mekatronik-achmadi/spion_selector/docs/docs.tex

\documentclass[11pt,fleqn]{book} % Default font size and left-justified equations

\usepackage[top=3cm,bottom=3cm,left=3.2cm,right=3.2cm,headsep=10pt,a4paper]{geometry} % Page margins

\usepackage{xcolor} % Required for specifying colors by name
\definecolor{ocre}{RGB}{243,102,25} % Define the orange color used for highlighting throughout the book

% Font Settings
\usepackage{avant} % Use the Avantgarde font for headings
%\usepackage{times} % Use the Times font for headings
\usepackage{mathptmx} % Use the Adobe Times Roman as the default text font together with math symbols from the Sym­bol, Chancery and Com­puter Modern fonts

\usepackage{microtype} % Slightly tweak font spacing for aesthetics
\usepackage[utf8]{inputenc} % Required for including letters with accents
\usepackage[T1]{fontenc} % Use 8-bit encoding that has 256 glyphs

% Bibliography
% \usepackage[style=alphabetic,sorting=nyt,sortcites=true,autopunct=true,babel=hyphen,hyperref=true,abbreviate=false,backref=true,backend=biber]{biblatex}
% \addbibresource{bibliography.bib} % BibTeX bibliography file
% \defbibheading{bibempty}{}

% Index
\usepackage{calc} % For simpler calculation - used for spacing the index letter headings correctly
% \usepackage{makeidx} % Required to make an index
% \makeindex % Tells LaTeX to create the files required for indexing

%----------------------------------------------------------------------------------------

\input{structure} % Insert the commands.tex file which contains the majority of the structure behind the template

\newcommand{\itab}[1]{\hspace{0em}\rlap{#1}}
\newcommand{\tab}[1]{\hspace{.2\textwidth}\rlap{#1}}

\begin{document}

\begingroup
\thispagestyle{empty}
  \AddToShipoutPicture*{\put(6,5){}} % Image background
  \centering
  \vspace*{9cm}
  \par\normalfont\fontsize{35}{35}\sffamily\selectfont
  Bad Rear View Mirror Rejection System\par % Book title
  \vspace*{1cm}
  {\Huge Rancangan Teknis}\par % Author name
  \vspace*{1cm}
  {\large Laboratorium Rekayasa Fotonika}\par
  {\large Teknik Fisika}\par
  {\large Institut Teknologi Sepuluh November}\par
  {\large 2014}\par
\endgroup

\newpage
~\vfill
\thispagestyle{empty}
% \noindent Copyright \copyright\ 2013 John Smith\\ % Copyright notice
% \noindent \textsc{Published by Publisher}\\ % Publisher
% \noindent \textsc{book-website.com}\\ % URL
\noindent Written by Achmadi @2014 \\
\noindent Licensed under the Creative Commons Attribution-NonCommercial 3.0 Unported License (the ``License''). You may not use this file except in compliance with the License. You may obtain a copy of the License at \url{http://creativecommons.org/licenses/by-nc/3.0}. Unless required by applicable law or agreed to in writing, software distributed under the License is distributed on an \textsc{``as is'' basis, without warranties or conditions of any kind}, either express or implied. See the License for the specific language governing permissions and limitations under the License.\\ % License information
% \noindent \textit{First printing, March 2013} % Printing/edition date

\newpage
\chapterimage{chapter_head_1.pdf} % Table of contents heading image
\pagestyle{empty} % No headers
\tableofcontents % Print the table of contents itself
\cleardoublepage % Forces the first chapter to start on an odd page so it's on the right
\pagestyle{fancy} % Print headers again

\newpage
\chapterimage{chapter_head_2.pdf} % Chapter heading image
\chapter{Development}
\section{Platform}
\begin{flushleft}
\hspace{10pt} Dalam proyek ini menggunakan platform yang bersifat opensources, kecuali dalam mendesain bagian mekanis.
Keuntungan dalam menggunakan platform yang bersifat opensources antara lain:

\itab{-Gratis dan Legal.}\\
\itab{-Dukungan penuh komunitas.}\\
\itab{-Kemudahan modifikasi software.}\\
\itab{-Kemampuan software opensources untuk development.}\\

\hspace{10pt} Untuk pihak pengembang lain yang berencana ikut mengembangkan dapat mengambil seluruh proyek di repository proyek berbasis Git di alamat:\\
\vspace{5pt}
\url{https://github.com/mekatronik-achmadi/spion\_selector}\\
\vspace{5pt}
\end{flushleft}

\section{Software}
\begin{flushleft}
 \hspace{10pt} Berikut adalah daftar aplikasi yang digunakan dalam proyek ini:\\
 \vspace{5pt}
 \textbf{LinuxMint}\\
 \hspace{10pt} LinuxMint adalah operating system yang berbasis kernel Linux dan paket manajemen Debian/Ubuntu.
 Disarankan untuk menggunakan sistem Graphical User Interface (GUI) jenis KDE, Cinnamon, maupun MATE.\\
 LinuxMint dapat di download di alamat:\\
 \vspace{5pt}
 \url{http://www.linuxmint.com/download.php}\\
 \vspace{5pt}
 Selain menggunakan LinuxMint, alternatif operating system lain yang disarankan adalah:\\
 \itab{-Ubuntu dengan GUI berjenis Unity. Dapat didownload di \url{http://www.ubuntu.com/download/desktop}}\\
 \itab{-Kubuntu dengan GUI berjenis KDE. Dapat didownload di \url{http://www.kubuntu.org/getkubuntu}}\\
 \itab{-Raspbian yang dijalankan di board RaspberryPi.}\\
 Dapat di didownload di \url{http://www.raspberrypi.org/downloads/}\\
 \vspace{5pt}
 \hspace{10pt} Operating system Raspbian dikhususkan untuk dijalankan di sistem tertanam (Embedded System) berbasis RaspberryPi, bukan untuk komputer/laptop umum.
 Raspbian merupakan operating system berbasis Debian sehingga secara teknis instalasinya akan sama dengan operating system lainnya.
 Namun tidak disarankan menggunakan Debian maupun turunan langsungnya (kecuali Raspbian) mengingat versi software yang tersedia kurang update.
 Untuk mengupdate daftar paket dari repository yang telah diatur, hubungkan LinuxMint ke internet dan gunakan perintah berikut di terminal:\\
 \vspace{5pt}
 \framebox[100pt]{sudo apt-get update}
 
 \vspace{5pt}
 \textbf{Octave}\\
 \hspace{10pt} GNU Octave adalah bahasa interpretasi (kebalikan dari kompilasi) level tinggi,utamanya digunakan untuk komputasi numerik. 
 GNU Octave menyediakan kemampuan untuk menemukan solusi numerik baik untuk masalah linear maupun non-linier, termasuk juga untuk experimen numerik. 
 Selain itu juga menyediakan kemampuan grafis yang memadai untuk visualisasi dan manipulasi data. 
 Octave secara umum digunakan melalui interface terminal yang interaktif, tapi dapat pula digunakan untuk program non-interaktif. 
 Bahasa interpretasi Octave sangat mirip dengan Matlab sehingga skrip dari kedua software tersebut dapat saling bertukar.
 Octave memiliki kemampuan setara dengan Matlab,sekalipun belum memiliki fitur seperti Simulink dan GUI.
 
 \hspace{10pt} Octave pertama kali ditulis oleh John W. Eaton ditahun 1988 dalam bahasa C++. 
 Octave dirilis oleh GNU Project, sebuah proyek international pengembangan software gratis dan opensource yang dipimpin oleh R. Stallman. 
 Kini Octave telah menjadi software yang dapat dijalankan di Linux, Windows, Mac,maupun Android. 
 Octave tersedia dalam 19 bahasa berbeda dengan English US sebagai bahasa default. 
 Octave dirilis sebagai software OpenSource dengan lisensi GNU GPL sehingga bersifat legal dan gratis.
 Penjelasan lebih lanjut akan dilanjutkan di bab Octave tersendiri.\\
 
 \hspace{10pt} Lebih lanjut tentang octave dapat dikunjungi di situs wiki: \url{http://wiki.octave.org/Main_Page}.
 
 \vspace{5pt}
 \textbf{OpenCV}\\
 \hspace{10pt} Pustaka OpenCV (Open Computer Vision) merupakan pustaka pemrograman berbasis C/C++/Python yang berisi fungsi-fungsi untuk akuisisi dan pengolahan citra.
  Pustaka OpenCV juga merupakan proyek opensource yang bersifat gratis.
  Saat ini pustaka OpenCV telah diterapkan di banyak website dan aplikasi mobile untuk deteksi wajah dan penjejak warna.
  Dalam proyek ini, OpenCV tidak digunakan untuk mengolah gambar namun sebatas untuk mengambil gambar.
  Bersama dengan Qt (C++), OpenCV ini dibentuk menjadi satu aplikasi untuk berkomunikasi dengan kamera melalui jalur USB dan mengambil gambar.
  Penjelasan lebih lanjut akan dilanjutkan di bersama dalam bab Octave tersendiri.\\
  
  \hspace{10pt} Lebih lanjut tentang opencv dapat dikunjungi di situs resmi: \url{http://opencv.org/}.
  
 \vspace{5pt}
 \textbf{GCC}\\
 \hspace{10pt} GCC (GNU Compiler Collection) merupakan koleksi kompiler yang di rilis oleh proyek GNU.
 Kompiler merupakan program yang mengkonversi kode sumber menjadi program siap jalan.
 Saat ini GCC mendukung bahasa C, C++, Java, dan banyak bahasa lain.
 Selain itu GCC juga mendukung banyak arsitektur seperti i386, amd64, armhf, arm-eabi, dan banyak arsitektur lain.
 Dalam proyek ini digunakan dua jenis varian GCC, yaitu g++ dan arm-gcc-none-eabi.
 Varian g++ digunakan untuk mengkompilasi program berbasis OpenCV untuk pengambilan gambar.
 Sedangkan varian arm-gcc-none-eabi digunakan untuk mengkompilasi program yang akan ditanamkan di sirkuit pengendali tangan robot.
 Penjelasan lebih lanjut tentang arm-gcc-none-eabi akan dilanjutkan di bersama dalam bab RTOS tersendiri.\\
 
 \hspace{10pt} Lebih lanjut tentang GCC dapat dikunjungi di situs resmi: \url{https://gcc.gnu.org/}.
 
 \vspace{5pt}
 \textbf{Qt Creator}\\
 \hspace{10pt} Qt Creator merupakan salah satu IDE (Integrated Development Environment) yang digunakan secara luas terutama untuk pengembangan software berbasis Qt.
 Qt sendiri adalah kerangka kerja (framework) pengembangan software berbasis opensource yang memiliki fitur terlengkap dibandingkan framework lain sperti GTK,FLTK,dst.
 Qt Creator merupakan IDE untuk proses penulisan dan pengecekan program, namun membutuhkan kompiler seperti GCC, g++, maupun arm-gcc untuk dapat mengkompilasi.
 Dalam proyek ini Qt Creator digunakan dalam penulisan program untuk pengambilan gambar dan program yang ditanamkan di dalam chip.
 
 \hspace{10pt} Lebih lanjut tentang Qt Creator dapat dikunjungi di situs resmi: \url{https://qtcreator/}.
 \vspace{5pt}
 \textbf{EAGLE}\\
 \hspace{10pt} EAGLE (Easy Applicable Graphical Layout Editor) adalah software untuk mendesain papan circuit.
 Desain yang dibuat di EAGLE berupa skema dan layout.
 Versi yang dapat di instal secara gratis adalah versi Light dengan batasan:\\
 \vspace{5pt}
 \itab{-Luas maximal papan adalah 100mmx80mm.}\\
 \itab{-Hanya dapat menggunakan 2 Lapisan, yaitu Top dan Bottom.}\\
 \itab{-Fitur AutoRoute tidak tersedia.}\\
 \vspace{5pt}
 Namun diluar batasan tadi, fitur EAGLE dapat digunakan secara penuh, terutama ketersedian pustaka komponen yang sangat lengkap.
 Penjelasan lebih lanjut akan dilanjutkan di bab Elektronik tersendiri.\\
 
 \hspace{10pt} Lebih lanjut tentang EAGLE dapat dikunjungi di situs resmi: \url{http://www.cadsoftusa.com/}.
 
 \vspace{5pt}
 \textbf{SolidWork}\\
 \hspace{10pt} SolidWork merupakan salah satu software CAD (Computer Aided Design) yang telah populer di perusahan-perusahan besar.
 Software ini digunakan untuk mendesain sistem fisik dan mekanis dengan dukungan pustaka yang sangat lengkap.
 Dalam proyek ini, software ini digunakan untuk mendesain sistem mekanis tangan robot.
 Versi yang digunakan adalah 2013 dan SolidWork tergolong software yang tidak \textit{Backward Compatible}.
 Software ini merupakan satu-satunya software berbayar yang digunakan dalam proyek ini.
 Pembahasan lebih lanjut hanya akan difokuskan pada desain mekanisnya. 
 Namun tentang software tidak dibahas lebih jauh mengingat sifatnya yang tidak gratis dan dijalankan di platform Windows 7.\\
 
 \hspace{10pt} Lebih lanjut tentang octave dapat dikunjungi di situs resmi: \url{http://www.solidworks.com/}.

\end{flushleft}

\section{License}
\hspace{10pt} Proyek ini memiliki lisensi bervariasi mengingat seluruh resources yang digunakan merupakan turunan dari banyak proyek opensource lain.
Namun mengingat kemiripan dan kompatibilitas antar jenis lisensi (terutama jenis MIT, Apache, GPL dan LPGL) maka pengembang menentukan lisensi dari seluruh proyek ini adalah GPL v2.
Lebih lanjut tentang lisensi dapat dilihat di alamat: \url{http://opensource.org/licenses/}

\newpage
\chapterimage{chapter_head_2.pdf} % Chapter heading image
\chapter{Mekanik}
\section{Gripper}
\begin{center}
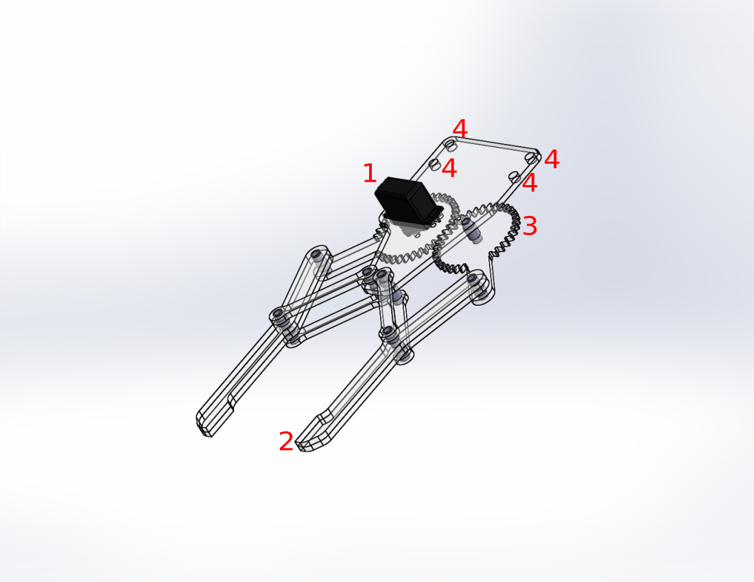
[picture p2: docs/screenshot/arm/GA.png]
 \\
\end{center}
\begin{center}
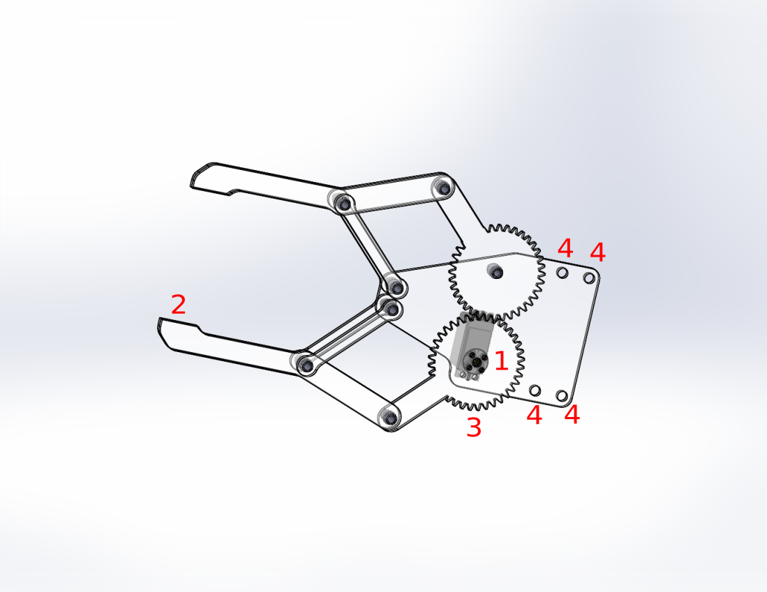
[picture p3: docs/screenshot/arm/GA1.png]
 \\
\end{center}
\section{Arm}
\begin{center}
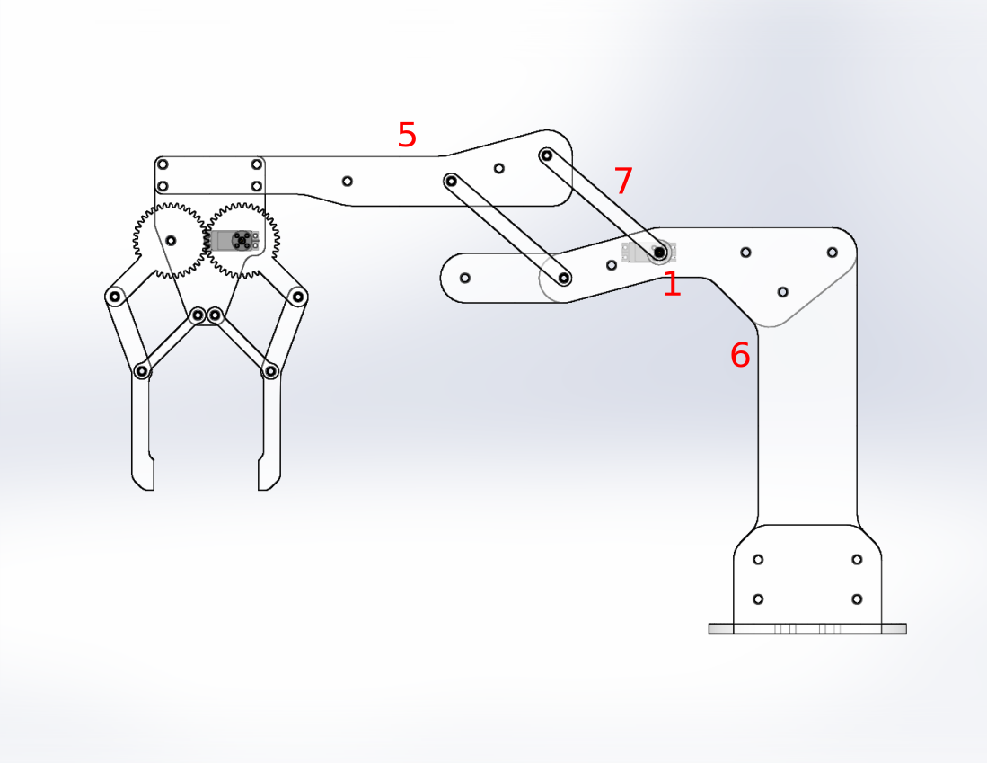
[picture p4: docs/screenshot/arm/GAF.png]
 \\
\end{center}
\begin{center}
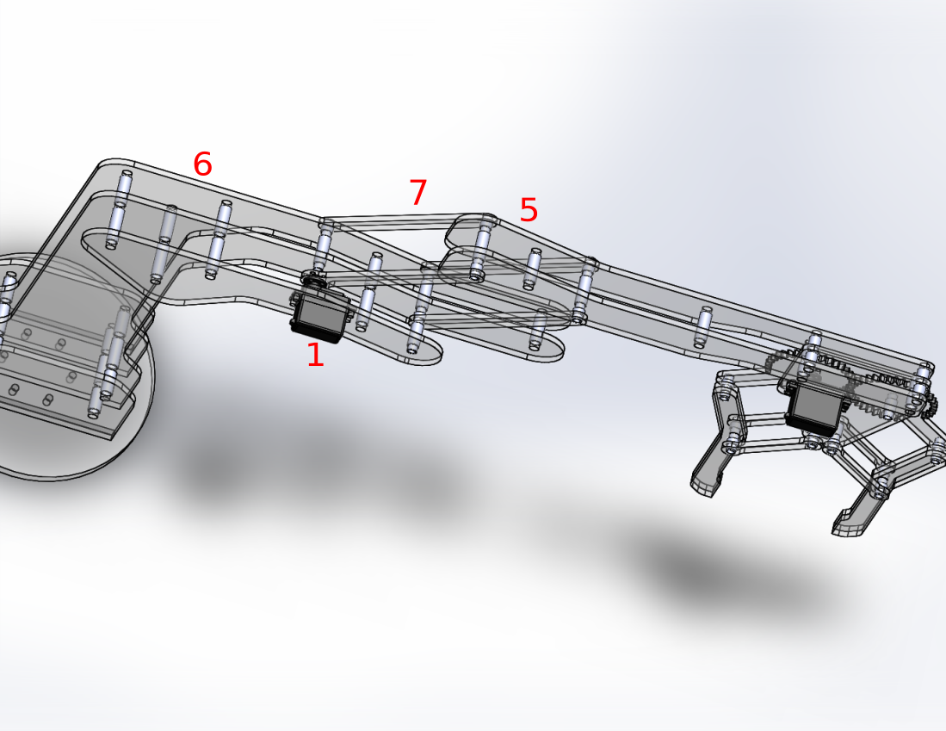
[picture p5: docs/screenshot/arm/GAF1.png]
 \\
\end{center}
\section{Meja}

\newpage
\chapterimage{chapter_head_2.pdf} % Chapter heading image
\chapter{Elektronik}
\section{Servo}
\begin{center}
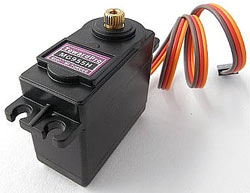
[picture p6: docs/screenshot/komponen/servo.jpg]
 \\
\end{center}
\section{SPS}
\begin{center}
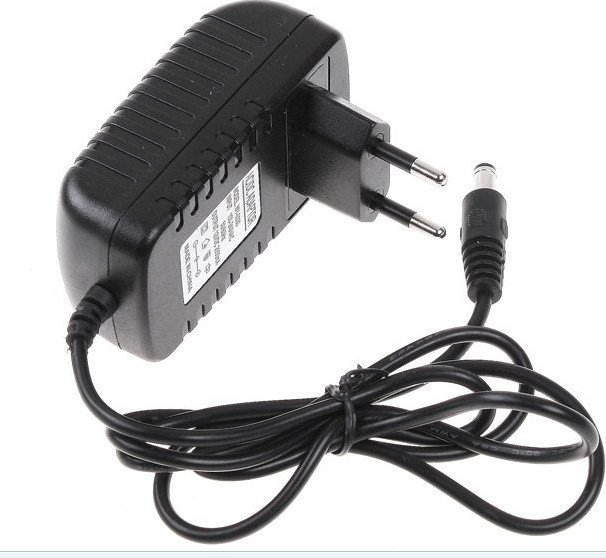
[picture p7: docs/screenshot/komponen/sps.jpg]
 \\
\end{center}
\section{Wiring}
\begin{flushleft}
\hspace{10pt} Secara global, sistem tangan robot yang digunakan memiliki bagian utama yaitu:\\
\itab{-Servo sebanyak 2 unit.}\\
\itab{-Controller sebanyak 1 unit.}\\
\itab{-SPS sebanyak 1 unit.}\\
\itab{-Komputer sebanyak 1 unit.}\\
\hspace{10pt} Untuk koneksi antara Controller dengan bagian-bagian lainnya dijelaskan seperti berikut:\\
\itab{-Wiring antara Controller dan masing-masing servo memiliki 3 jalur yaitu jalur positif 6 volt, ground, dan sinyal.}\\
\itab{-Wiring antara Controller dan SPS memiliki 2 jalur yaitu jalur positif 6 volt dan ground.}\\
\itab{-Wiring antara Controller dan Komputer memiliki 4 jalur yaitu jalur positif 5 volt, ground, USB data postif, dan USB data negatif.}\\
\hspace{10pt} Perlu diketahui bahwa ground SPS dan Servo terhubung, sedangkan dengan Komputer terpisah. 
Perlu diketahui pula bahwa arus di jalur Komputer hanya 500mA, sedangkan di jalur SPS dan servo mencapai 2 Ampere.
Untuk memudahkan maka berikut skema dari penjelasan diatas:\\
\begin{center}
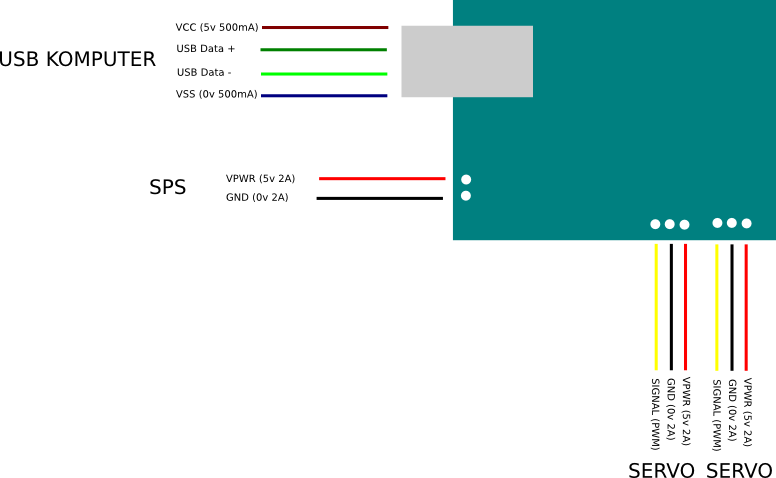
[picture p8: docs/screenshot/wiring/wiring.png]
 
\end{center}
\hspace{10pt} Sedangkan untuk Kamera dan Komputer terhubung secara langsung melalui jalur USB.
\end{flushleft}

\section{PCB}
\begin{flushleft}
 \hspace{10pt} PCB atau printed circuit board adalah papan yang telah dicetak jalur tembaga sebagai tempat komponen elektronik disolder dan jalur elektrisnya.
Untuk dapat membuat PCB Controller yang digunakan dalam proyek ini maka diperlukan berikut ini:\\
\itab{-Software CAD (Computer Aided Design).}\\
\itab{-PCB Manufaktur.}\\
\vspace{5pt}
\hspace{10pt} Untuk PCB Manufaktur disini dipercayakan kepada CV. Maxtron Persada Indonesia.
Perusahan ini merupakan perusahaan nasional yang bergerak di bidang manufaktur PCB kualitas tinggi dan penyedia mesin CNC untuk produksi PCB.
Alasan mengapa dipilih perusahaan ini selain karena hasil manufakturnya yang berkualitas juga letaknya yang masih area Surabaya-Sidoarjo.
Untuk informasi lebih lanjut dapat kunjungi situs resmi:\url{http://www.maxtronpersada.com/}\\
\vspace{5pt}
\hspace{10pt} Selanjutnya adalah Software Computer Aided Design. 
Software CAD digunakan untuk mendesain baik skematik maupun layout sebelum di kirim ke perusahaan manufaktur PCB.
Software CAD untuk PCB yang digunakan disini adalah EAGLE.
Untuk menginstal EAGLE di LinuxMint dari internet dengan mengetikkan di terminal:\\
\vspace{5pt}
\framebox[150pt]{sudo apt-get install eagle}\\
\vspace{5pt}
Berikut adalah tampilan software EAGLE:
\begin{center}
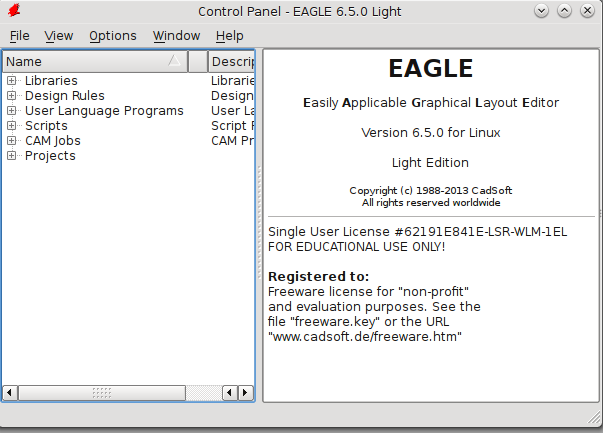
[picture p9: docs/screenshot/pcb/eagle.png]
 \\
\end{center}
\vspace{5pt}
Berikut adalah gambar skema PCB Controller yang dibuka dengan EAGLE schmeatic:
\begin{center}
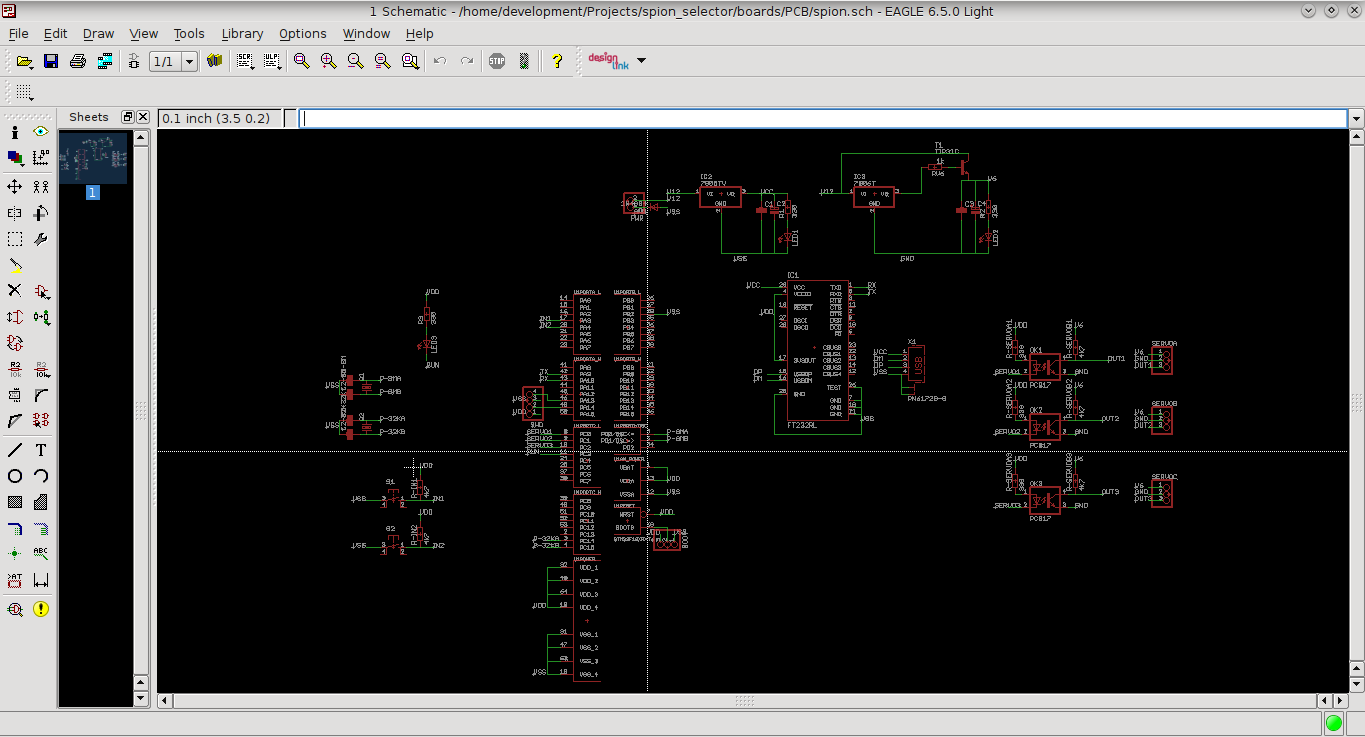
[picture p10: docs/screenshot/pcb/eagle1.png]
 \\
\end{center}
Berikut adalah gambar skema PCB Controller yang dibuka dengan EAGLE boards:
\begin{center}
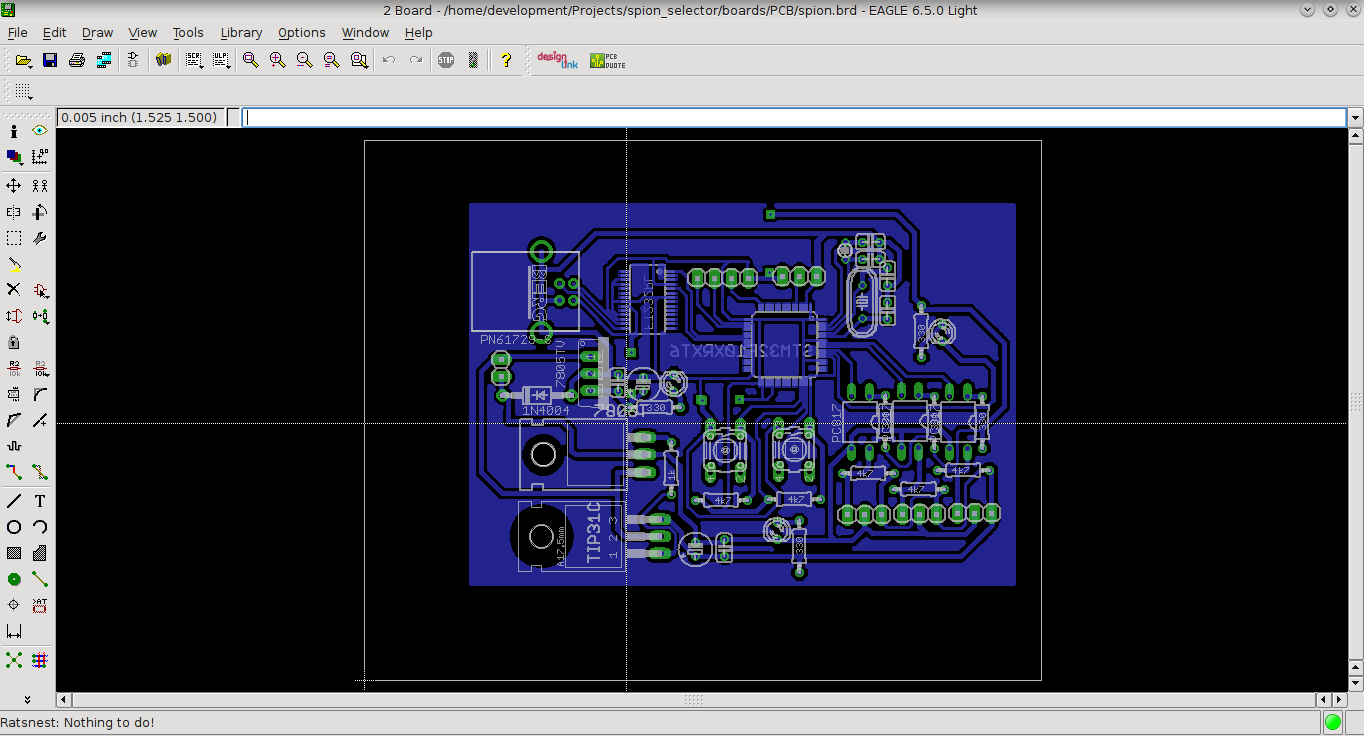
[picture p11: docs/screenshot/pcb/eagle2.png]
 
\end{center}
Berikut ilustrasinya secara 3D di posisi TOP dan BOTTOM:
\begin{center}
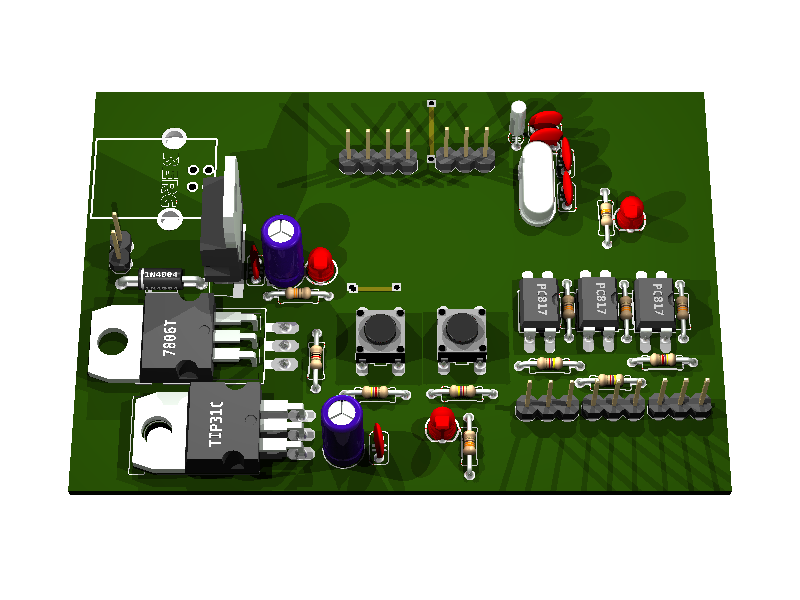
[picture p12: docs/screenshot/pcb/spion_3d_up.png]
 
\end{center}
\begin{center}
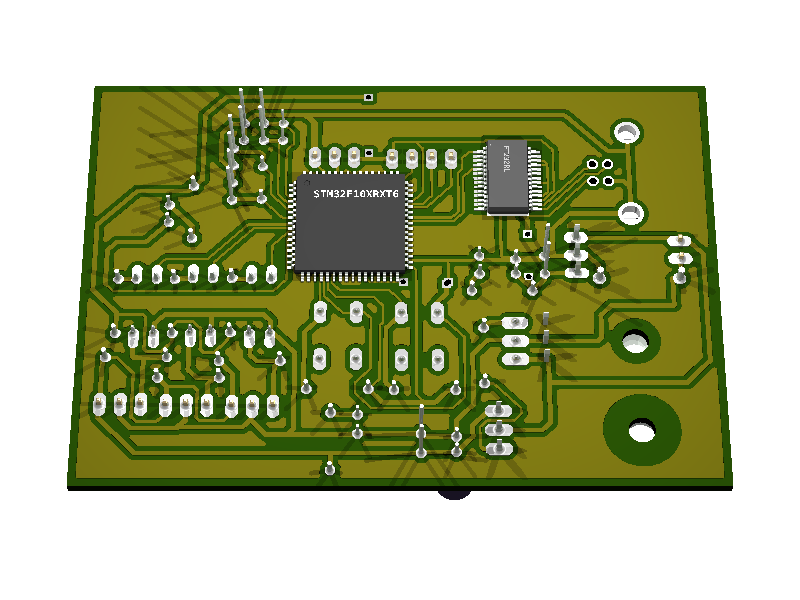
[picture p13: docs/screenshot/pcb/spion_3d_down.png]
 \\
\end{center}
Selanjutnya adalah beberapa bagian penting dari skema PCB Controller:\\
\vspace{5pt}
 \textbf{Pembangkit Clock}\\
 \hspace{10pt} Pembangkit clock ini digunakan untuk membangkitkan pulsa elektrik yang akan digunakan sebagai acuan chip kontroller bekerja:
 Terbagi dalam dua jenis frekuensi:\\
 \itab{-32khz digunakan ketika chip utama di program}\\
 \itab{-8mhz digunakan ketika chip utama berproses}\\
 Berikut adalah potongan gambar skema PCB Controller yang menunjukkan bagian Pembangkit Clock:
\begin{center}
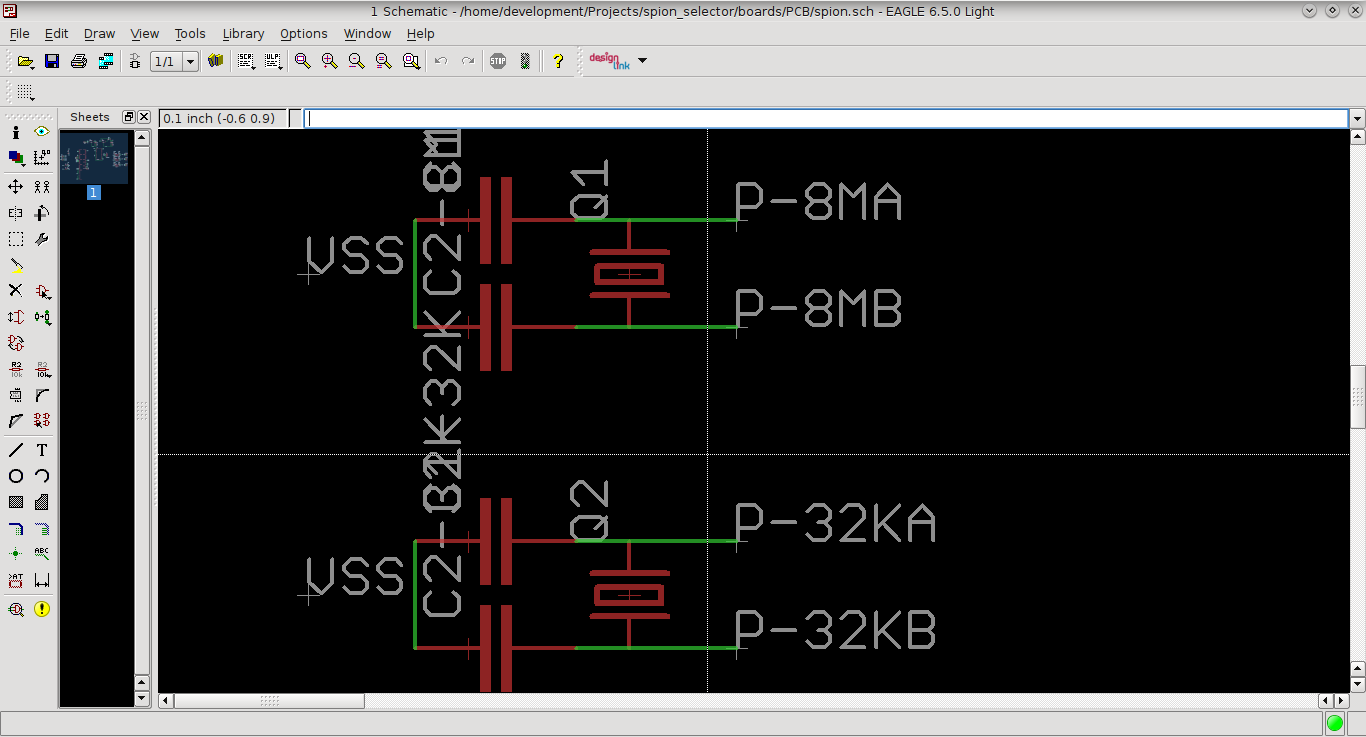
[picture p14: docs/screenshot/pcb/eagle3.png]
 \\
\end{center}
Berikut adalah potongan bagian tersebut dalam ilustrasi PCB 3D bagian TOP:
\begin{center}
 \\
\end{center}
\vspace{5pt}
 \textbf{Servo Signal Brigde}\\
 \hspace{10pt} Dalam mengoperasikan aktuator servo, diperlukan komponen sebagai jembatan sinyal antara chip utama dan servo.
 Beberapa alasan dibutuhkan jembatan sinyal adalah:\\
 \itab{-Level tegangan chip utama adalah 3,3v sedangkan servo adalah 6 volt.}\\
 \itab{-Chip utama bekerja pada arus dibawah 500mA sedangkan servo diatas 1A.}\\
 \itab{-Servo menghasilkan induksi balik sehingga chip utama dan servo perlu memiliki acuan tegangan 0 terpisah.}\\
 \hspace{10pt} Untuk memenuhi kebutuhan inilah digunakan IC PC817 sebagai jembatan antara chip utama dan servo.
 Komponen PC817 terdiri dari LED (untuk sisi chip) dan PhotoTransistor (untuk sisi servo).
 Mekanisme kerja PC817 adalah switch PhotoTransistor di kendalikan oleh sinyal cahaya dari LED.
 Oleh karena sinyal antara sisi LED dan PhotoTransistor bukan sinyal elektris (melainkan cahaya), 
 maka LED dan PhotoTransistor dapat bekerja di level tegangan, arus dan acuan tegangan yang terpisah.
  Berikut adalah potongan gambar skema PCB Controller yang menunjukkan bagian Servo Signal Brigde:
\begin{center}
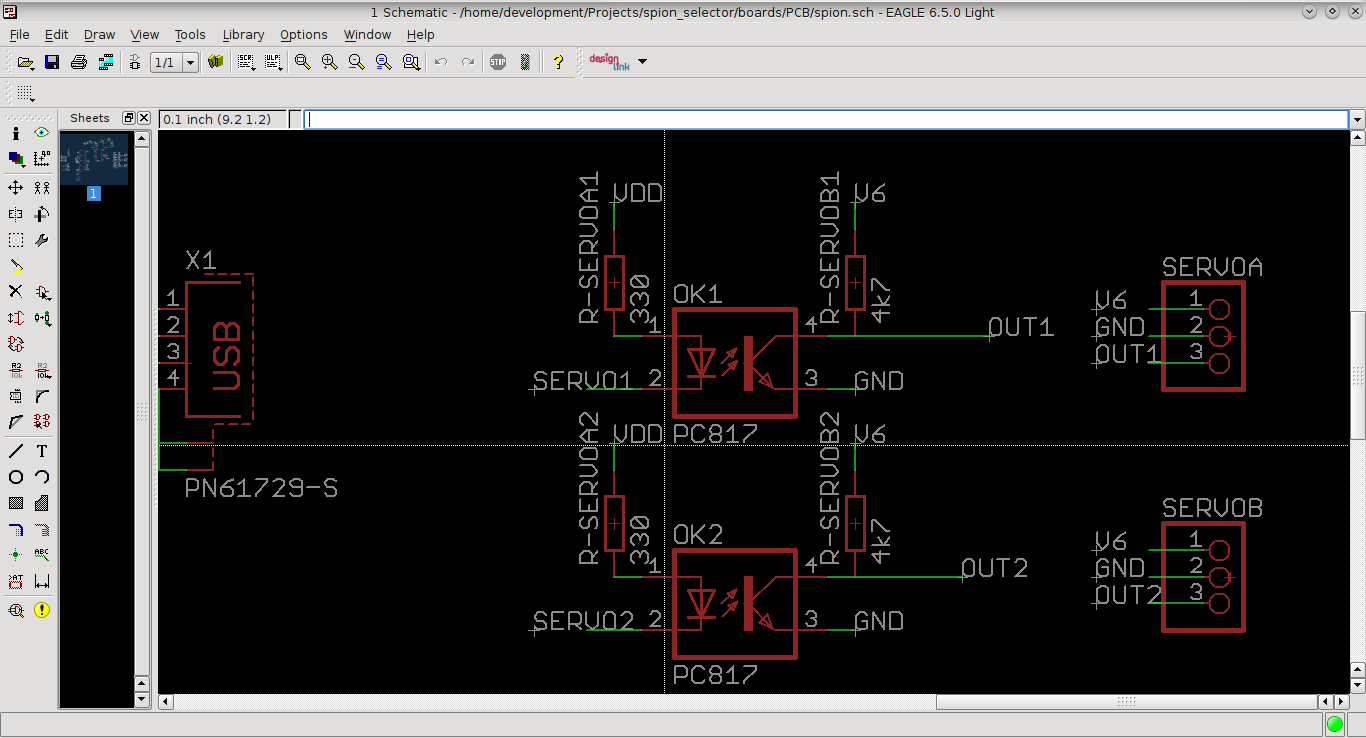
[picture p15: docs/screenshot/pcb/eagle5.png]
 \\
\end{center}
Berikut adalah potongan bagian tersebut dalam ilustrasi PCB 3D bagian TOP:
\begin{center}
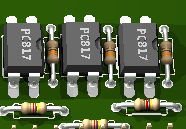
[picture p16: docs/screenshot/pcb/eagle6.png]
 \\
\end{center}
\vspace{5pt}
 \textbf{Power Regulator}\\
 \hspace{10pt}Power Regulator merupakan bagian opsional yang berfungsi untuk mengatur tegangan tenaga yang masuk ke circuit agar sesuai dengan kebutuhan.
 Disini digunakan dua jenis IC regulator:\\
 \itab{-7806 untuk tenaga ke servo sebesar 6 volt.}\\
 \itab{-7805 untuk rangkaian ke chip sebesar 5 volt.}\\
 \hspace{10pt}Pada setiap segmen telah ditambahkan LED untuk indikator dan Electrolite Capacitor untuk menstabilkan tegangan.
 Arus yang dikeluar di setiap IC adalah 1A.
 Khusus untuk servo, digunakan pula Transistor TIP 31C untuk menambahkan arus ke servo dengan sumber arus asli.
 Namun dalam proyek ini, segmen ini tidak digunakan karena digantikan oleh:\\
 \itab{-Untuk servo tenaga diperoleh dari SPS sebesar 5 volt 2 Ampere.}\\
 \itab{-Untuk chip tenaga diperoleh dari USB Komputer sebesar 5 volt 500mA.}\\
   Berikut adalah potongan gambar skema PCB Controller yang menunjukkan bagian Power Regulator:
\begin{center}
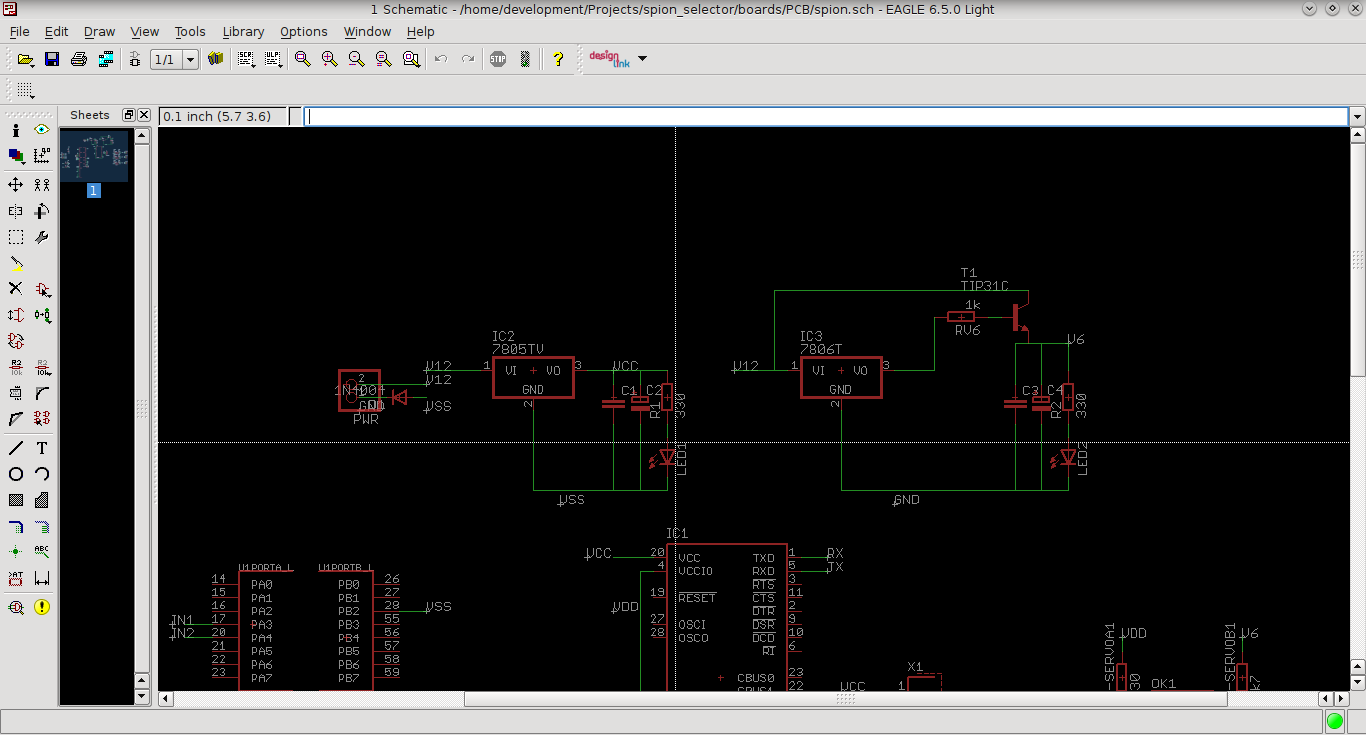
[picture p17: docs/screenshot/pcb/eagle7.png]
 \\
\end{center}
Berikut adalah potongan bagian tersebut dalam ilustrasi PCB 3D bagian TOP:
\begin{center}
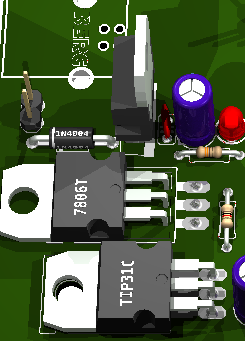
[picture p18: docs/screenshot/pcb/eagle8.png]
 \\
\end{center}
\vspace{5pt}
\hspace{10pt} Untuk komponen chip digital (STM32 dan FTDI akan dijelaskan pada bab selanjutnya.)
\end{flushleft}

\section{Kamera}
\begin{flushleft}
 \hspace{10pt} Kamera yang digunakan adalah Logitech C190.
\end{flushleft}

\newpage
\chapterimage{chapter_head_2.pdf} % Chapter heading image
\chapter{Controller}
\section{STM32}
\begin{flushleft}
 \hspace{10pt} STM32 adalah microcontroller 32bit yang kini telah digunakan di hampir semua instrumen.
 STM32 adalah salah satu produk dari ST Microelectronic Inc, sebuah perusahaan semikonduktor asal Italia.
 STM32 memiliki fitur lengkap dengan CPU 32bit plus FPU dan register-register baik 32bit, 16bit, 12bit, maupun 8bit.
 Berikut beberapa data STM32 secara umum:\\
 
 \hspace{10pt} Untuk jenis STM32 yang digunakan dalam proyek ini adalah STM32F103RBT6.
 Berikut adalah gambar mapping pin yang digunakan:
 \begin{center}
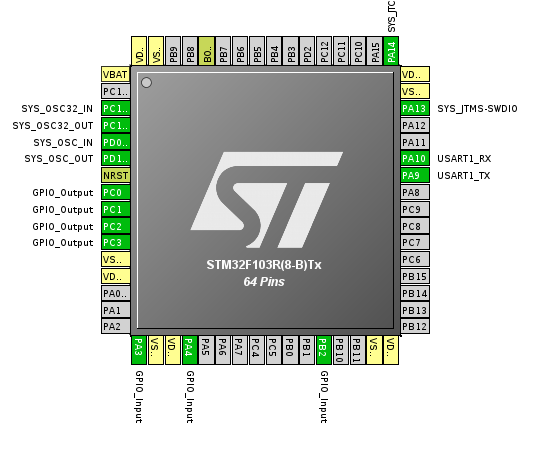
[picture p19: docs/screenshot/stm32/stm32_pin.png]
 \\
\end{center}
Berikut adalah gambar skematik STM32 di circuit Controller:
 \begin{center}
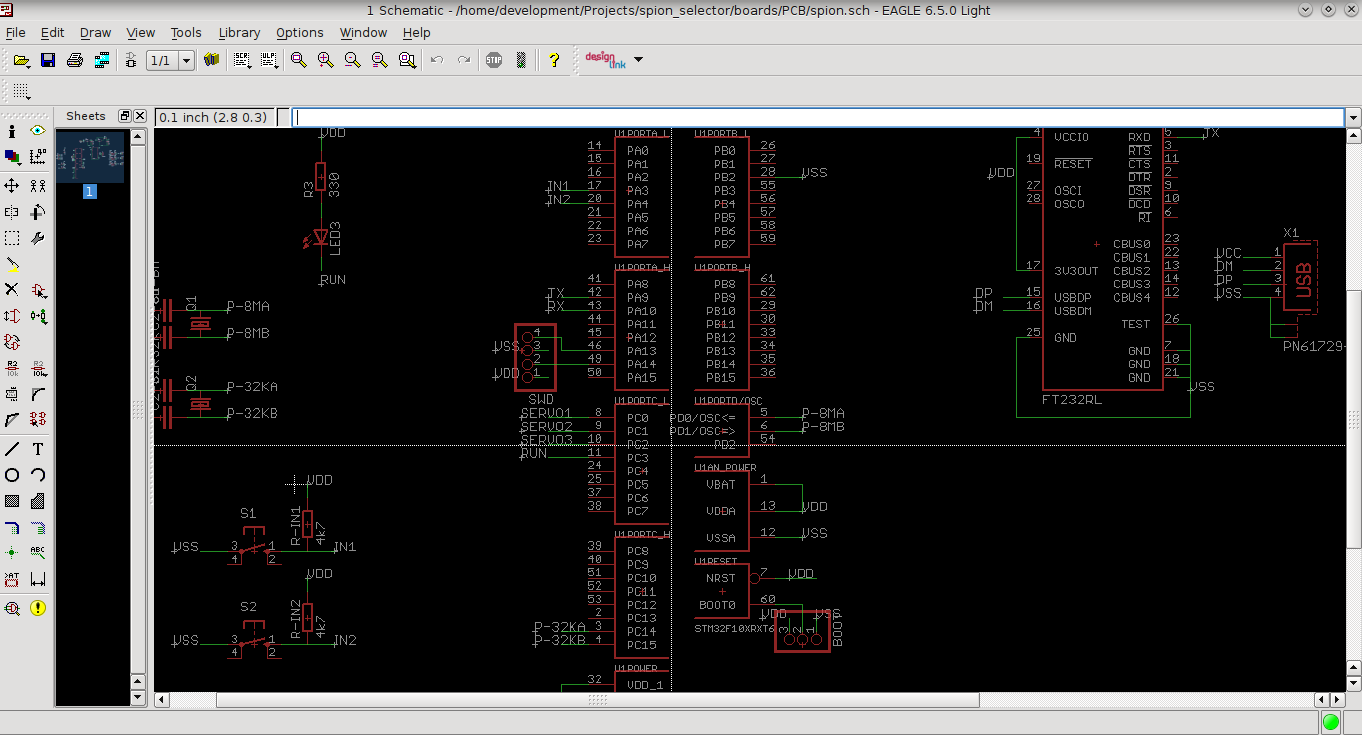
[picture p20: docs/screenshot/stm32/stm321.png]
 \\
\end{center}
Berikut adalah potongan bagian tersebut dalam ilustrasi PCB 3D bagian BOTTOM:
 \begin{center}
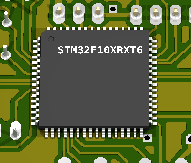
[picture p21: docs/screenshot/stm32/stm322.png]
 \\
\end{center}
\end{flushleft}

\section{FTDI}

\newpage
\chapterimage{chapter_head_2.pdf} % Chapter heading image
\chapter{RTOS}
\section{HAL}
\begin{flushleft}
 \hspace{10pt} Pada bagian ini akan dijelaskan tentang HAL (Hardware Abstraction Layer) yang digunakan dalam proyek ini.
 Karena penjelasan ini adalah bagian dari RTOS (Real Time Operating System) yang akan ditanamkan di chip controller, 
 maka diperlukan software Qt Creator untuk membuka file-file kode sumber yang ada di folder project.
 Untuk menginstal Qt Creator di LinuxMint dari internet dengan mengetikkan di terminal:\\
\vspace{5pt}
\framebox[300pt]{sudo apt-get install qtcreator qtdeclarative5-qtquick2-plugin}\\
\vspace{5pt}
\hspace{10pt} RTOS adalah kependekan dari Real Tipe Operating System.
RTOS disini yang digunakan ChibiOS yang merupakan sekumpulan template kode sumber dalam bahasa C dan Makefile untuk membuat firmware multitask pada sistem ARM.
Lebih lanjut tentang ChibiOS dapat dilihat di alamat: \url{http://chibios}
\hspace{10pt} Sementara HAL itu sendiri adalah kependekan dari Hardware Abstraction Layer.
HAL merupakan fitur pada RTOS yang memungkinkan pengembang tidak harus menggunakan register-register low level dalam membuat firmwarenya.
Register low level sifatnya sangat bergantung kepada tipe dan merek chip sekalipun sama-sama memiliki arsitektur ARM.
Untuk itulah dibuat fitur HAL sehingga pada level tertinggi dari hirarki fungsi, pengembang dapat menggunakan fungsi-fungsi yang sama untuk beragam tipe dan mereka chip selama telah RTOS memiliki HAL-nya.

\hspace{10pt} Selanjutnya adalah membuka file bertipe *.creator.
Maka akan muncul tampilan seperti berikut:
\newpage
 \begin{center}
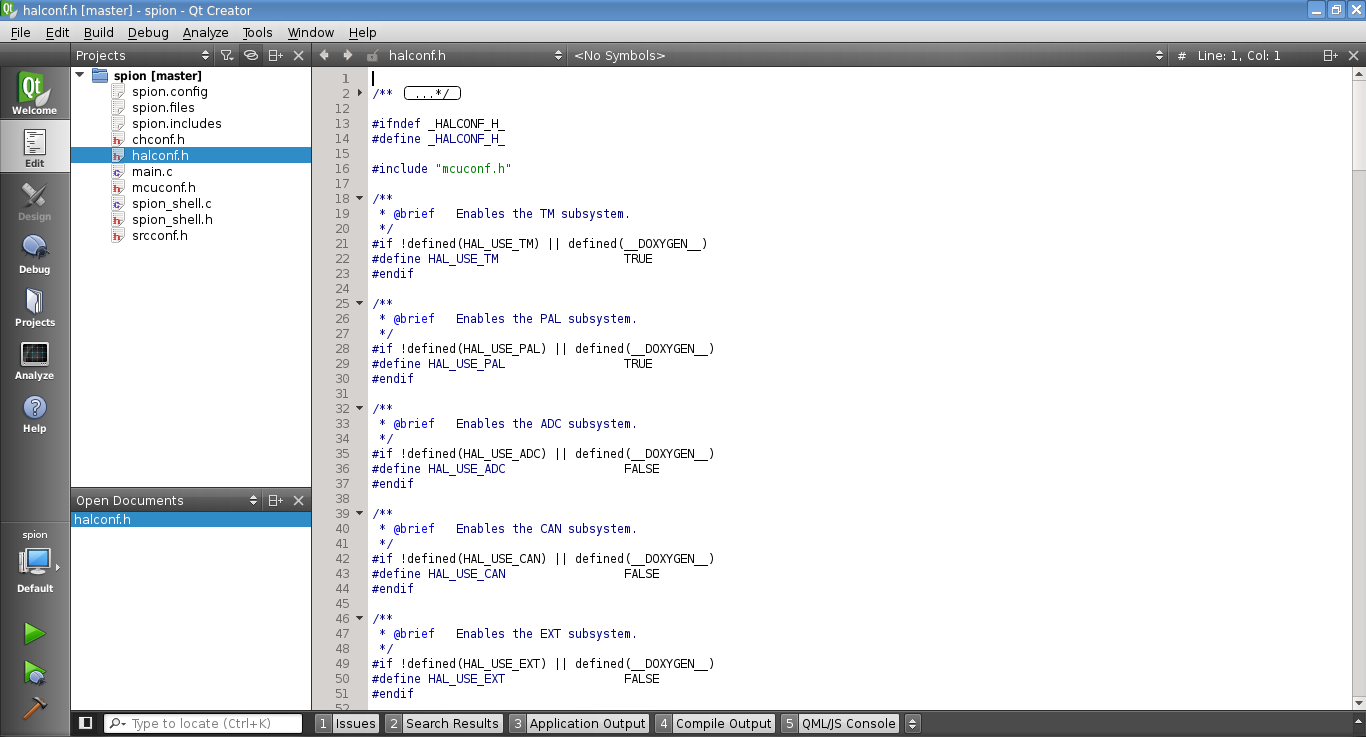
[picture p22: docs/screenshot/rtos/hal1.png]
 \\
\end{center}
\hspace{10pt} Pembahasan hanya difokuskan pada kode dasar (codebase) yang ditulis oleh pengembang.
Sedangkan untuk kode sisanya dapat menggunakan template untuk seri STM32F103 yang telah disiap oleh pengembang ChibiOS/RT.
Sebelum mengatur HAL pengembang menyarankan agar membuka dulu file chconf.c yang berisi pengaturan terhadap kernel ChibiOS/RT.
Disarankan untuk mematikan seluruh opsi Debugging untuk mengurangi konsumsi memory flash dan SRAM kecuali jika memang dibutuhkan.
 \begin{center}
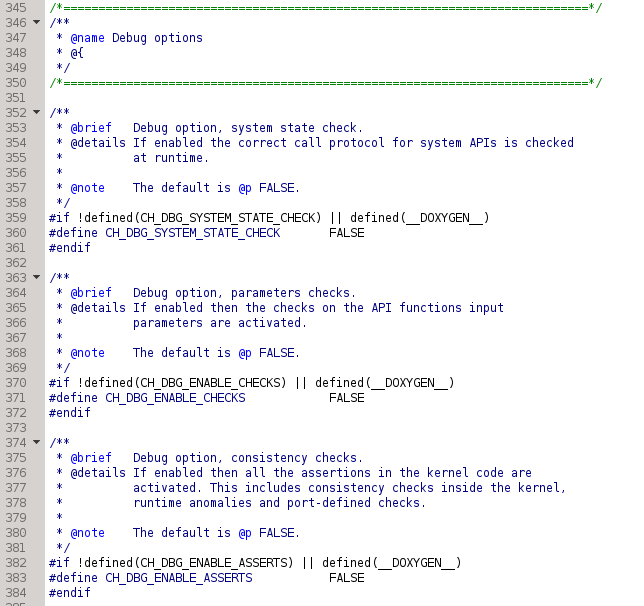
[picture p23: docs/screenshot/rtos/hal2.png]
 \\
\end{center}
\end{flushleft}

\section{Threads}

\section{Commands}

\newpage
\chapterimage{chapter_head_2.pdf} % Chapter heading image
\chapter{Octave}
\section{Instalasi}
\section{Image Processing}
\section{Mekanisme}

\end{document}
