mekatronik-achmadi/spion_selector/docs/docs.pdf

# Bad Rear View Mirror Rejection System

# Rancangan Teknis

Laboratorium Rekayasa Fotonika

| Teknik Fisika

Institut Teknologi Sepuluh November

| 2014

Written by Achmadi @2014
Licensed under the Creative Commons Attribution-NonCommercial 3.0 Unported License (the “License”). You may not use this file except in compliance with the License. You may ob-tain a copy of the License at http://creativecommons.org/licenses/by-nc/3.0. Unless required by applicable law or agreed to in writing, software distributed under the License is
distributed on an “AS IS” BASIS, WITHOUT WARRANTIES OR CONDITIONS OF ANY KIND,
either express or implied. See the License for the specific language governing permissions and limitations under the License.

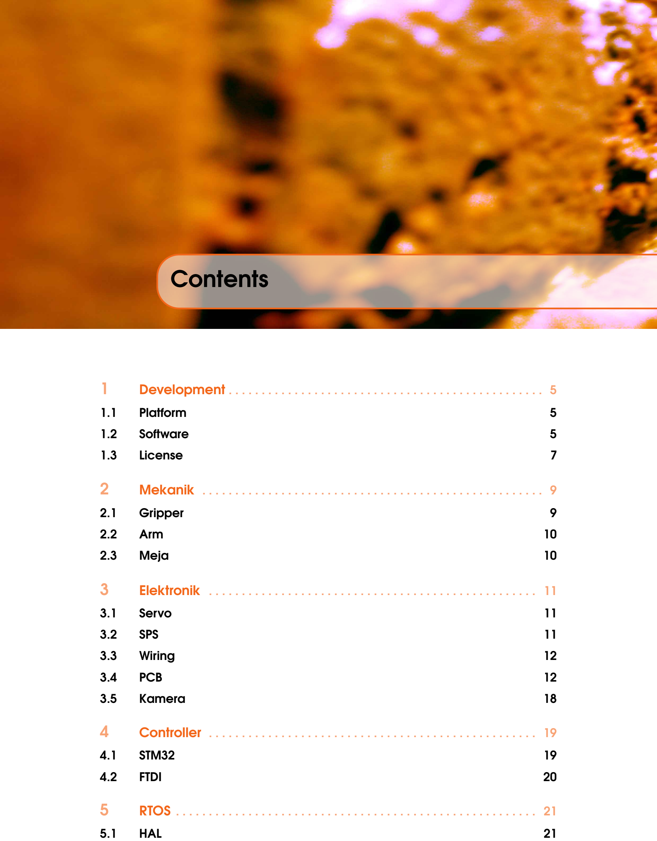
[picture p40: page 3]

# Contents

1.1 | Platform | 5
1.2 | Software | 5
1.3 | License | 7
2.1 | Gripper | 9
2.2 | Arm | 10
2.3 | Meja | 10
3.1 | Servo | 11
3.2 | SPS | 11
3.3 | Wiring | 12
3.4 | PCB | 12
3.5 | Kamera | 18
4.1 | STM32 | 19
4.2 | FTDI | 20
5.1 | HAL | 21

5.2 | Threads | 22
5.3 | Commands | 22 6 | Octave | 23
6.1 | Instalasi | 23
6.2 | Image Processing | 23
6.3 | Mekanisme | 23

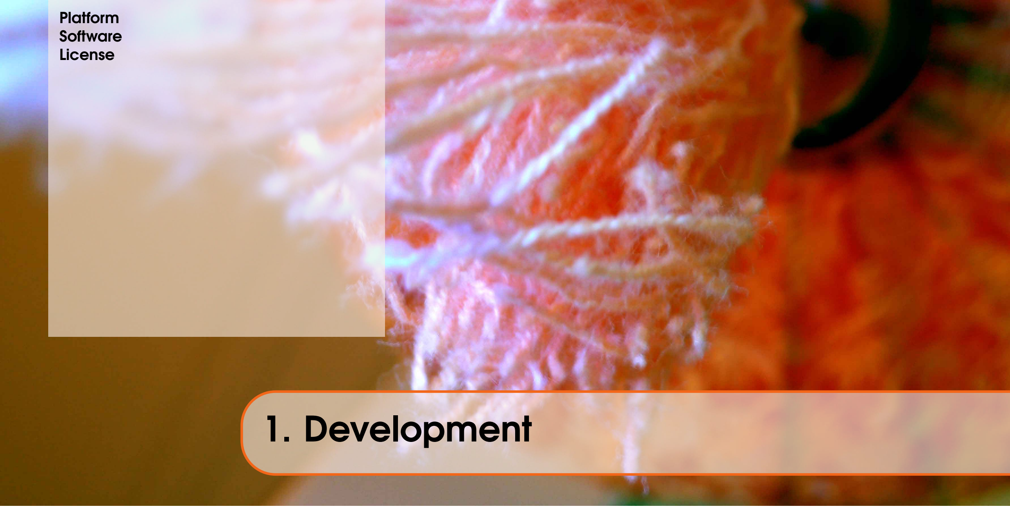
[picture p41: figure]
Platform Software License; 1. Development

### 1.1 Platform

Dalam proyek ini menggunakan platform yang bersifat opensources, kecuali dalam mendesain bagian mekanis. Keuntungan dalam menggunakan platform yang bersifat opensources antara lain:
-Gratis dan Legal.
-Dukungan penuh komunitas.
-Kemudahan modifikasi software.
-Kemampuan software opensources untuk development.
Untuk pihak pengembang lain yang berencana ikut mengembangkan dapat mengambil seluruh proyek di repository proyek berbasis Git di alamat:

https://github.com/mekatronik-achmadi/spion_selector

### 1.2 Software

Berikut adalah daftar aplikasi yang digunakan dalam proyek ini:

LinuxMint
LinuxMint adalah operating system yang berbasis kernel Linux dan paket manajemen Debian/Ubuntu. Disarankan untuk menggunakan sistem Graphical User Interface (GUI) jenis KDE, Cinnamon, maupun MATE.
LinuxMint dapat di download di alamat:

http://www.linuxmint.com/download.php

Selain menggunakan LinuxMint, alternatif operating system lain yang disarankan adalah:
-Ubuntu dengan GUI berjenis Unity. Dapat didownload di http://www.ubuntu.com/download/desktop -Kubuntu dengan GUI berjenis KDE. Dapat didownload di http://www.kubuntu.org/getkubuntu -Raspbian yang dijalankan di board RaspberryPi.
Dapat di didownload di http://www.raspberrypi.org/downloads/

Operating system Raspbian dikhususkan untuk dijalankan di sistem tertanam (Embedded
System) berbasis RaspberryPi, bukan untuk komputer/laptop umum. Raspbian merupakan operating system berbasis Debian sehingga secara teknis instalasinya akan sama dengan

6 | Chapter 1. Development

operating system lainnya. Namun tidak disarankan menggunakan Debian maupun turunan langsungnya (kecuali Raspbian) mengingat versi software yang tersedia kurang update. Untuk mengupdate daftar paket dari repository yang telah diatur, hubungkan LinuxMint ke internet dan gunakan perintah berikut di terminal:

sudo apt-get update

Octave
| GNU Octave adalah bahasa interpretasi (kebalikan dari kompilasi) level tinggi,utamanya
digunakan untuk komputasi numerik. GNU Octave menyediakan kemampuan untuk menemukan solusi numerik baik untuk masalah linear maupun non-linier, termasuk juga untuk experimen numerik. Selain itu juga menyediakan kemampuan grafis yang memadai untuk visualisasi dan manipulasi data. Octave secara umum digunakan melalui interface terminal yang interaktif, tapi dapat pula digunakan untuk program non-interaktif. Bahasa interpretasi Octave sangat mirip dengan Matlab sehingga skrip dari kedua software tersebut dapat saling bertukar. Octave memiliki kemampuan setara dengan Matlab,sekalipun belum memiliki fitur seperti Simulink dan GUI.
| Octave pertama kali ditulis oleh John W. Eaton ditahun 1988 dalam bahasa C++. Octave
dirilis oleh GNU Project, sebuah proyek international pengembangan software gratis dan opensource yang dipimpin oleh R. Stallman. Kini Octave telah menjadi software yang dapat dijalankan di Linux, Windows, Mac,maupun Android. Octave tersedia dalam 19 bahasa berbeda dengan English US sebagai bahasa default. Octave dirilis sebagai software OpenSource dengan lisensi GNU GPL sehingga bersifat legal dan gratis. Penjelasan lebih lanjut akan dilanjutkan di bab Octave tersendiri.
Lebih lanjut tentang octave dapat dikunjungi di situs wiki: http://wiki.octave.org/Main_Page.

OpenCV
| Pustaka OpenCV (Open Computer Vision) merupakan pustaka pemrograman berbasis
C/C++/Python yang berisi fungsi-fungsi untuk akuisisi dan pengolahan citra. Pustaka OpenCV juga merupakan proyek opensource yang bersifat gratis. Saat ini pustaka OpenCV telah diterapkan di banyak website dan aplikasi mobile untuk deteksi wajah dan penjejak warna. Dalam proyek ini, OpenCV tidak digunakan untuk mengolah gambar namun sebatas untuk mengambil gambar. Bersama dengan Qt (C++), OpenCV ini dibentuk menjadi satu aplikasi untuk berkomunikasi dengan kamera melalui jalur USB dan mengambil gambar. Penjelasan lebih lanjut akan dilanjutkan di bersama dalam bab Octave tersendiri.
| Lebih lanjut tentang opencv dapat dikunjungi di situs resmi: http://opencv.org/.

GCC
| GCC (GNU Compiler Collection) merupakan koleksi kompiler yang di rilis oleh proyek
GNU. Kompiler merupakan program yang mengkonversi kode sumber menjadi program siap jalan. Saat ini GCC mendukung bahasa C, C++, Java, dan banyak bahasa lain. Selain itu GCC juga mendukung banyak arsitektur seperti i386, amd64, armhf, arm-eabi, dan banyak arsitektur lain. Dalam proyek ini digunakan dua jenis varian GCC, yaitu g++ dan arm-gcc-none-eabi. Varian g++ digunakan untuk mengkompilasi program berbasis OpenCV untuk pengambilan gambar. Sedangkan varian arm-gcc-none-eabi digunakan untuk mengkompilasi program yang akan ditanamkan di sirkuit pengendali tangan robot. Penjelasan lebih lanjut tentang arm-gcc-none-eabi akan dilanjutkan di bersama dalam bab RTOS tersendiri.
| Lebih lanjut tentang GCC dapat dikunjungi di situs resmi: https://gcc.gnu.org/.

Qt Creator
| Qt Creator merupakan salah satu IDE (Integrated Development Environment) yang digunakan

1.3 License | 7

secara luas terutama untuk pengembangan software berbasis Qt. Qt sendiri adalah kerangka kerja (framework) pengembangan software berbasis opensource yang memiliki fitur terlengkap dibandingkan framework lain sperti GTK,FLTK,dst. Qt Creator merupakan IDE untuk proses penulisan dan pengecekan program, namun membutuhkan kompiler seperti GCC, g++, maupun arm-gcc untuk dapat mengkompilasi. Dalam proyek ini Qt Creator digunakan dalam penulisan program untuk pengambilan gambar dan program yang ditanamkan di dalam chip.
Lebih lanjut tentang Qt Creator dapat dikunjungi di situs resmi: https://qtcreator/. EAGLE

EAGLE (Easy Applicable Graphical Layout Editor) adalah software untuk mendesain papan circuit. Desain yang dibuat di EAGLE berupa skema dan layout. Versi yang dapat di instal secara gratis adalah versi Light dengan batasan:

-Luas maximal papan adalah 100mmx80mm.
-Hanya dapat menggunakan 2 Lapisan, yaitu Top dan Bottom.
-Fitur AutoRoute tidak tersedia.

Namun diluar batasan tadi, fitur EAGLE dapat digunakan secara penuh, terutama ketersedian pustaka komponen yang sangat lengkap. Penjelasan lebih lanjut akan dilanjutkan di bab Elektronik tersendiri.
Lebih lanjut tentang EAGLE dapat dikunjungi di situs resmi:
http://www.cadsoftusa.com/.

SolidWork
SolidWork merupakan salah satu software CAD (Computer Aided Design) yang telah populer di perusahan-perusahan besar. Software ini digunakan untuk mendesain sistem fisik dan mekanis dengan dukungan pustaka yang sangat lengkap. Dalam proyek ini, software ini digunakan untuk mendesain sistem mekanis tangan robot. Versi yang digunakan adalah 2013 dan SolidWork tergolong software yang tidak Backward Compatible. Software ini merupakan satu-satunya software berbayar yang digunakan dalam proyek ini. Pembahasan lebih lanjut hanya akan difokuskan pada desain mekanisnya. Namun tentang software tidak dibahas lebih jauh mengingat sifatnya yang tidak gratis dan dijalankan di platform Windows 7.
Lebih lanjut tentang octave dapat dikunjungi di situs resmi:
http://www.solidworks.com/.

### 1.3 License

Proyek ini memiliki lisensi bervariasi mengingat seluruh resources yang digunakan merupakan turunan dari banyak proyek opensource lain. Namun mengingat kemiripan dan kompatibilitas antar jenis lisensi (terutama jenis MIT, Apache, GPL dan LPGL) maka pengembang menentukan lisensi dari seluruh proyek ini adalah GPL v2. Lebih lanjut tentang lisensi dapat dilihat di alamat: http://opensource.org/licenses/

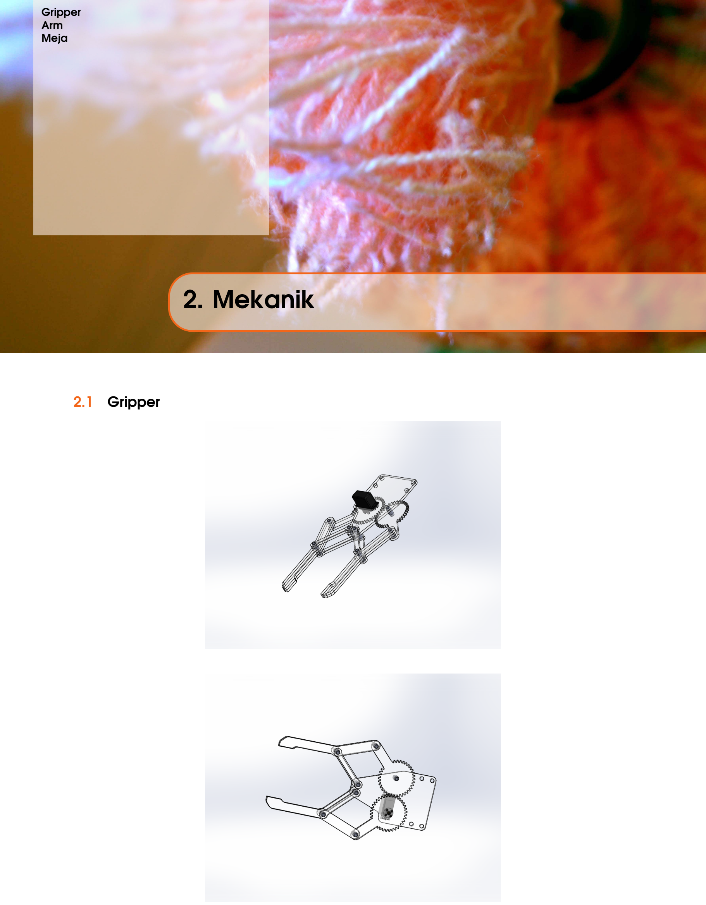
[picture p42: page 9]

Gripper
Arm
Meja

# 2. Mekanik

### 2.1 Gripper

10 | Chapter 2. Mekanik

### 2.2 Arm

### 2.3 Meja

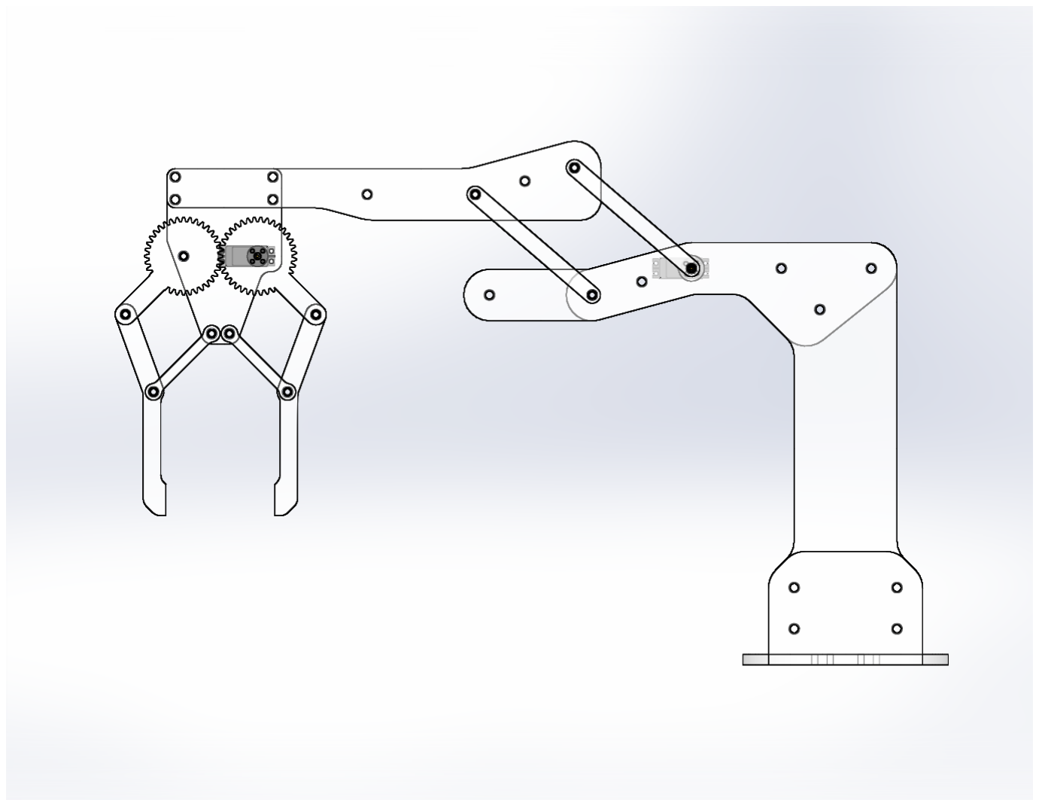
[picture p43: figure]
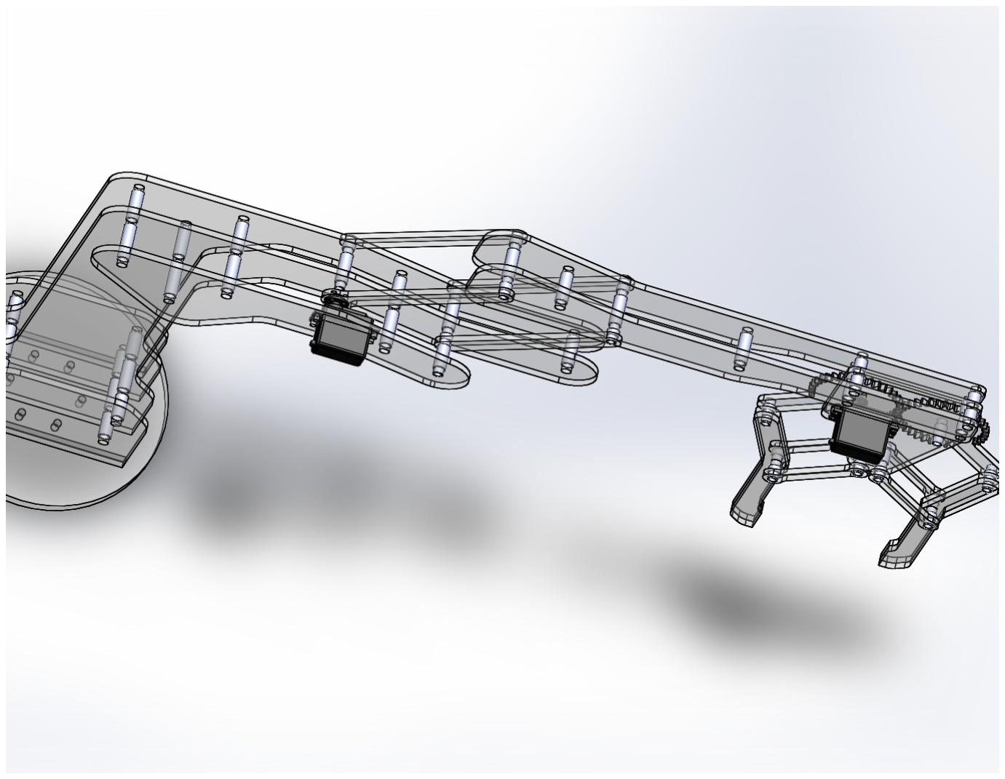
[picture p44: figure]
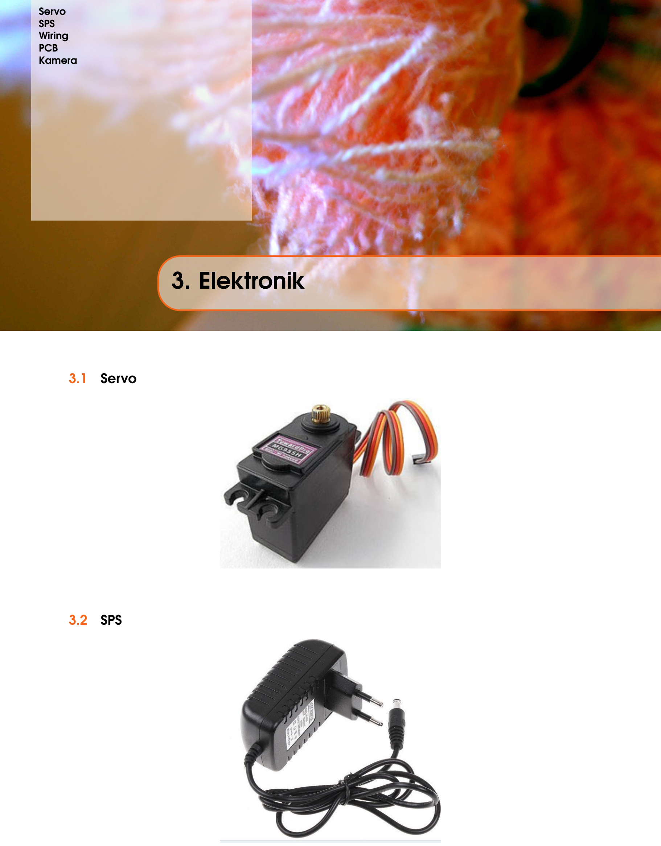
[picture p45: page 11]

Servo
SPS
Wiring
PCB
Kamera

# 3. Elektronik

### 3.1 Servo

### 3.2 SPS

12 | Chapter 3. Elektronik

### 3.3 Wiring

| Secara global, sistem tangan robot yang digunakan memiliki bagian utama yaitu:
-Servo sebanyak 2 unit.
-Controller sebanyak 1 unit.
-SPS sebanyak 1 unit.
-Komputer sebanyak 1 unit.
| Untuk koneksi antara Controller dengan bagian-bagian lainnya dijelaskan seperti berikut:
-Wiring antara Controller dan masing-masing servo memiliki 3 jalur yaitu jalur positif 6 volt, ground, dan sinyal.
-Wiring antara Controller dan SPS memiliki 2 jalur yaitu jalur positif 6 volt dan ground.
-Wiring antara Controller dan Komputer memiliki 4 jalur yaitu jalur positif 5 volt, ground, USB data postif, dan USB data negatif.
| Perlu diketahui bahwa ground SPS dan Servo terhubung, sedangkan dengan Komputer
terpisah. Perlu diketahui pula bahwa arus di jalur Komputer hanya 500mA, sedangkan di jalur
SPS dan servo mencapai 2 Ampere. Untuk memudahkan maka berikut skema dari penjelasan
diatas:

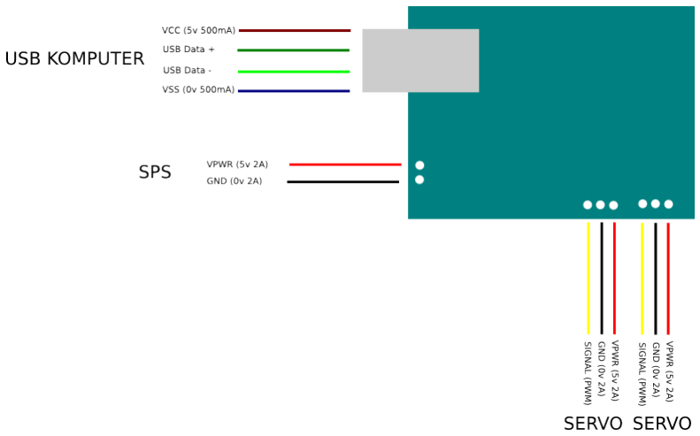
[picture p46: figure]

Sedangkan untuk Kamera dan Komputer terhubung secara langsung melalui jalur USB.

### 3.4 PCB

PCB atau printed circuit board adalah papan yang telah dicetak jalur tembaga sebagai tempat komponen elektronik disolder dan jalur elektrisnya. Untuk dapat membuat PCB Controller yang digunakan dalam proyek ini maka diperlukan berikut ini:
-Software CAD (Computer Aided Design).
-PCB Manufaktur.

Untuk PCB Manufaktur disini dipercayakan kepada CV. Maxtron Persada Indonesia. Perusahan ini merupakan perusahaan nasional yang bergerak di bidang manufaktur PCB kualitas tinggi dan penyedia mesin CNC untuk produksi PCB. Alasan mengapa dipilih perusahaan ini selain karena hasil manufakturnya yang berkualitas juga letaknya yang masih area Surabaya-Sidoarjo. Untuk informasi lebih lanjut dapat kunjungi situs resmi:http://www.maxtronpersada.com/

Selanjutnya adalah Software Computer Aided Design. Software CAD digunakan untuk mendesain baik skematik maupun layout sebelum di kirim ke perusahaan manufaktur PCB. Software CAD untuk PCB yang digunakan disini adalah EAGLE. Untuk menginstal EAGLE di LinuxMint dari internet dengan mengetikkan di terminal:

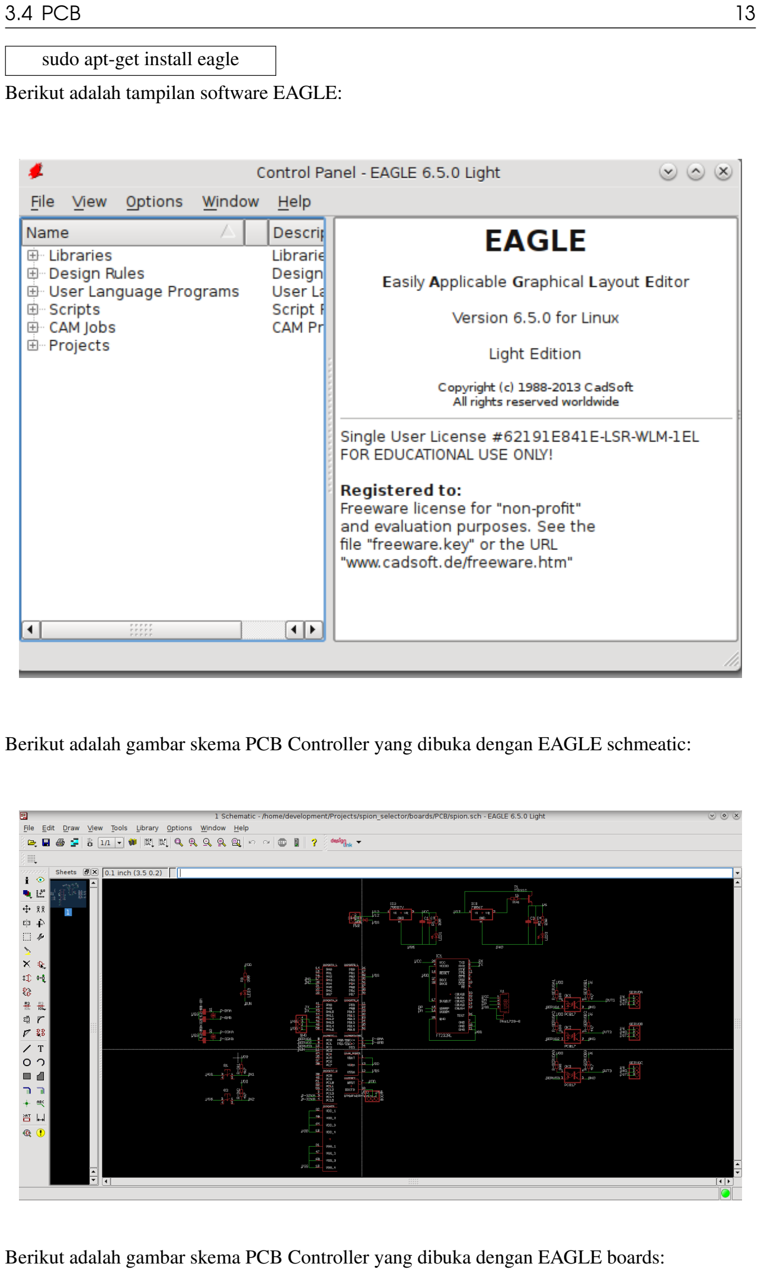
[picture p47: page 13]

3.4 PCB | 13

sudo apt-get install eagle

Berikut adalah tampilan software EAGLE:

Berikut adalah gambar skema PCB Controller yang dibuka dengan EAGLE schmeatic:

Berikut adalah gambar skema PCB Controller yang dibuka dengan EAGLE boards:

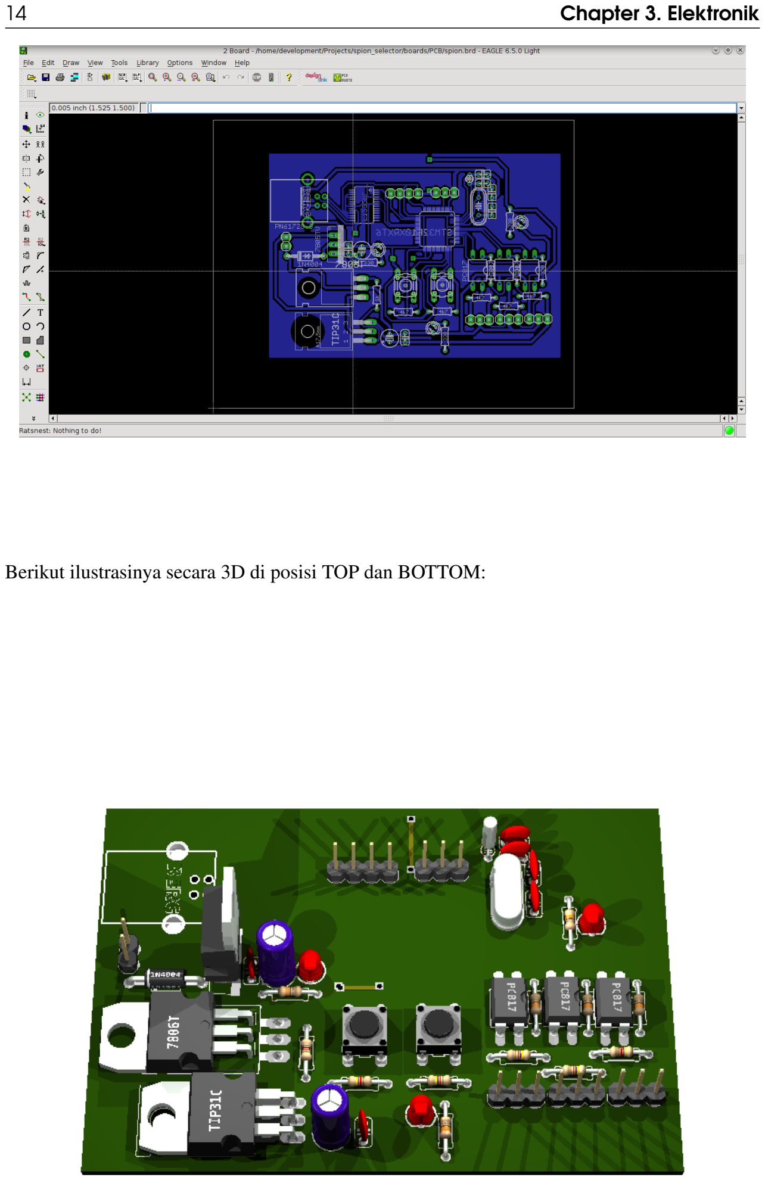
[picture p48: page 14]

14 | Chapter 3. Elektronik

Berikut ilustrasinya secara 3D di posisi TOP dan BOTTOM:

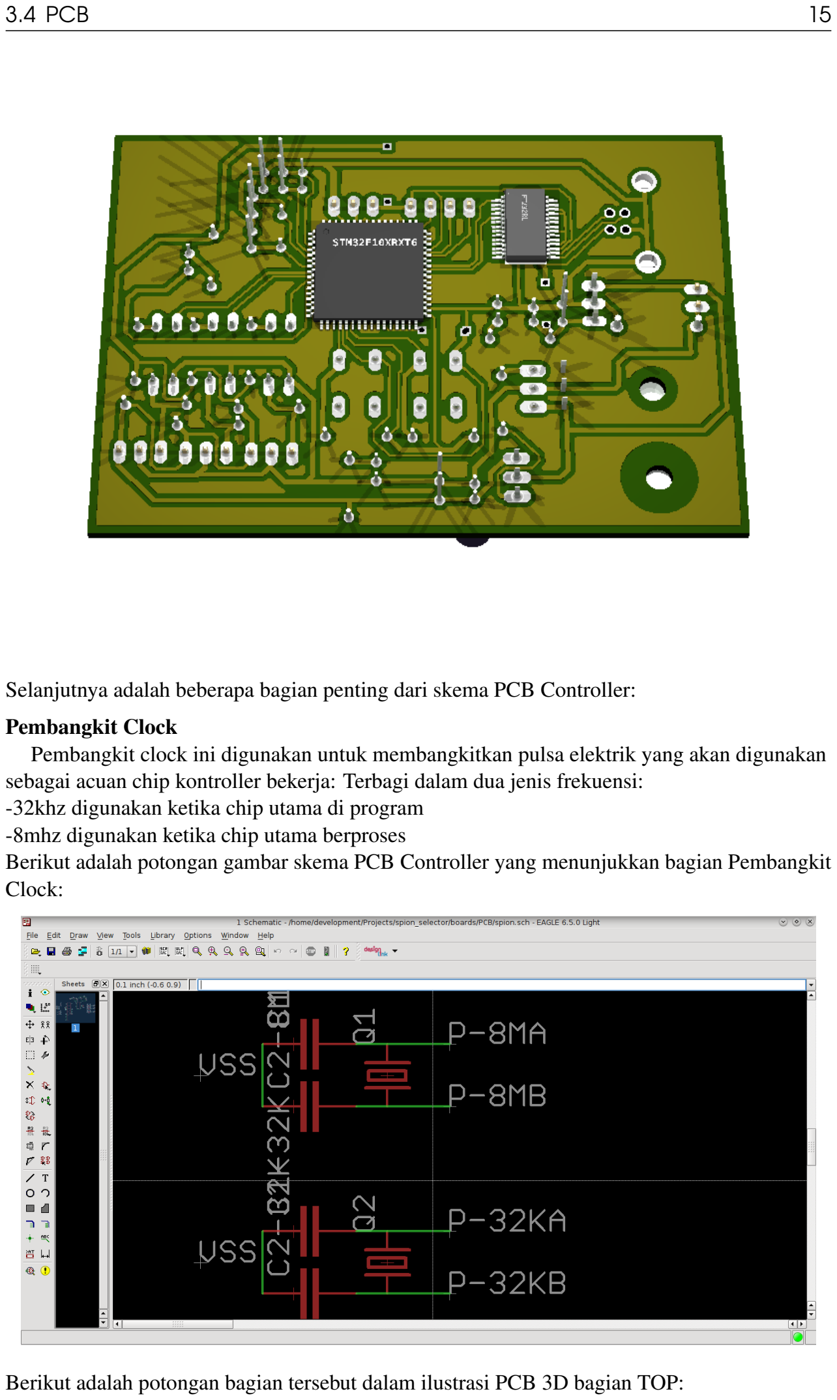
[picture p49: page 15]

3.4 PCB | 15

Selanjutnya adalah beberapa bagian penting dari skema PCB Controller:

Pembangkit Clock
Pembangkit clock ini digunakan untuk membangkitkan pulsa elektrik yang akan digunakan sebagai acuan chip kontroller bekerja: Terbagi dalam dua jenis frekuensi:
-32khz digunakan ketika chip utama di program
-8mhz digunakan ketika chip utama berproses
Berikut adalah potongan gambar skema PCB Controller yang menunjukkan bagian Pembangkit Clock:

Berikut adalah potongan bagian tersebut dalam ilustrasi PCB 3D bagian TOP:

16 | Chapter 3. Elektronik

Servo Signal Brigde

Dalam mengoperasikan aktuator servo, diperlukan komponen sebagai jembatan sinyal antara chip utama dan servo. Beberapa alasan dibutuhkan jembatan sinyal adalah:
-Level tegangan chip utama adalah 3,3v sedangkan servo adalah 6 volt.
-Chip utama bekerja pada arus dibawah 500mA sedangkan servo diatas 1A.
-Servo menghasilkan induksi balik sehingga chip utama dan servo perlu memiliki acuan tegangan 0 terpisah. Untuk memenuhi kebutuhan inilah digunakan IC PC817 sebagai jembatan antara chip utama
dan servo. Komponen PC817 terdiri dari LED (untuk sisi chip) dan PhotoTransistor (untuk sisi
servo). Mekanisme kerja PC817 adalah switch PhotoTransistor di kendalikan oleh sinyal cahaya
dari LED. Oleh karena sinyal antara sisi LED dan PhotoTransistor bukan sinyal elektris (melainkan cahaya), maka LED dan PhotoTransistor dapat bekerja di level tegangan, arus dan acuan tegangan yang terpisah. Berikut adalah potongan gambar skema PCB Controller yang menunjukkan bagian Servo Signal Brigde:

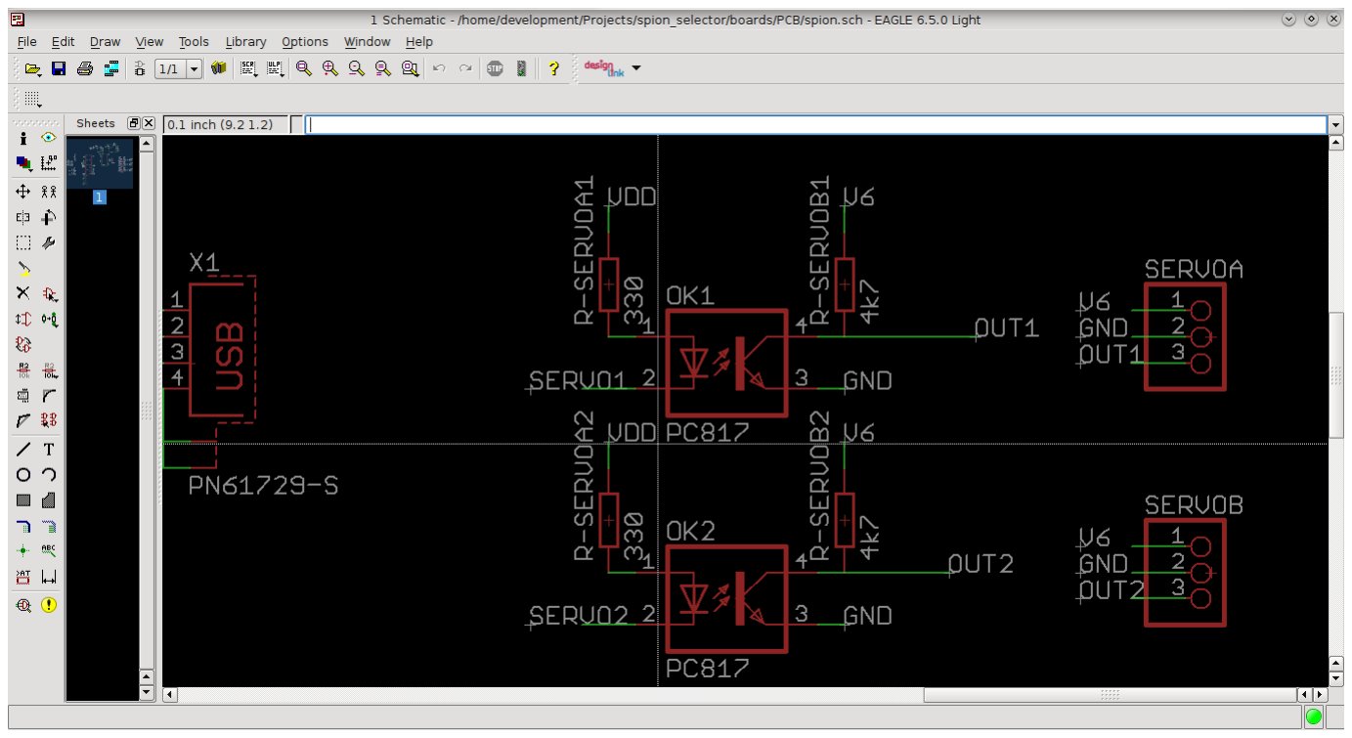
[picture p50: figure]

Berikut adalah potongan bagian tersebut dalam ilustrasi PCB 3D bagian TOP:

3.4 PCB | 17

Power Regulator

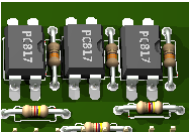
[picture p51: figure]

Power Regulator merupakan bagian opsional yang berfungsi untuk mengatur tegangan tenaga yang masuk ke circuit agar sesuai dengan kebutuhan. Disini digunakan dua jenis IC regulator: -7806 untuk tenaga ke servo sebesar 6 volt.
-7805 untuk rangkaian ke chip sebesar 5 volt.
Pada setiap segmen telah ditambahkan LED untuk indikator dan Electrolite Capacitor untuk menstabilkan tegangan. Arus yang dikeluar di setiap IC adalah 1A. Khusus untuk servo, digunakan pula Transistor TIP 31C untuk menambahkan arus ke servo dengan sumber arus asli. Namun dalam proyek ini, segmen ini tidak digunakan karena digantikan oleh:
-Untuk servo tenaga diperoleh dari SPS sebesar 5 volt 2 Ampere.
-Untuk chip tenaga diperoleh dari USB Komputer sebesar 5 volt 500mA.
Berikut adalah potongan gambar skema PCB Controller yang menunjukkan bagian Power Regulator:

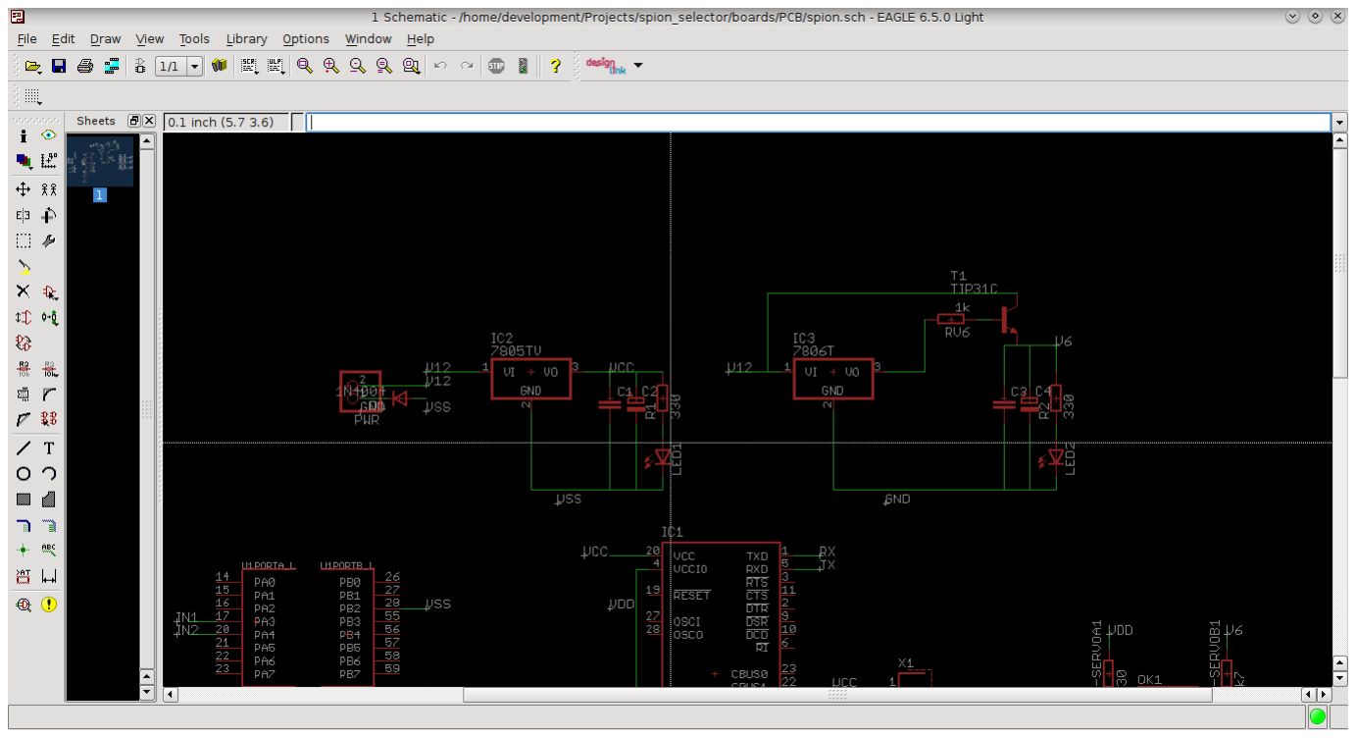
[picture p52: figure]

Berikut adalah potongan bagian tersebut dalam ilustrasi PCB 3D bagian TOP:

18 | Chapter 3. Elektronik

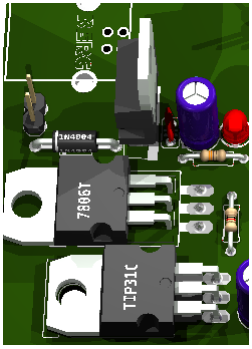
[picture p53: figure]

Untuk komponen chip digital (STM32 dan FTDI akan dijelaskan pada bab selanjutnya.)

### 3.5 Kamera

Kamera yang digunakan adalah Logitech C190.

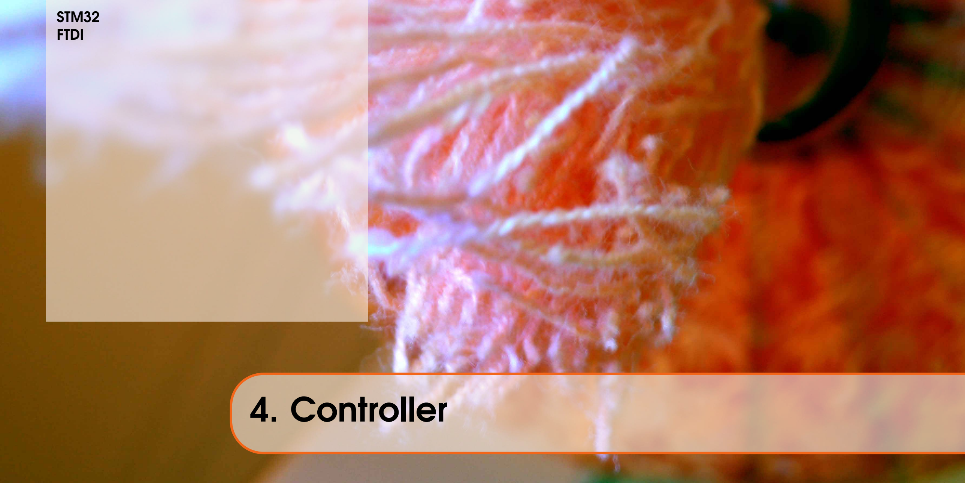
[picture p54: figure]
STM32 FTDI; 4. Controller

### 4.1 STM32

STM32 adalah microcontroller 32bit yang kini telah digunakan di hampir semua instrumen. STM32 adalah salah satu produk dari ST Microelectronic Inc, sebuah perusahaan semikonduktor asal Italia. STM32 memiliki fitur lengkap dengan CPU 32bit plus FPU dan register-register baik 32bit, 16bit, 12bit, maupun 8bit. Berikut beberapa data STM32 secara umum:
Untuk jenis STM32 yang digunakan dalam proyek ini adalah STM32F103RBT6. Berikut adalah gambar mapping pin yang digunakan:

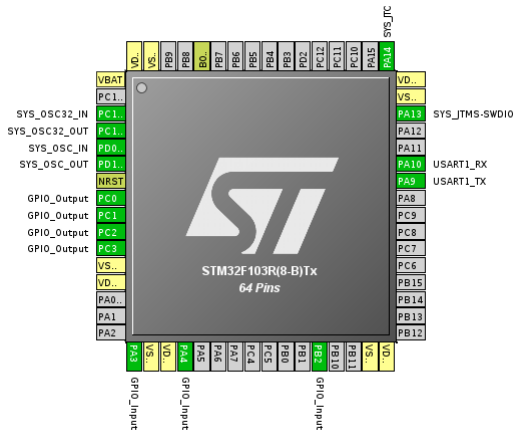
[picture p55: figure]

Berikut adalah gambar skematik STM32 di circuit Controller:

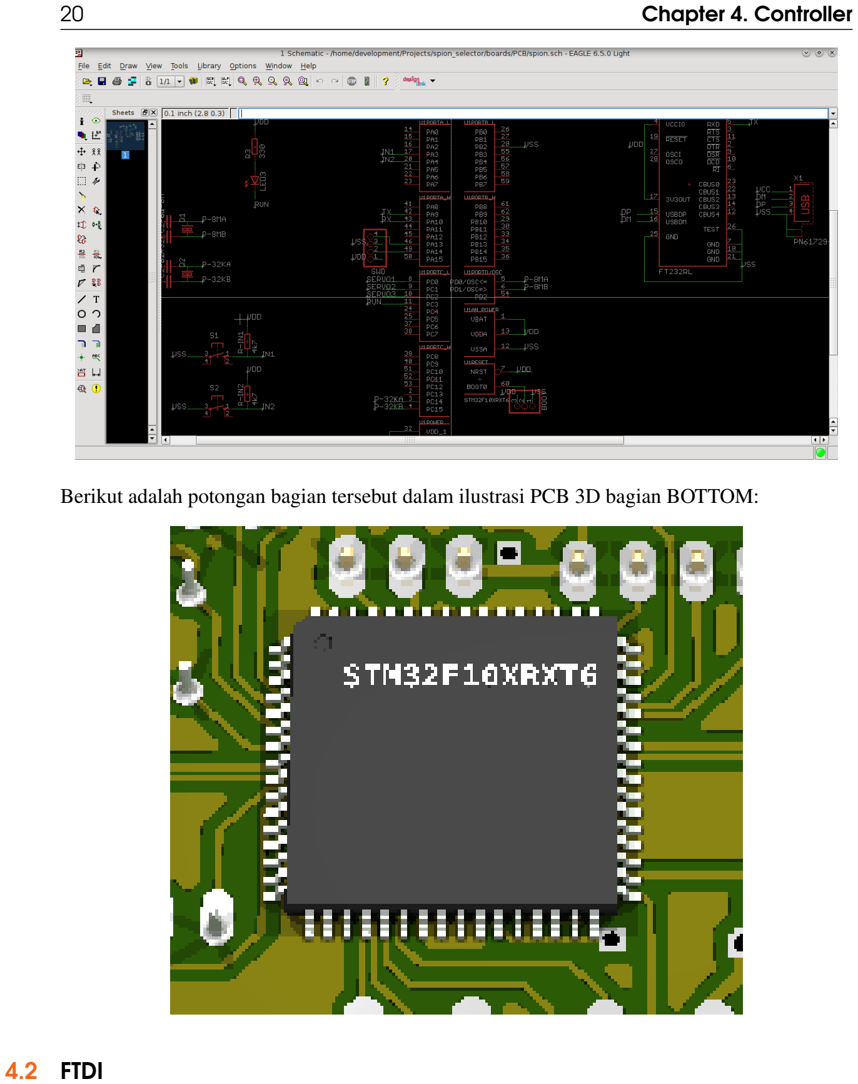
[picture p56: page 20]

20 | Chapter 4. Controller

Berikut adalah potongan bagian tersebut dalam ilustrasi PCB 3D bagian BOTTOM:

### 4.2 FTDI

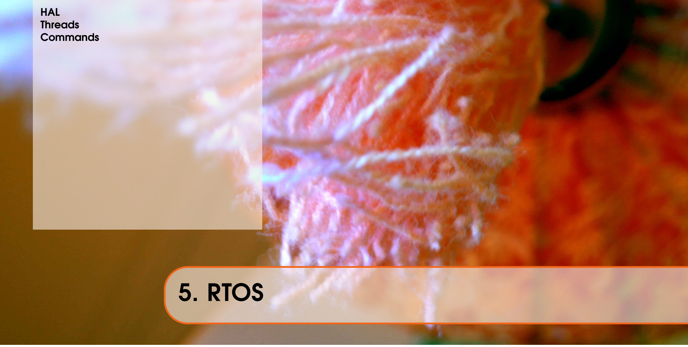
[picture p57: figure]
HAL Threads Commands; 5. RTOS

### 5.1 HAL

Pada bagian ini akan dijelaskan tentang HAL (Hardware Abstraction Layer) yang digunakan dalam proyek ini. Karena penjelasan ini adalah bagian dari RTOS (Real Time Operating System) yang akan ditanamkan di chip controller, maka diperlukan software Qt Creator untuk membuka file-file kode sumber yang ada di folder project. Untuk menginstal Qt Creator di LinuxMint dari internet dengan mengetikkan di terminal:

sudo apt-get install qtcreator qtdeclarative5-qtquick2-plugin

RTOS adalah kependekan dari Real Tipe Operating System. RTOS disini yang digunakan ChibiOS yang merupakan sekumpulan template kode sumber dalam bahasa C dan Makefile untuk membuat firmware multitask pada sistem ARM. Lebih lanjut tentang ChibiOS dapat dilihat di alamat: http://chibios Sementara HAL itu sendiri adalah kependekan dari Hardware Abstraction Layer. HAL merupakan fitur pada RTOS yang memungkinkan pengembang tidak harus menggunakan register-register low level dalam membuat firmwarenya. Register low level sifatnya sangat bergantung kepada tipe dan merek chip sekalipun sama-sama memiliki arsitektur ARM. Untuk itulah dibuat fitur HAL sehingga pada level tertinggi dari hirarki fungsi, pengembang dapat menggunakan fungsi-fungsi yang sama untuk beragam tipe dan mereka chip selama telah RTOS memiliki HAL-nya.
Selanjutnya adalah membuka file bertipe *.creator. Maka akan muncul tampilan seperti berikut:

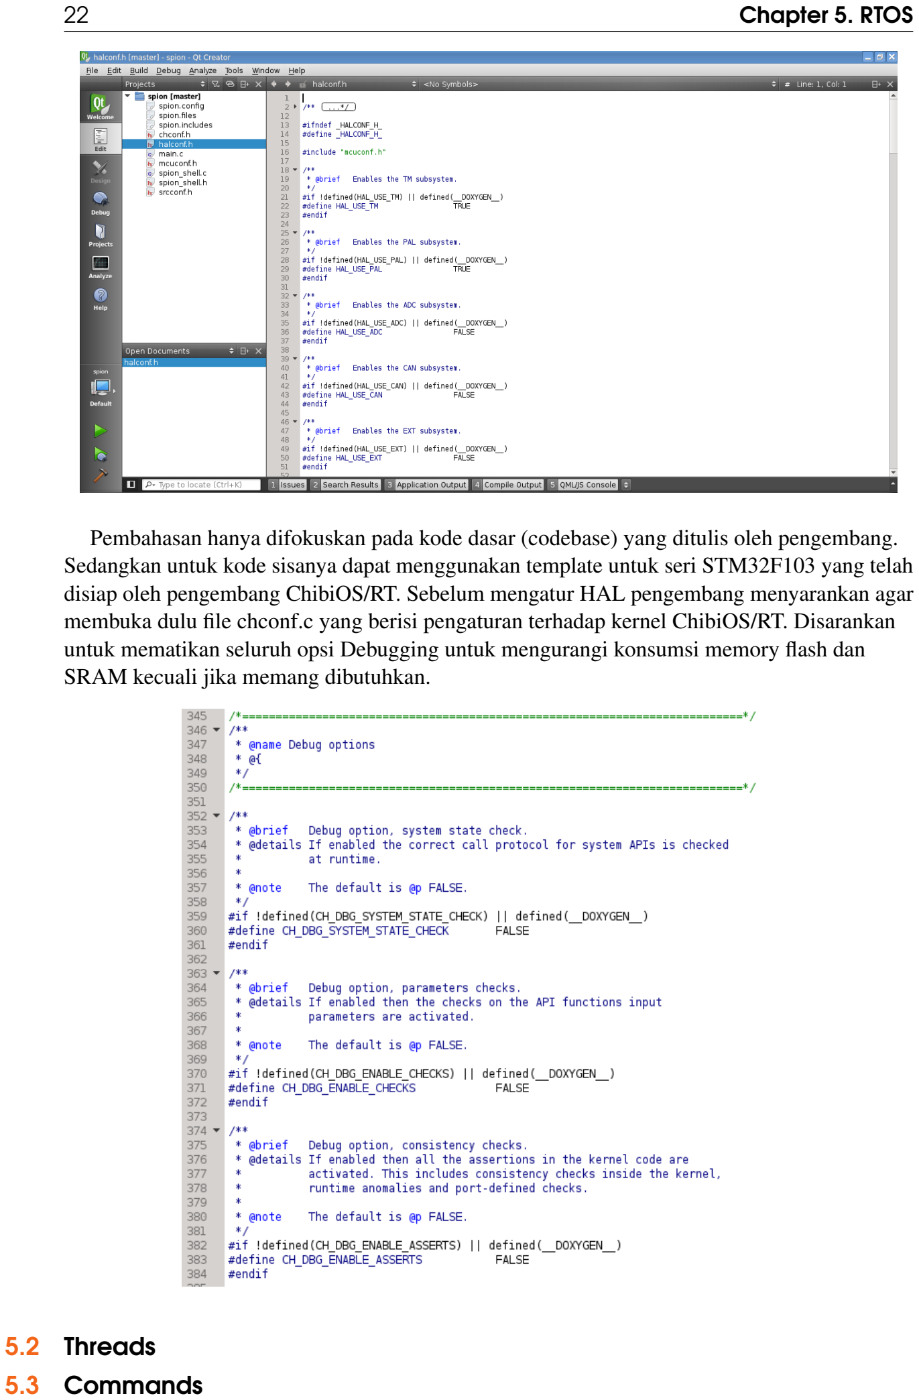
[picture p58: page 22]

22 | Chapter 5. RTOS

Pembahasan hanya difokuskan pada kode dasar (codebase) yang ditulis oleh pengembang. Sedangkan untuk kode sisanya dapat menggunakan template untuk seri STM32F103 yang telah disiap oleh pengembang ChibiOS/RT. Sebelum mengatur HAL pengembang menyarankan agar membuka dulu file chconf.c yang berisi pengaturan terhadap kernel ChibiOS/RT. Disarankan untuk mematikan seluruh opsi Debugging untuk mengurangi konsumsi memory flash dan SRAM kecuali jika memang dibutuhkan.

### 5.2 Threads

### 5.3 Commands

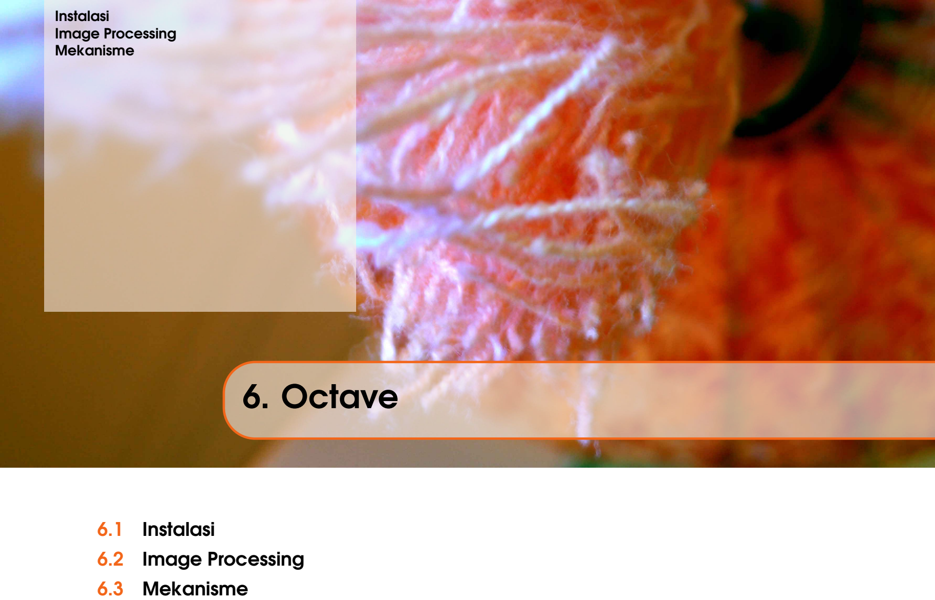
[picture p59: page 23]

Instalasi
Image Processing
Mekanisme

# 6. Octave

### 6.1 Instalasi

### 6.2 Image Processing

### 6.3 Mekanisme
