mekatronik-achmadi/spion_selector/docs/screenshot/ftdi/ft232rl.png

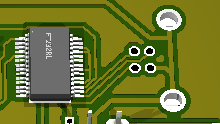
docs/screenshot/ftdi/ft232rl.png
