mekatronik-achmadi/spion_selector/docs/screenshot/ftdi/ft232rl_sch.png

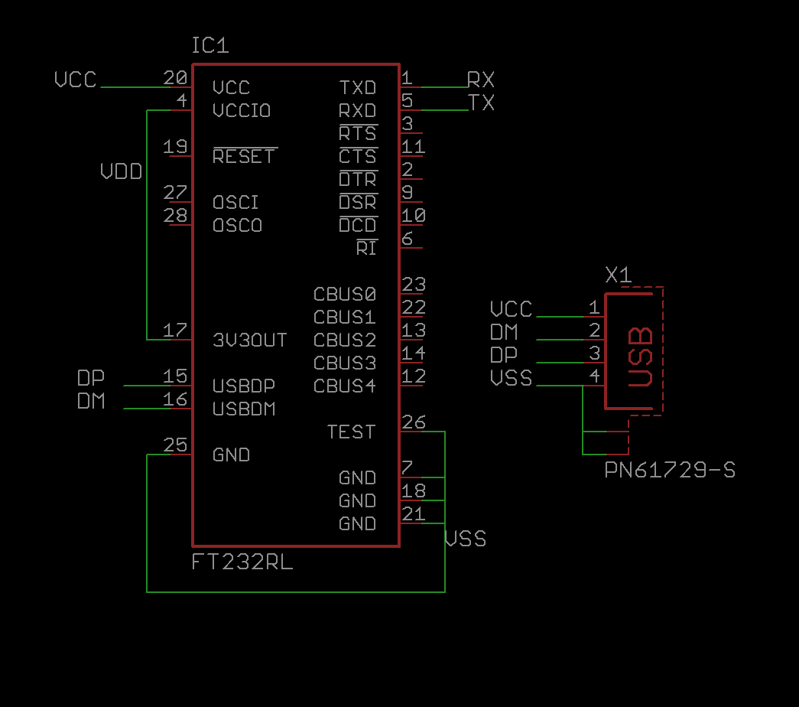
docs/screenshot/ftdi/ft232rl_sch.png
