mekatronik-achmadi/spion_selector/docs/screenshot/komponen/stm32_spec.png

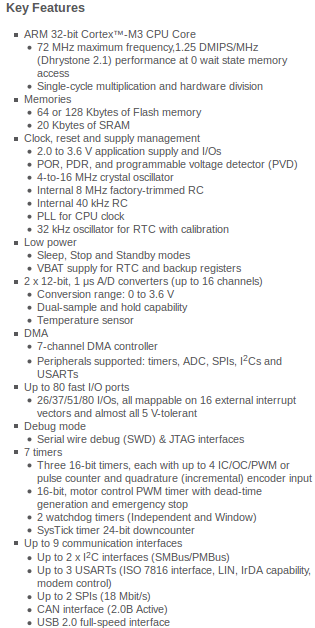
docs/screenshot/komponen/stm32_spec.png
