mekatronik-achmadi/spion_selector/docs/screenshot/set-up/selected_cam.png

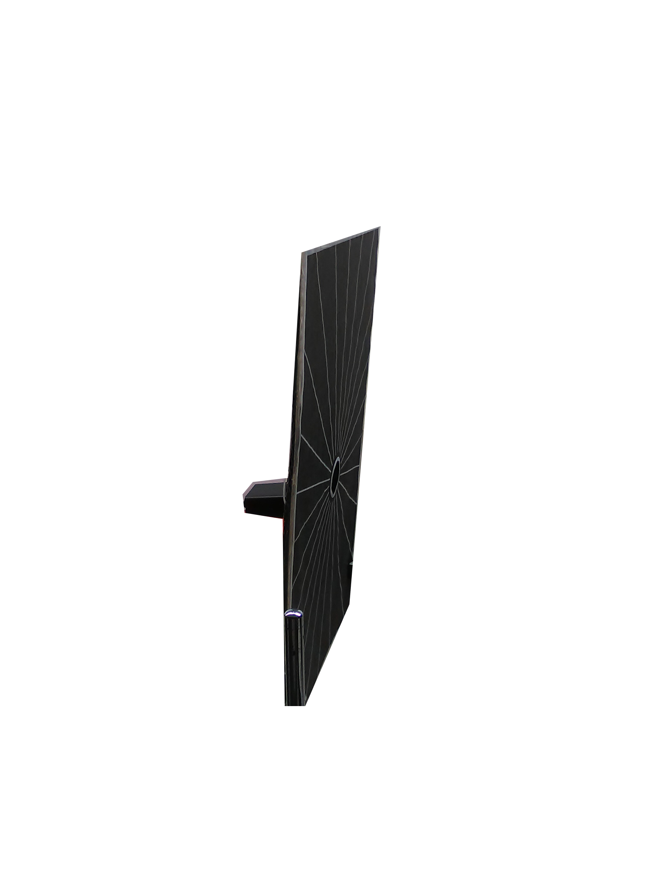
docs/screenshot/set-up/selected_cam.png
