mekatronik-achmadi/spion_selector/docs/screenshot/set-up/set-up2.png

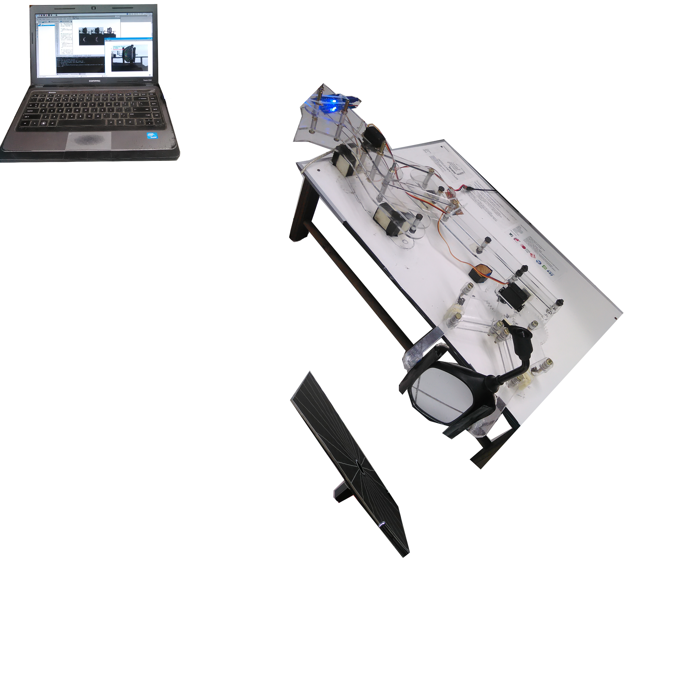
docs/screenshot/set-up/set-up2.png
