mekatronik-achmadi/spion_selector/octave_works/example.jpg

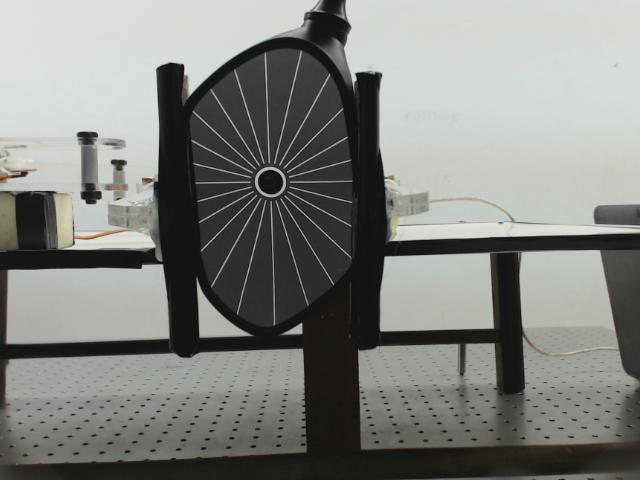
octave_works/example.jpg
