mekatronik-achmadi/spion_selector/octave_works/example.png

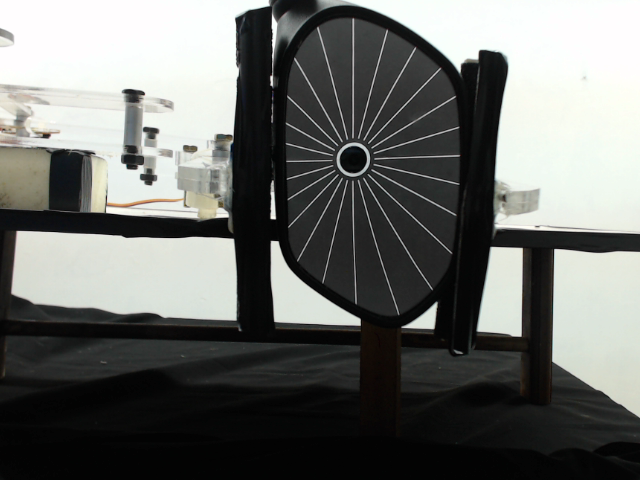
octave_works/example.png
