mekatronik-achmadi/spion_selector/pattern/A3_Red_0_samepaper.png

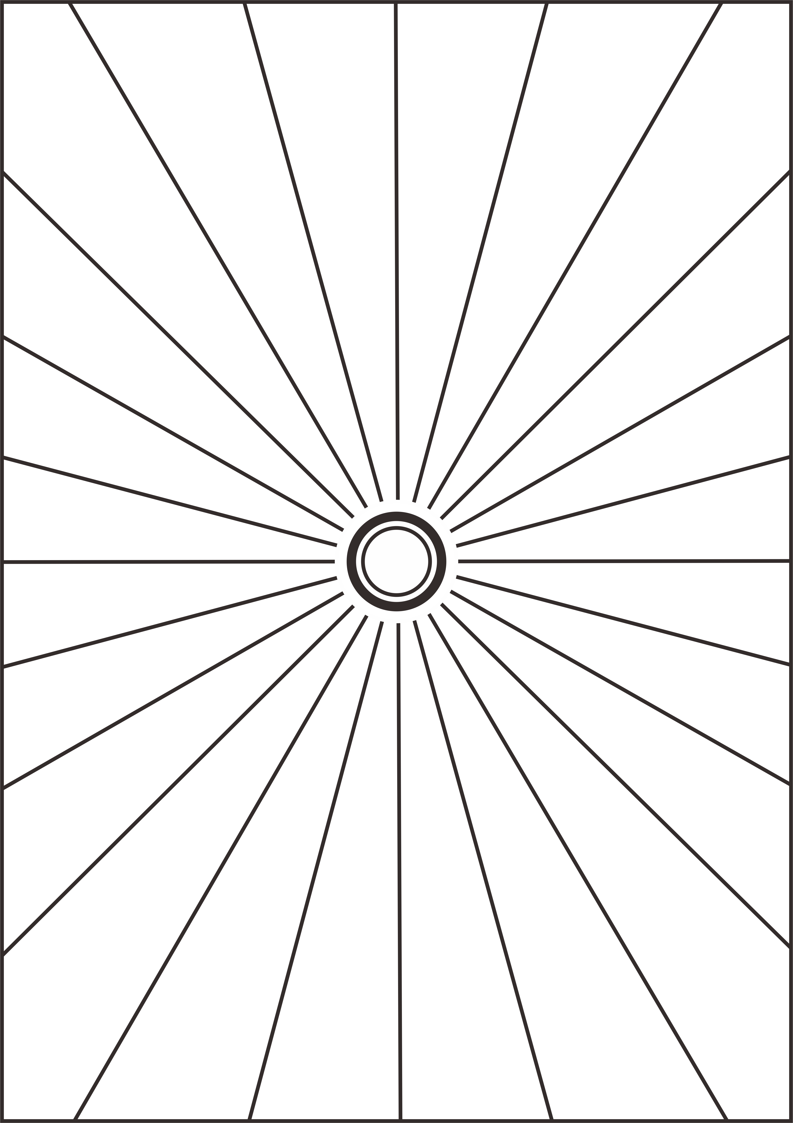
pattern/A3_Red_0_samepaper.png
