mekatronik-achmadi/spion_selector/pattern/pattern_alpha_layer.png

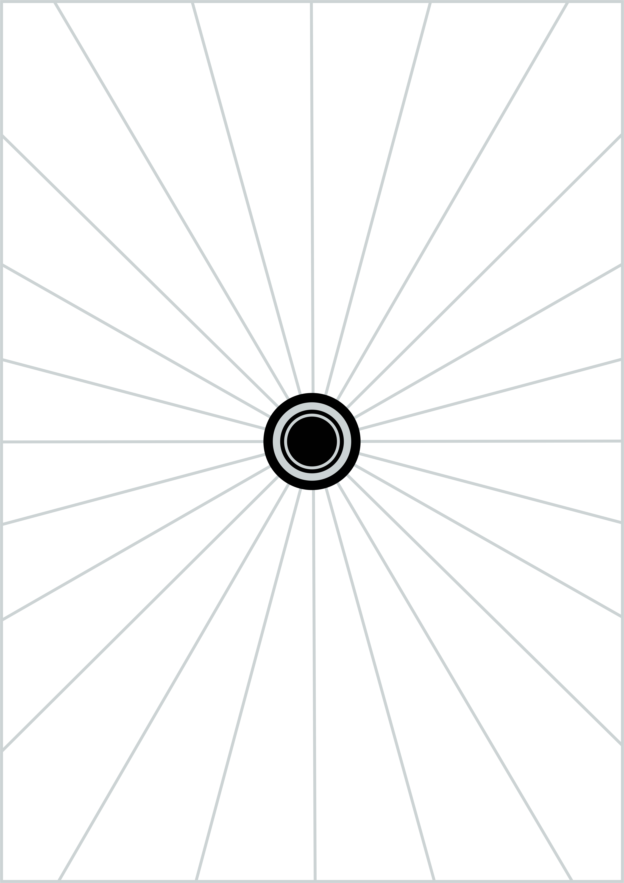
pattern/pattern_alpha_layer.png
