mekatronik-achmadi/spion_selector/pattern/pattern_black.png

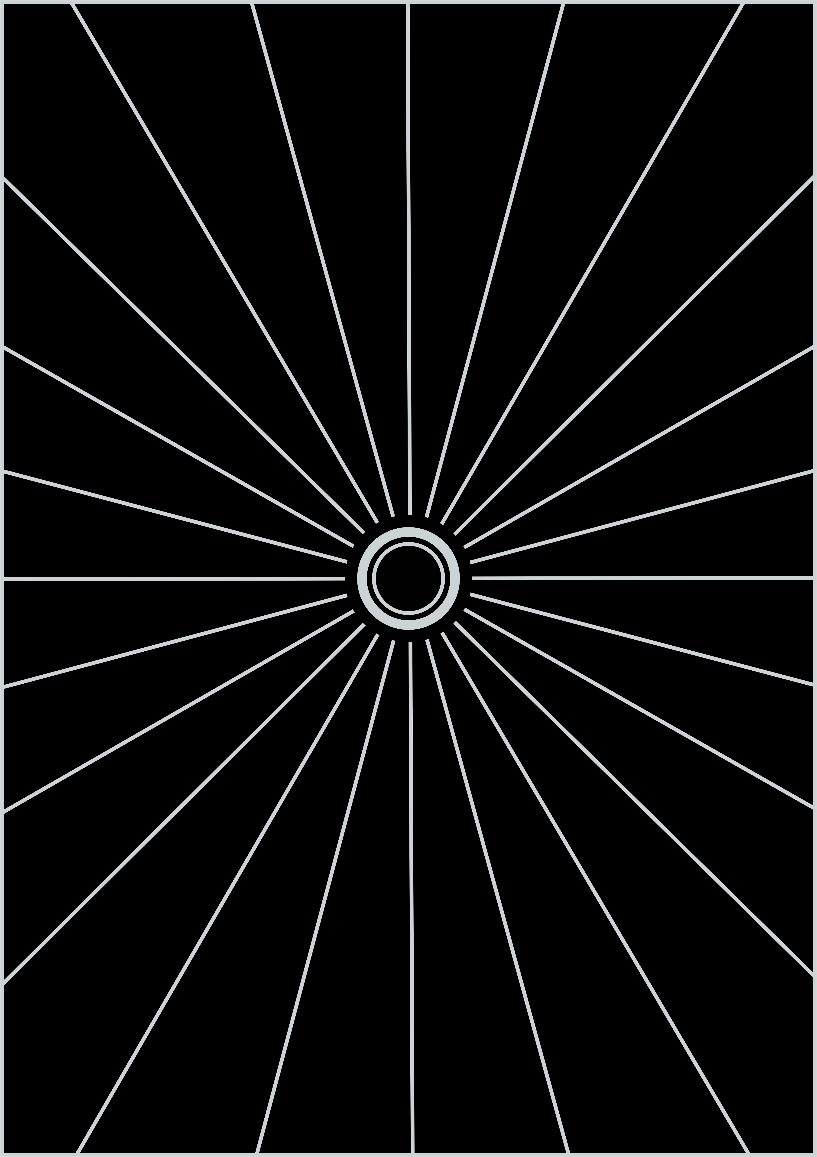
pattern/pattern_black.png
