mekatronik-achmadi/spion_selector/poster/edited/background.png

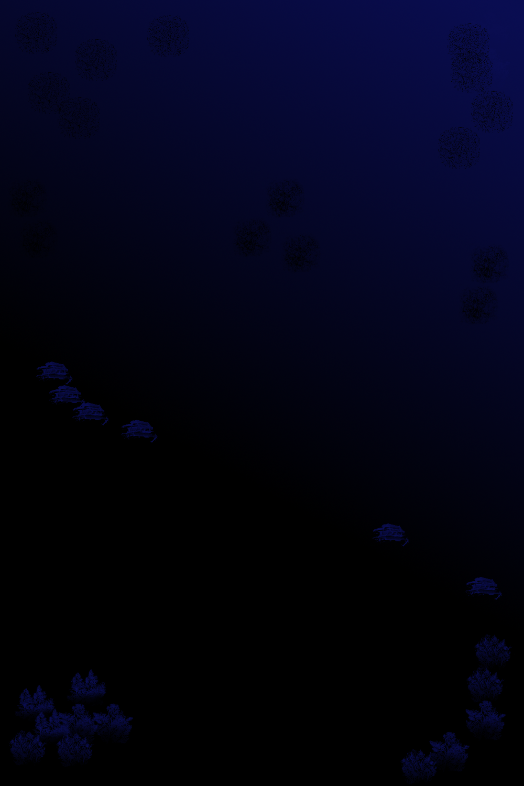
poster/edited/background.png
