mekatronik-achmadi/spion_selector/poster/edited/IMG_20141007_180756.jpg

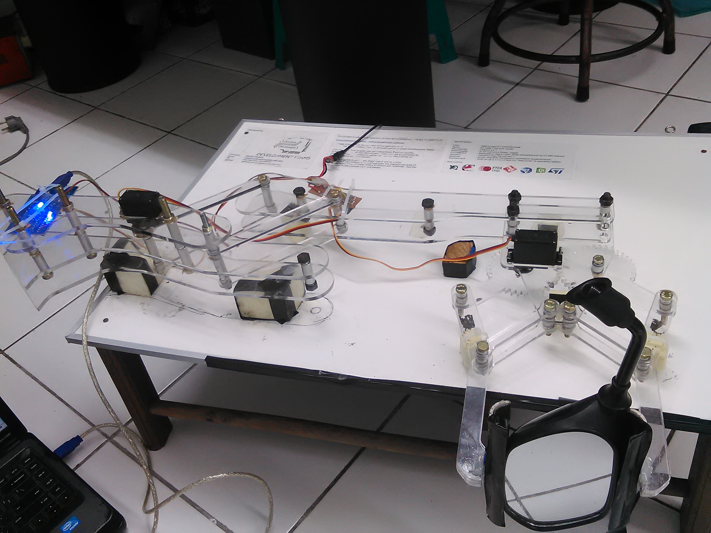
poster/edited/IMG_20141007_180756.jpg
