mekatronik-achmadi/spion_selector/poster/edited/IMG_20141008_075046.jpg

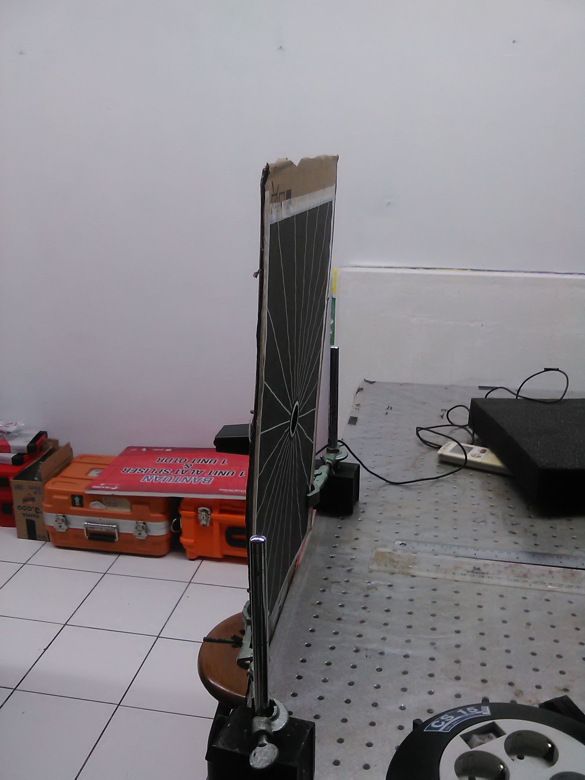
poster/edited/IMG_20141008_075046.jpg
