mekatronik-achmadi/spion_selector/poster/edited/IMG_20141008_075506.jpg

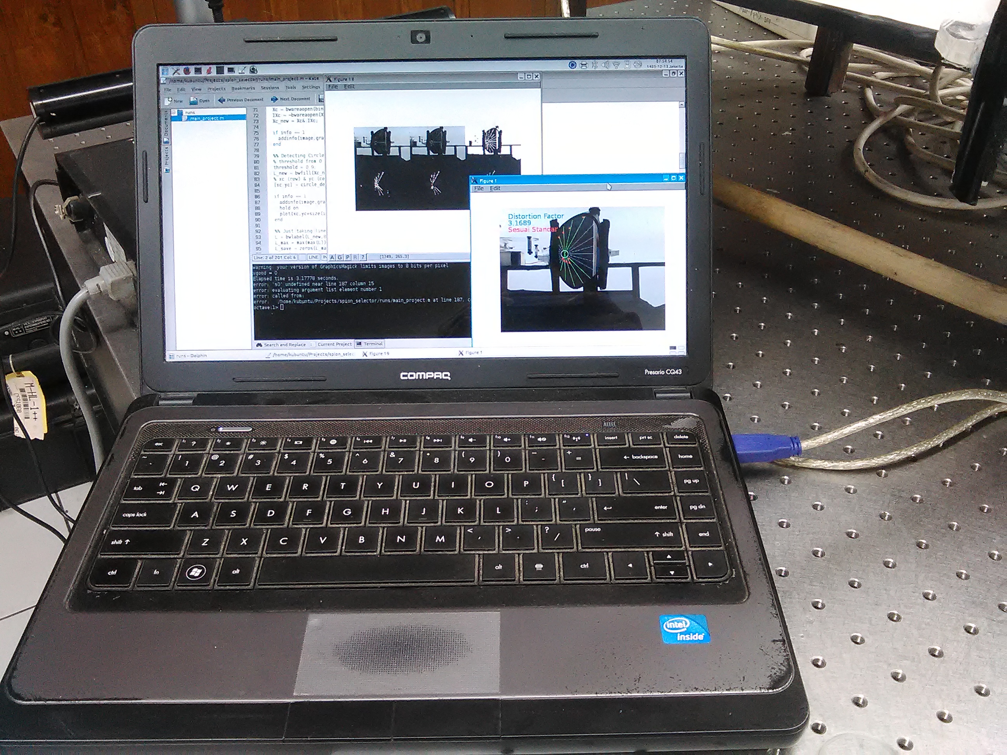
poster/edited/IMG_20141008_075506.jpg
