mekatronik-achmadi/spion_selector/poster/src/poster_gue.png

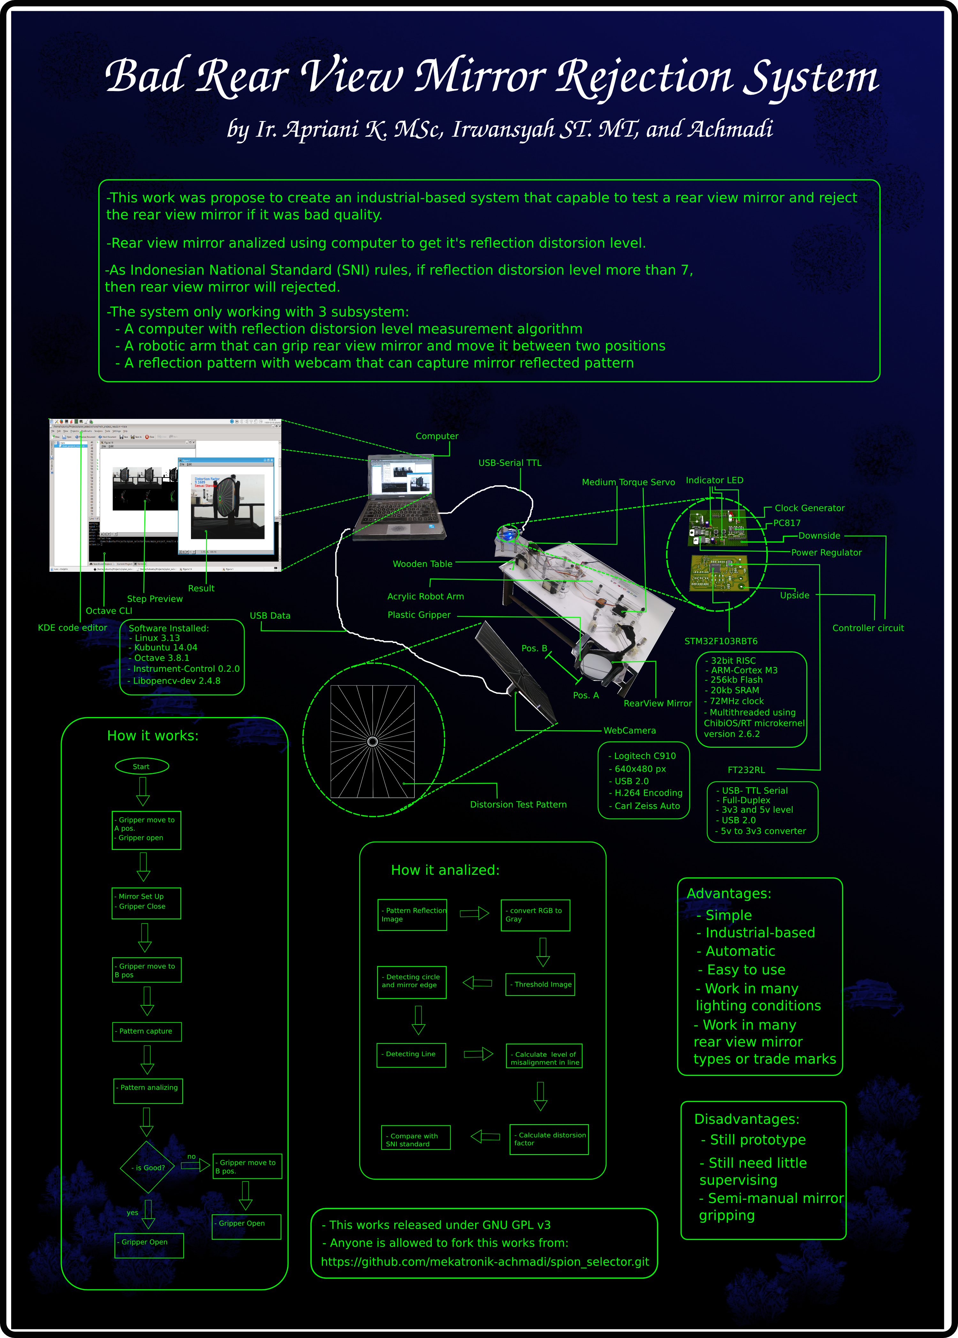
poster/src/poster_gue.png
