mekatronik-achmadi/spion_selector/mechanic/Robot Arm/Gripper Arm 1 - X2.DXF

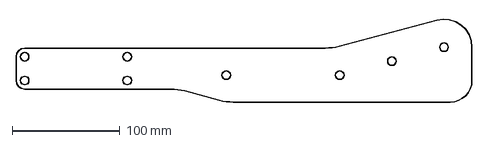
[picture p76: CAD file, 2014-06-24]
mechanic/Robot Arm/Gripper Arm 1 - X2.DXF
422.5 x 78.0 mm
