mekatronik-achmadi/spion_selector/mechanic/Robot Arm/Gripper Arm Linkage 2 - X1.DXF

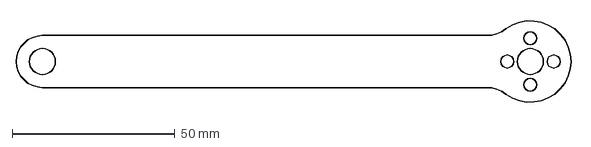
[picture p77: CAD file, 2014-06-24]
mechanic/Robot Arm/Gripper Arm Linkage 2 - X1.DXF
171.6 x 27.7 mm
