mekatronik-achmadi/spion_selector/mechanic/Robot Arm/Gripper Base - X1.DXF

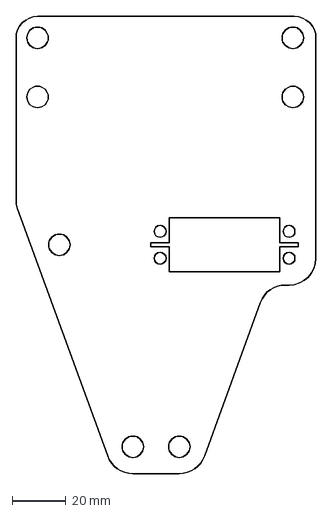
[picture p78: CAD file, 2014-06-24]
mechanic/Robot Arm/Gripper Base - X1.DXF
111.6 x 170.2 mm
