mekatronik-achmadi/spion_selector/mechanic/Robot Arm/Gripper Gear A - X1.DXF

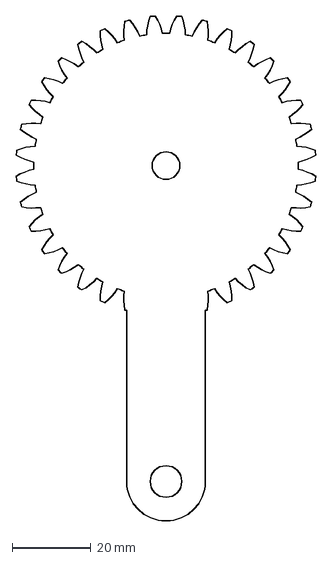
[picture p79: CAD file, 2014-06-24]
mechanic/Robot Arm/Gripper Gear A - X1.DXF
75.8 x 127.9 mm
