mekatronik-achmadi/spion_selector/mechanic/Robot Arm/Gripper Arm Linkage - X3.DXF

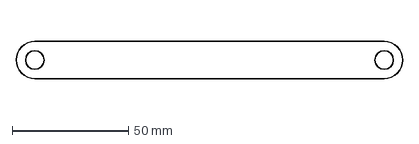
[picture p80: CAD file, 2014-06-24]
mechanic/Robot Arm/Gripper Arm Linkage - X3.DXF
166.0 x 16.0 mm
