mekatronik-achmadi/spion_selector/mechanic/Robot Arm/Gripper Base 2 - X2.DXF

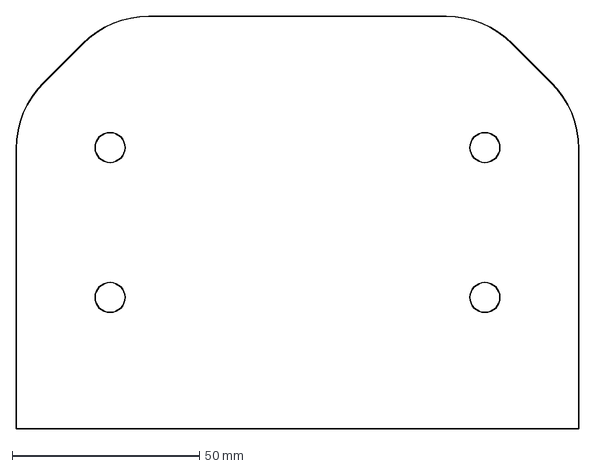
[picture p81: CAD file, 2014-06-24]
mechanic/Robot Arm/Gripper Base 2 - X2.DXF
150.0 x 110.0 mm
