mekatronik-achmadi/spion_selector/mechanic/Robot Arm/Gripper Pivot Base 1 - X1.DXF

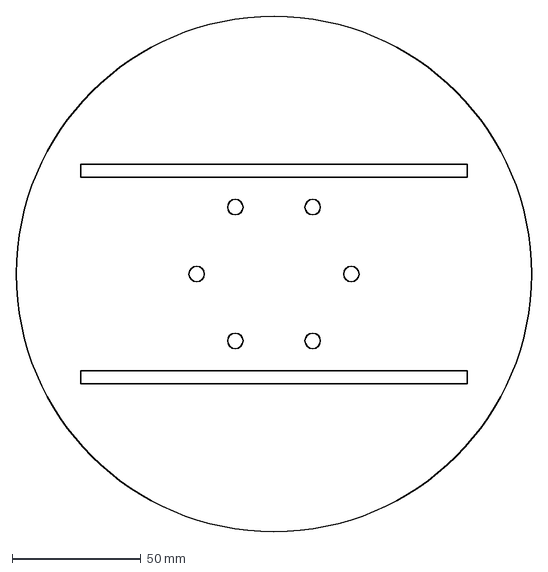
[picture p82: CAD file, 2014-06-24]
mechanic/Robot Arm/Gripper Pivot Base 1 - X1.DXF
200.0 x 200.0 mm
