mekatronik-achmadi/spion_selector/mechanic/Robot Arm/Gripper Arm 2 - X2.DXF

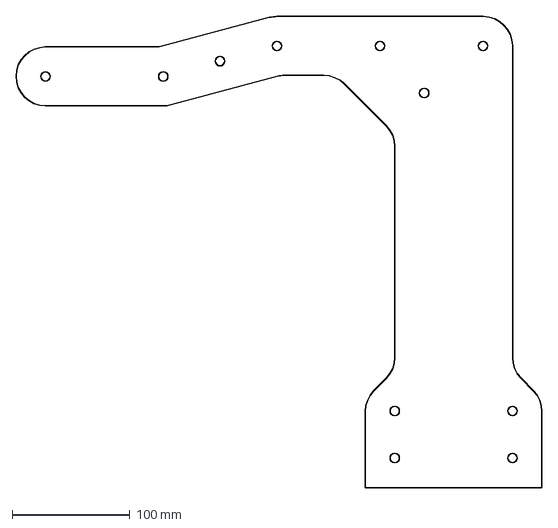
[picture p83: CAD file, 2014-06-24]
mechanic/Robot Arm/Gripper Arm 2 - X2.DXF
446.6 x 400.0 mm
