mekatronik-achmadi/spion_selector/mechanic/Robot Arm/Gripper Arm 3 - X1.DXF

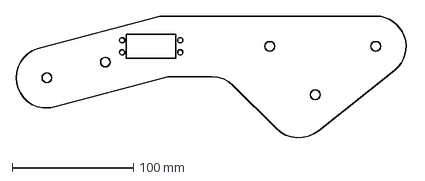
[picture p84: CAD file, 2014-06-24]
mechanic/Robot Arm/Gripper Arm 3 - X1.DXF
323.9 x 103.1 mm
