mekatronik-achmadi/spion_selector/mechanic/Robot Arm/Gripper Holder - X4.DXF

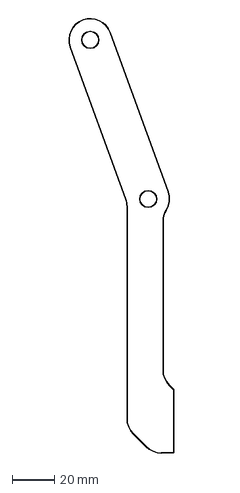
[picture p85: CAD file, 2014-06-24]
mechanic/Robot Arm/Gripper Holder - X4.DXF
50.6 x 206.5 mm
