mekatronik-achmadi/spion_selector/mechanic/Robot Arm/Gripper Gear B - X1.DXF

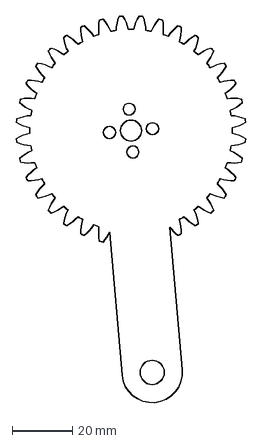
[picture p86: CAD file, 2014-06-24]
mechanic/Robot Arm/Gripper Gear B - X1.DXF
75.8 x 128.3 mm
