mekatronik-achmadi/spion_selector/mechanic/Robot Arm/Gripper Linkage - X4.DXF

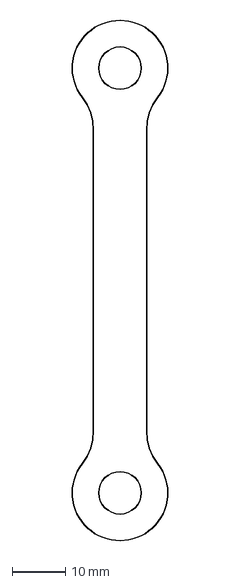
[picture p87: CAD file, 2014-06-24]
mechanic/Robot Arm/Gripper Linkage - X4.DXF
20.0 x 99.6 mm
