mekatronik-achmadi/spion_selector/(list of files, cad)

Other CAD files:
mechanic/old_skp/spion_arm.skp
mechanic/spion_arm.skp
