mekatronik-achmadi/spion_selector/octave_works/result-a/AR1a.jpg

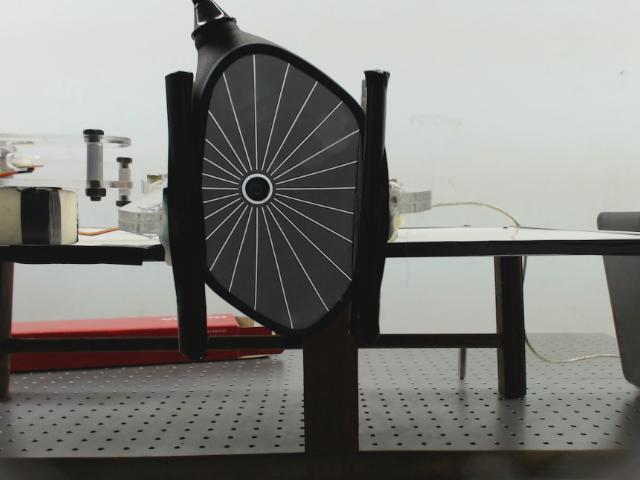
octave_works/result-a/AR1a.jpg
