mekatronik-achmadi/spion_selector/octave_works/result-a/AR2a.jpg

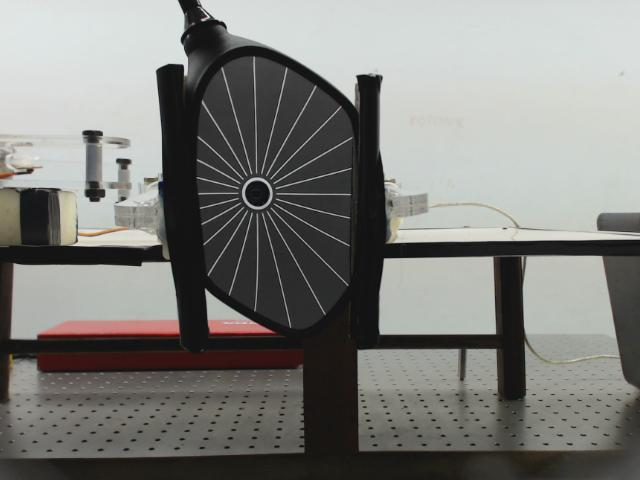
octave_works/result-a/AR2a.jpg
