mekatronik-achmadi/spion_selector/octave_works/result-a/AR2b.jpg

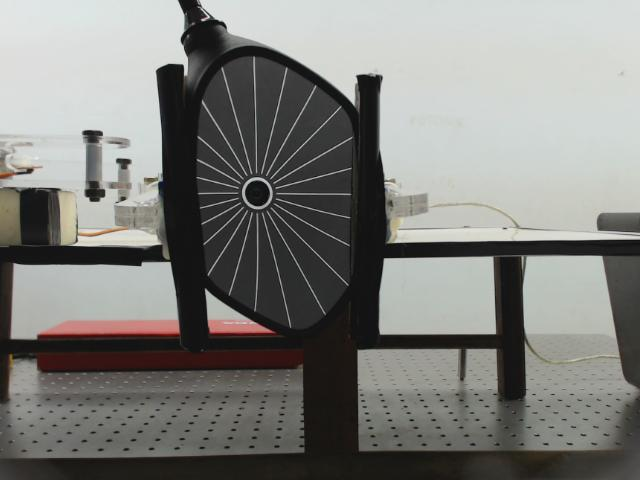
octave_works/result-a/AR2b.jpg
