mekatronik-achmadi/spion_selector/octave_works/result-a/AR3a.jpg

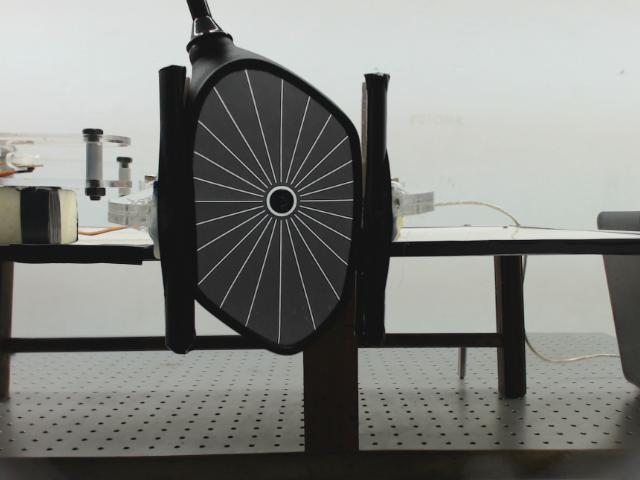
octave_works/result-a/AR3a.jpg
