mekatronik-achmadi/spion_selector/octave_works/result-a/AR4a.jpg

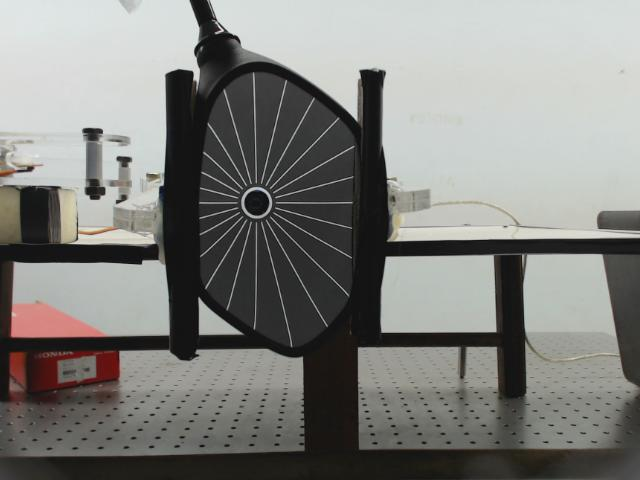
octave_works/result-a/AR4a.jpg
