mekatronik-achmadi/spion_selector/octave_works/result-a/AR5a.jpg

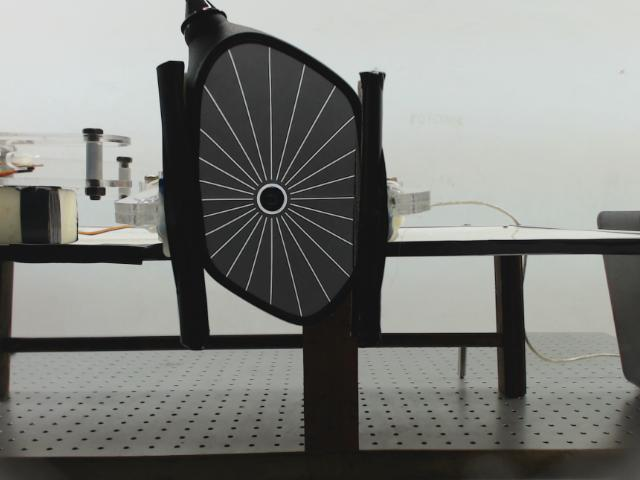
octave_works/result-a/AR5a.jpg
