mekatronik-achmadi/spion_selector/octave_works/result-a/BL1c.jpg

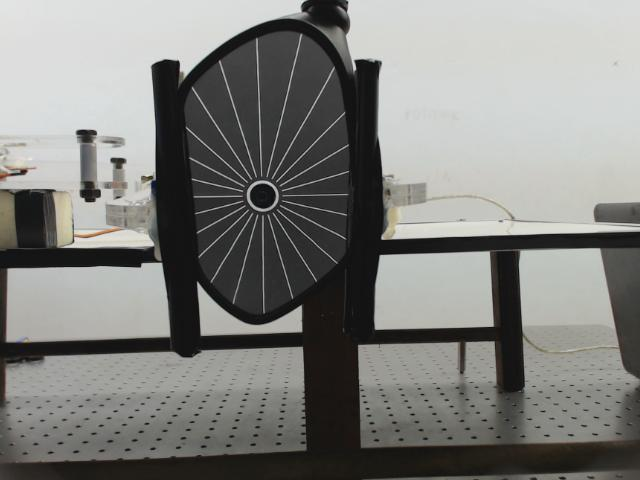
octave_works/result-a/BL1c.jpg
