mekatronik-achmadi/spion_selector/octave_works/result-a/BL3a.jpg

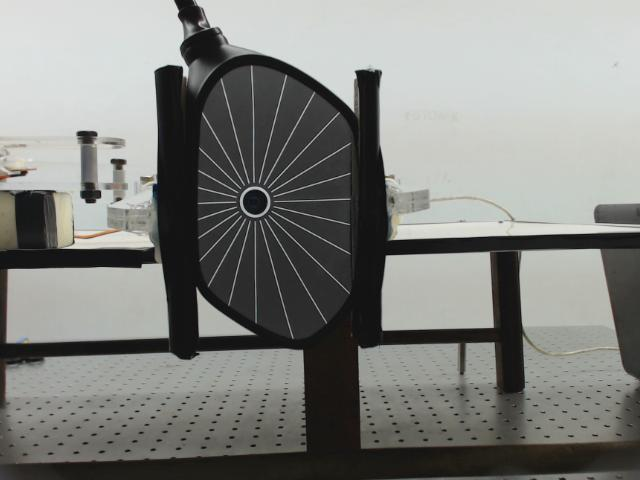
octave_works/result-a/BL3a.jpg
