mekatronik-achmadi/spion_selector/octave_works/result-a/BR2a.jpg

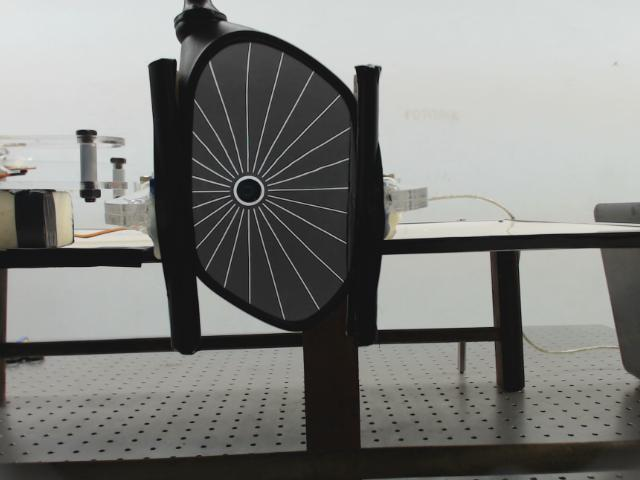
octave_works/result-a/BR2a.jpg
