mekatronik-achmadi/spion_selector/octave_works/result-b/AR1a.jpg

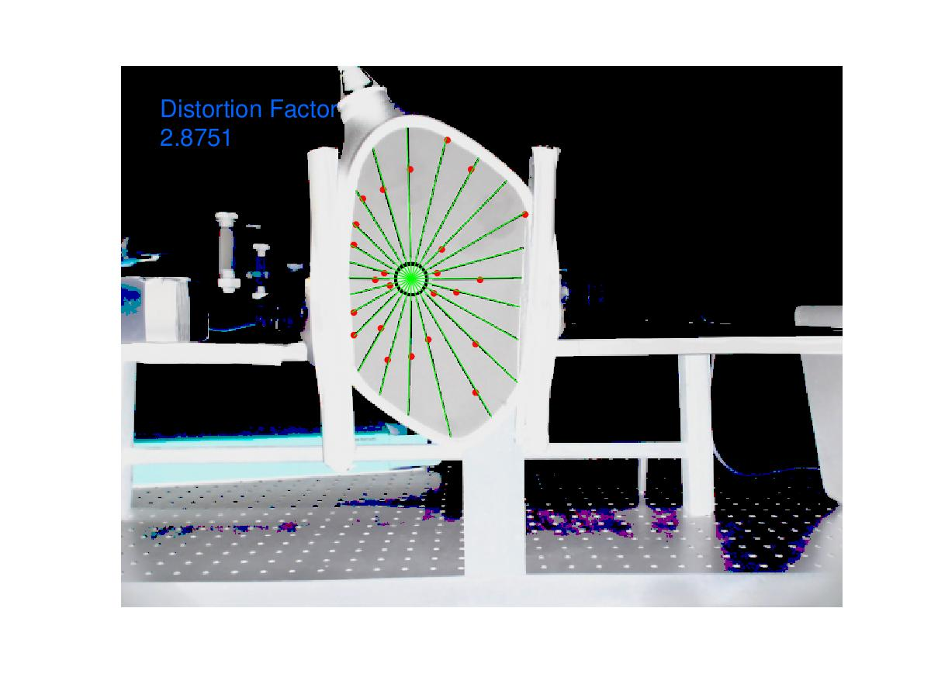
octave_works/result-b/AR1a.jpg
