mekatronik-achmadi/spion_selector/octave_works/result-b/AR2b.jpg

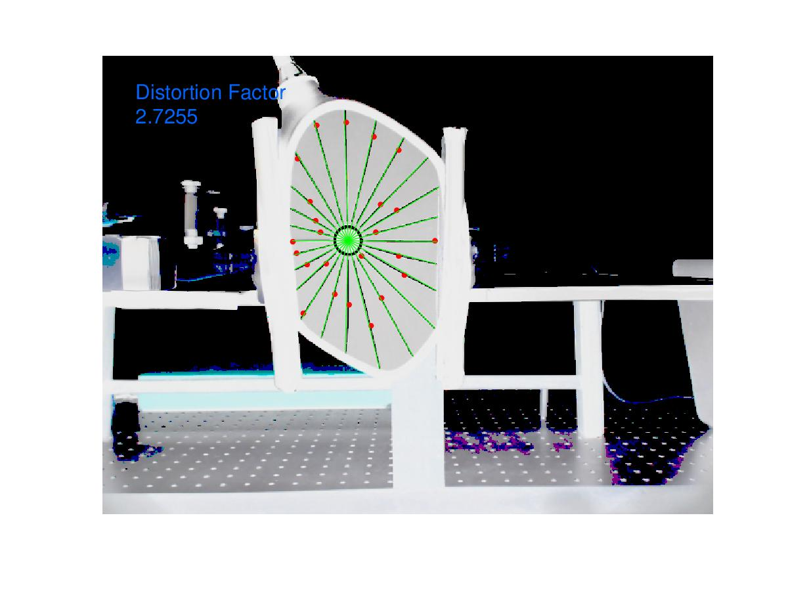
octave_works/result-b/AR2b.jpg
