mekatronik-achmadi/spion_selector/octave_works/result-b/BL1a.jpg

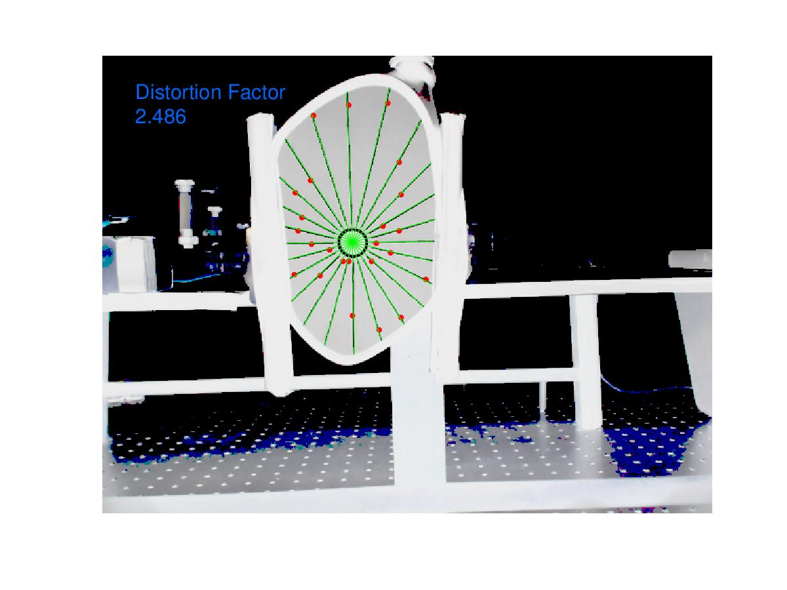
octave_works/result-b/BL1a.jpg
