mekatronik-achmadi/spion_selector/octave_works/result-b/BR3a.jpg

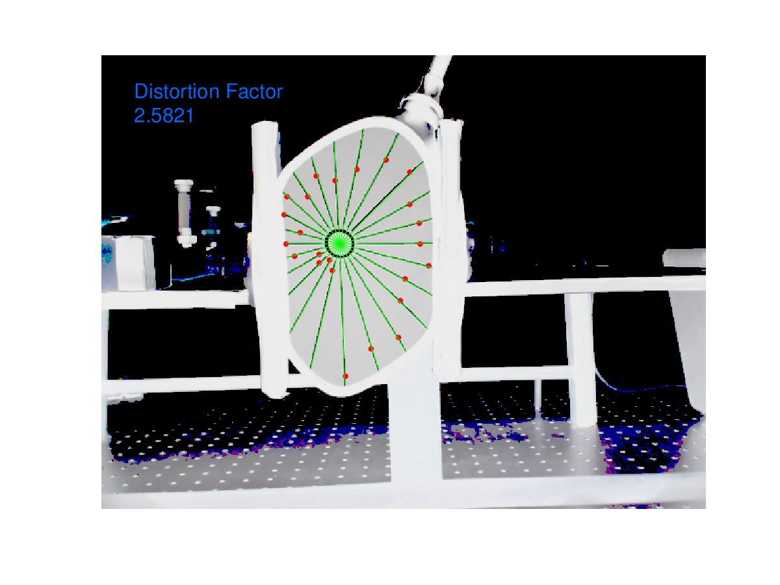
octave_works/result-b/BR3a.jpg
