mekatronik-achmadi/spion_selector/poster/rsc/result.png

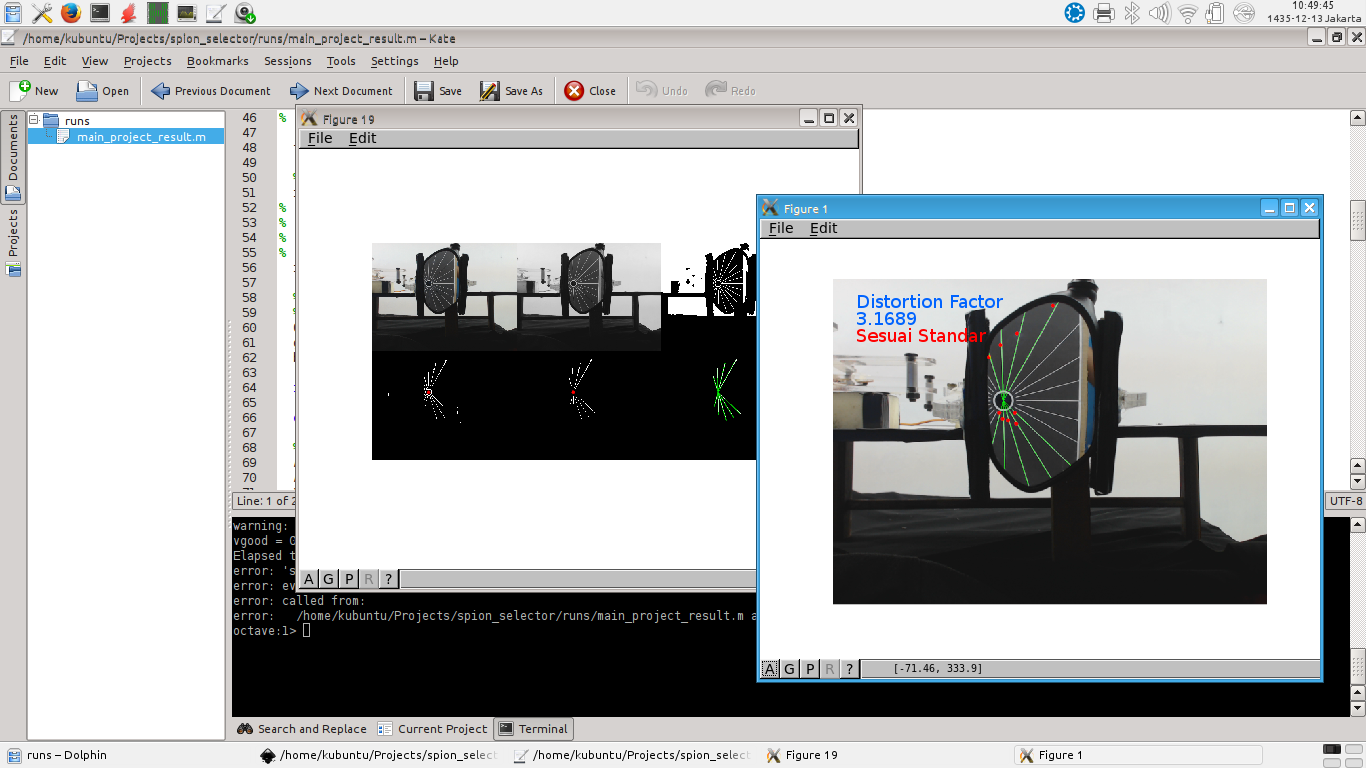
poster/rsc/result.png
