mekatronik-achmadi/spion_selector/docs/screenshot/arm/GA.PDF

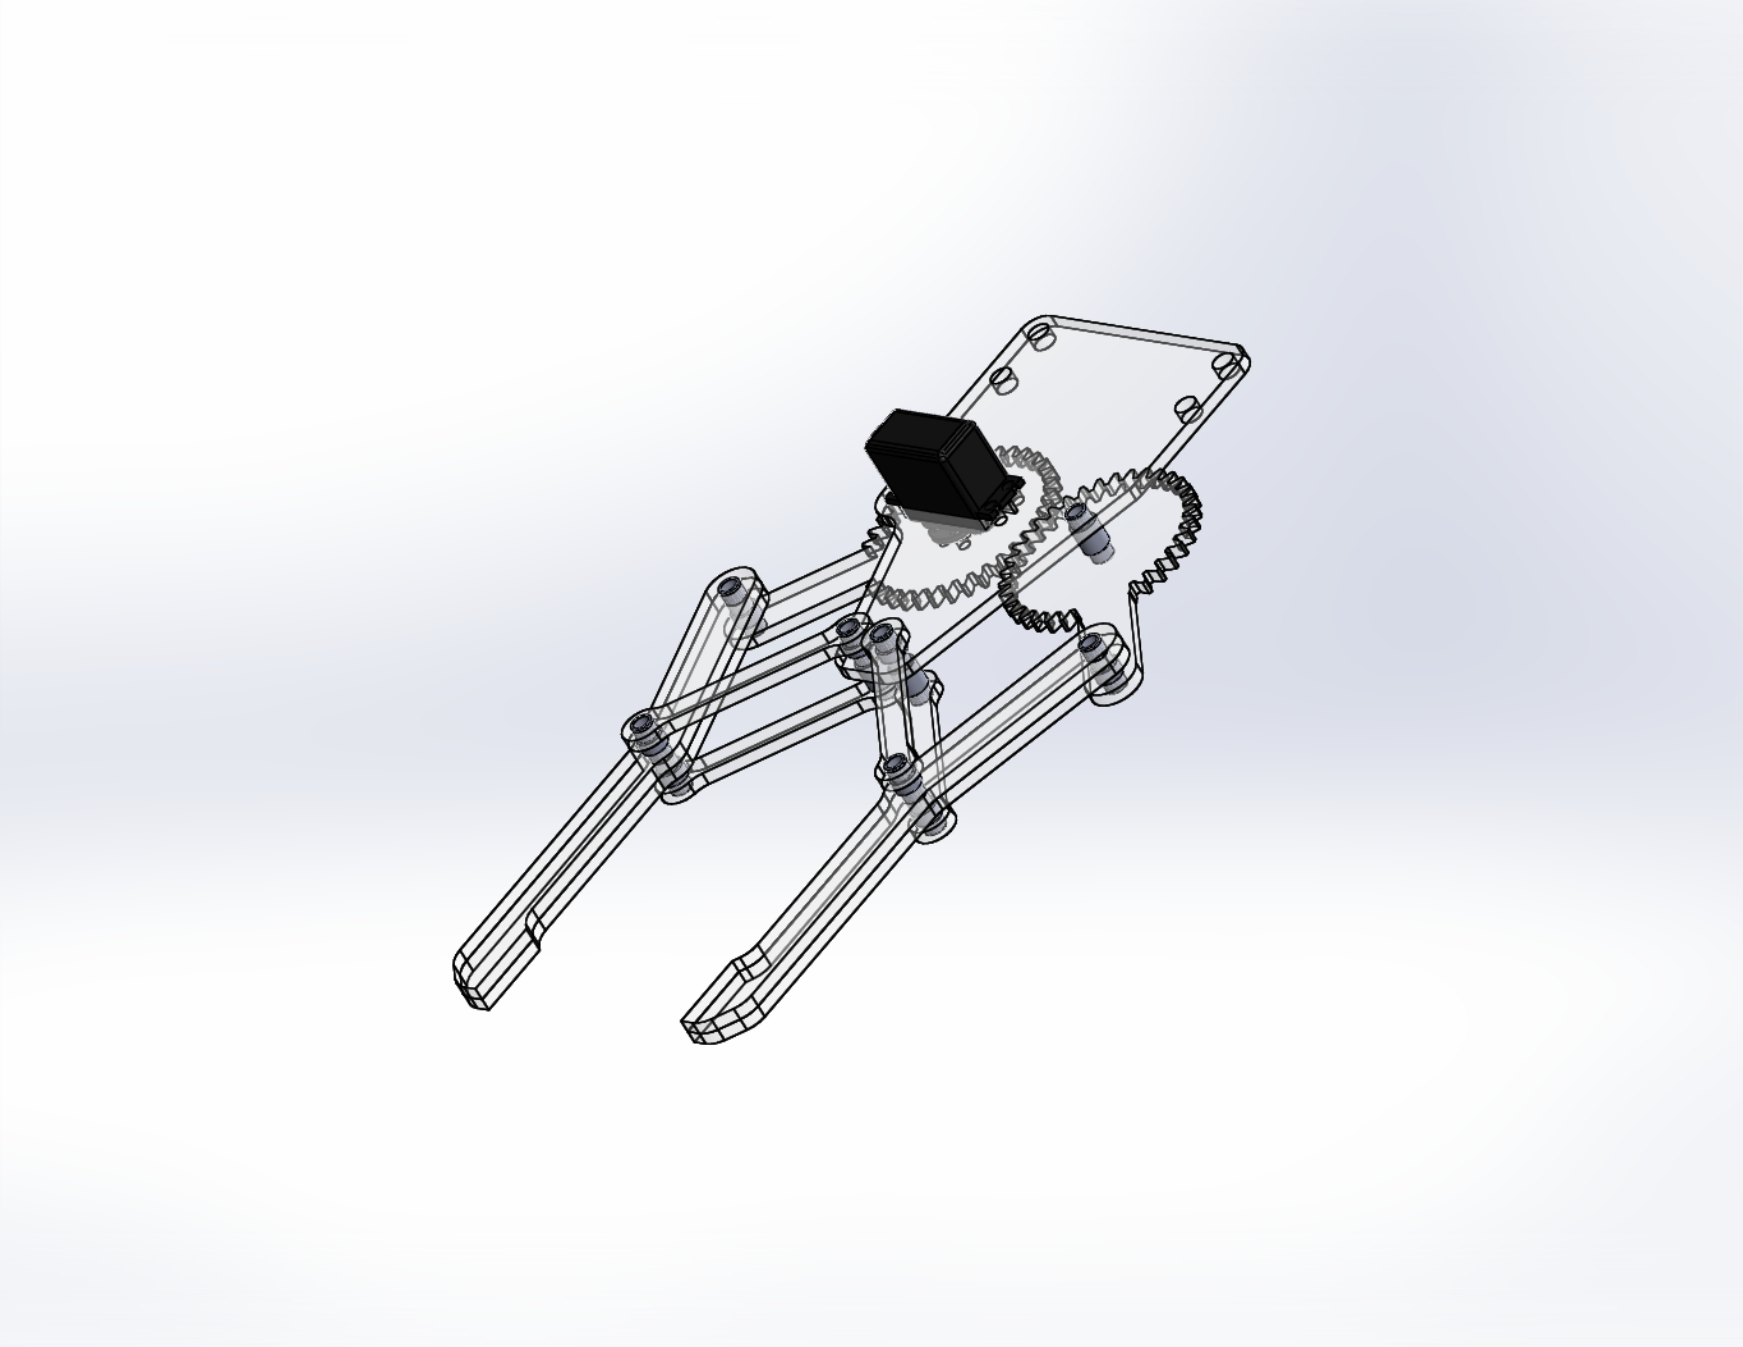
[picture p102: page 1]
