mekatronik-achmadi/spion_selector/docs/screenshot/arm/GA1.PDF

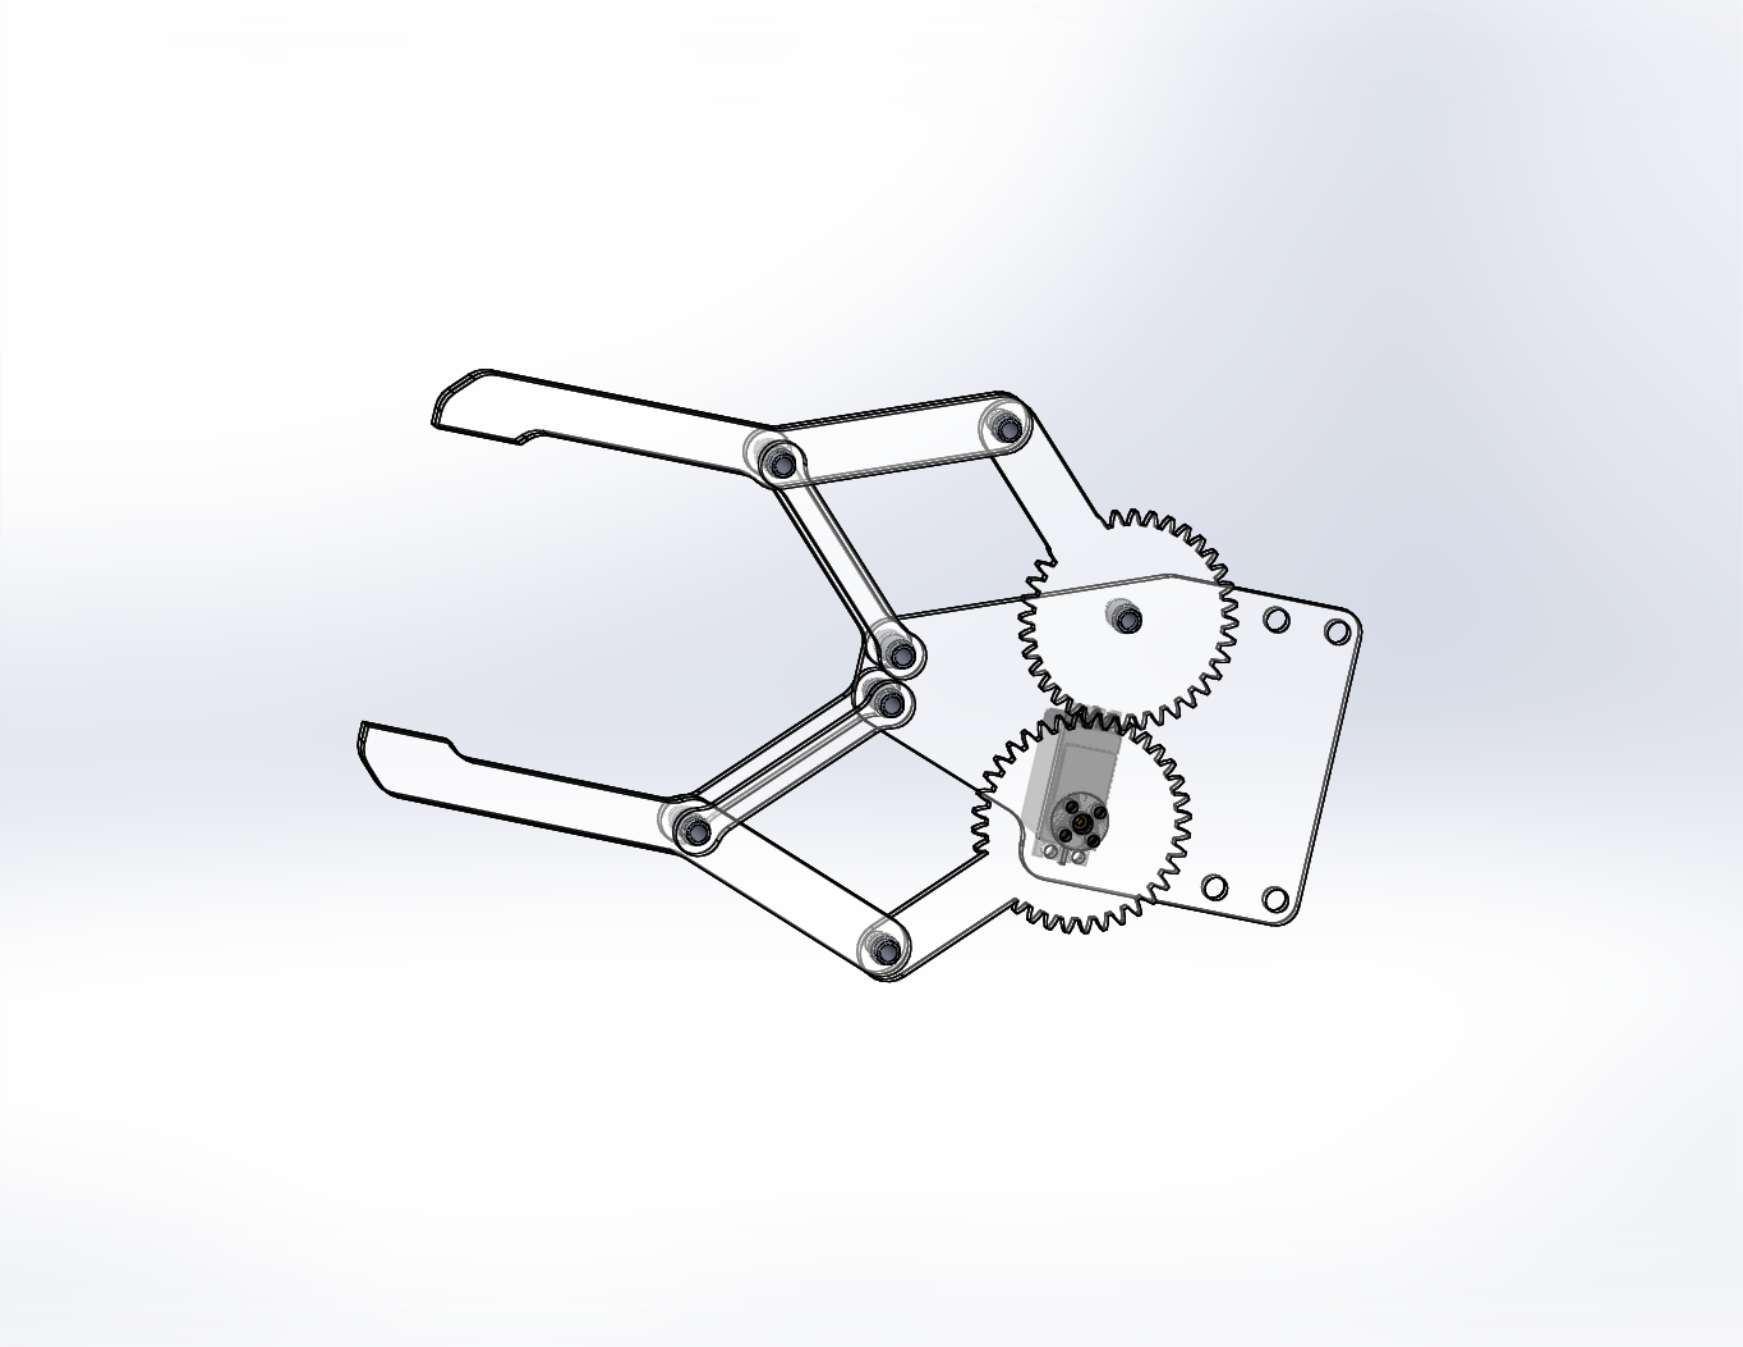
[picture p103: page 1]
