mekatronik-achmadi/spion_selector/docs/screenshot/arm/GAF.PDF

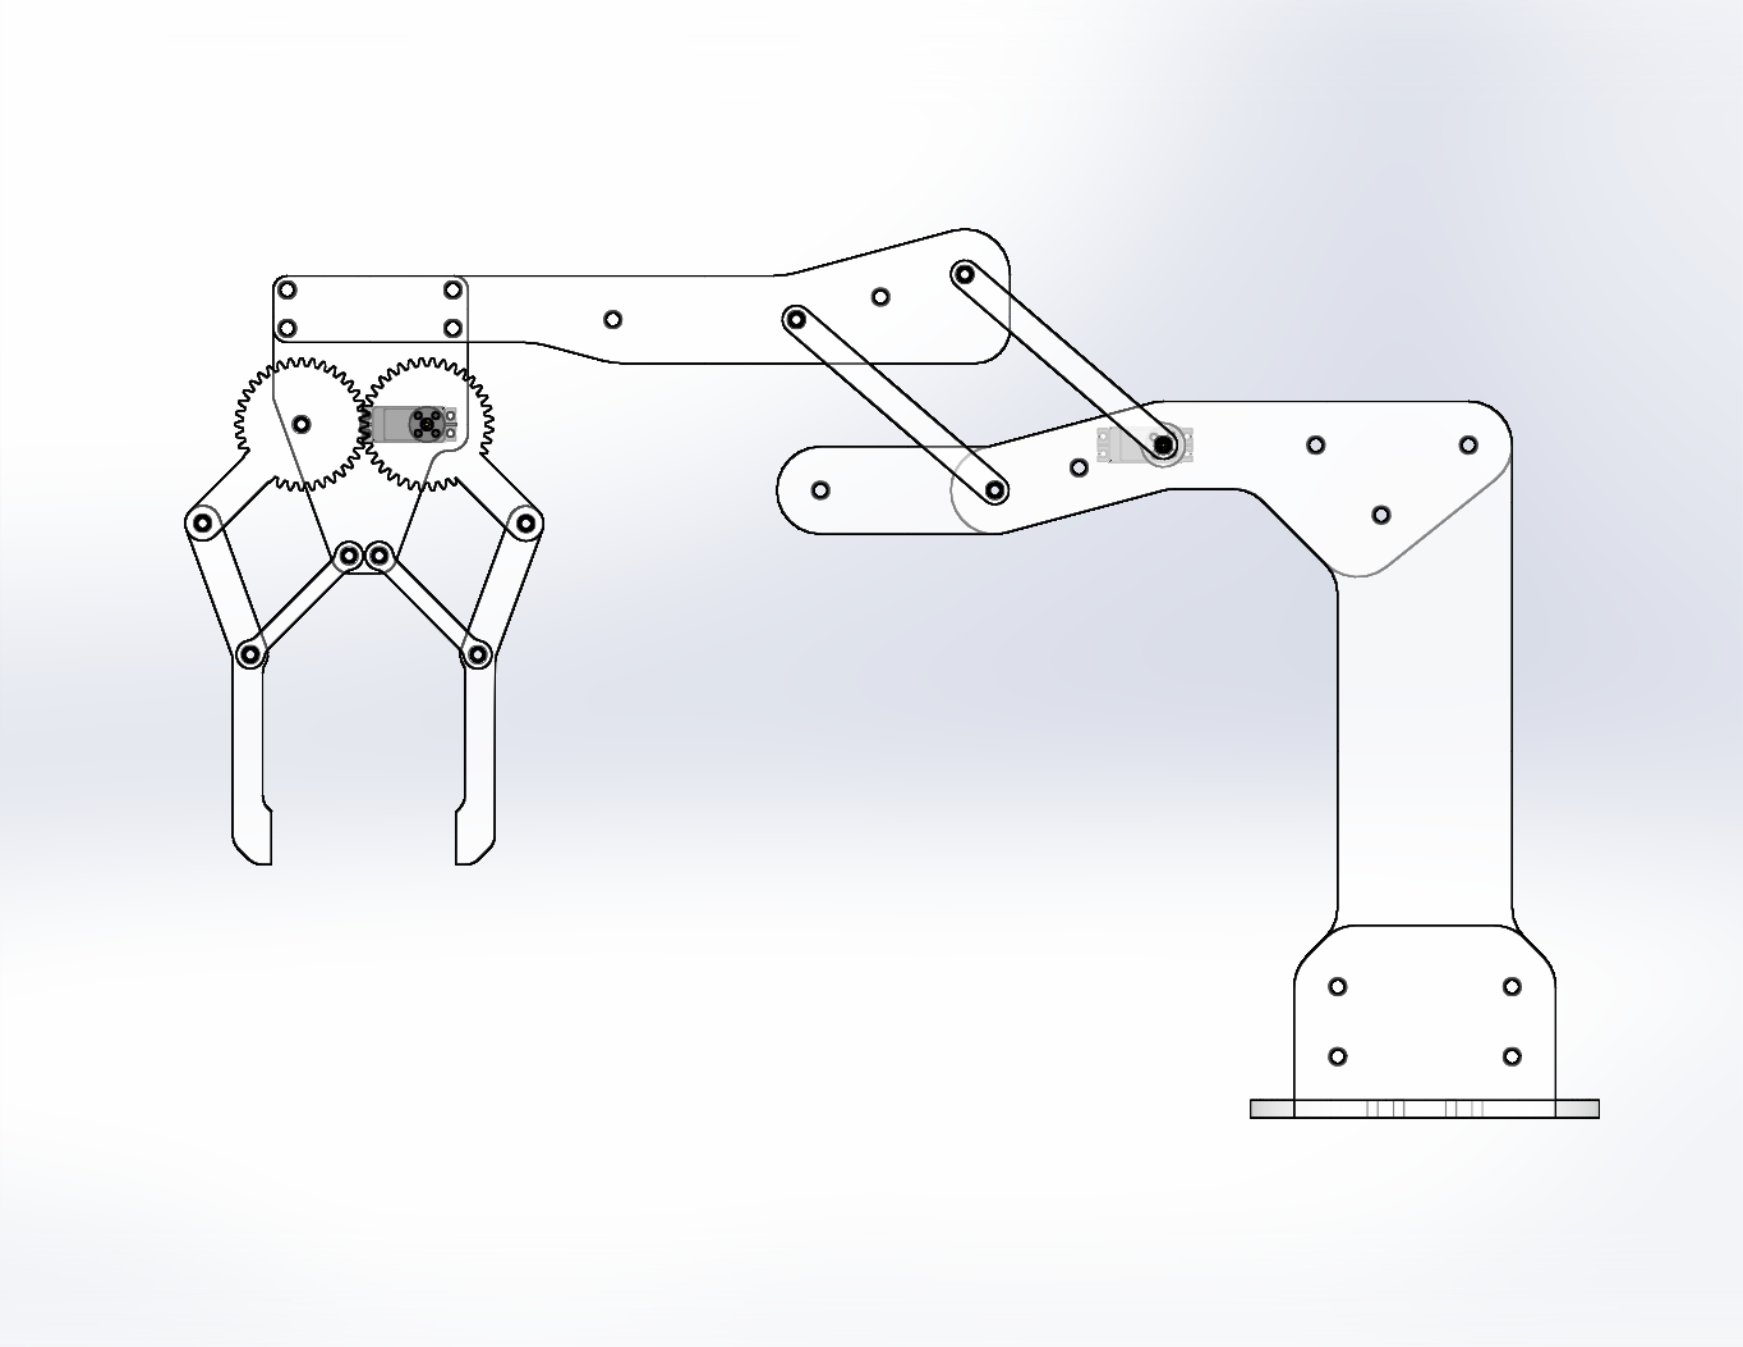
[picture p104: page 1]
