mekatronik-achmadi/spion_selector/docs/screenshot/arm/GAF1.PDF

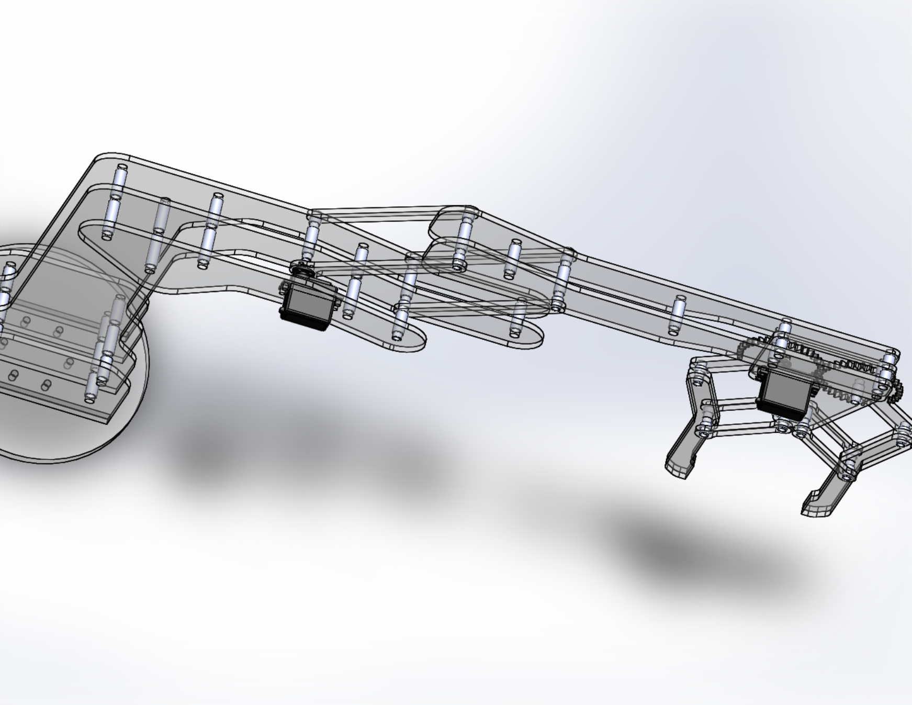
[picture p105: page 1]
