mekatronik-achmadi/spion_selector/boards/PCB/spion.brd

## EAGLE design boards/PCB/spion.brd (2014-06-06)

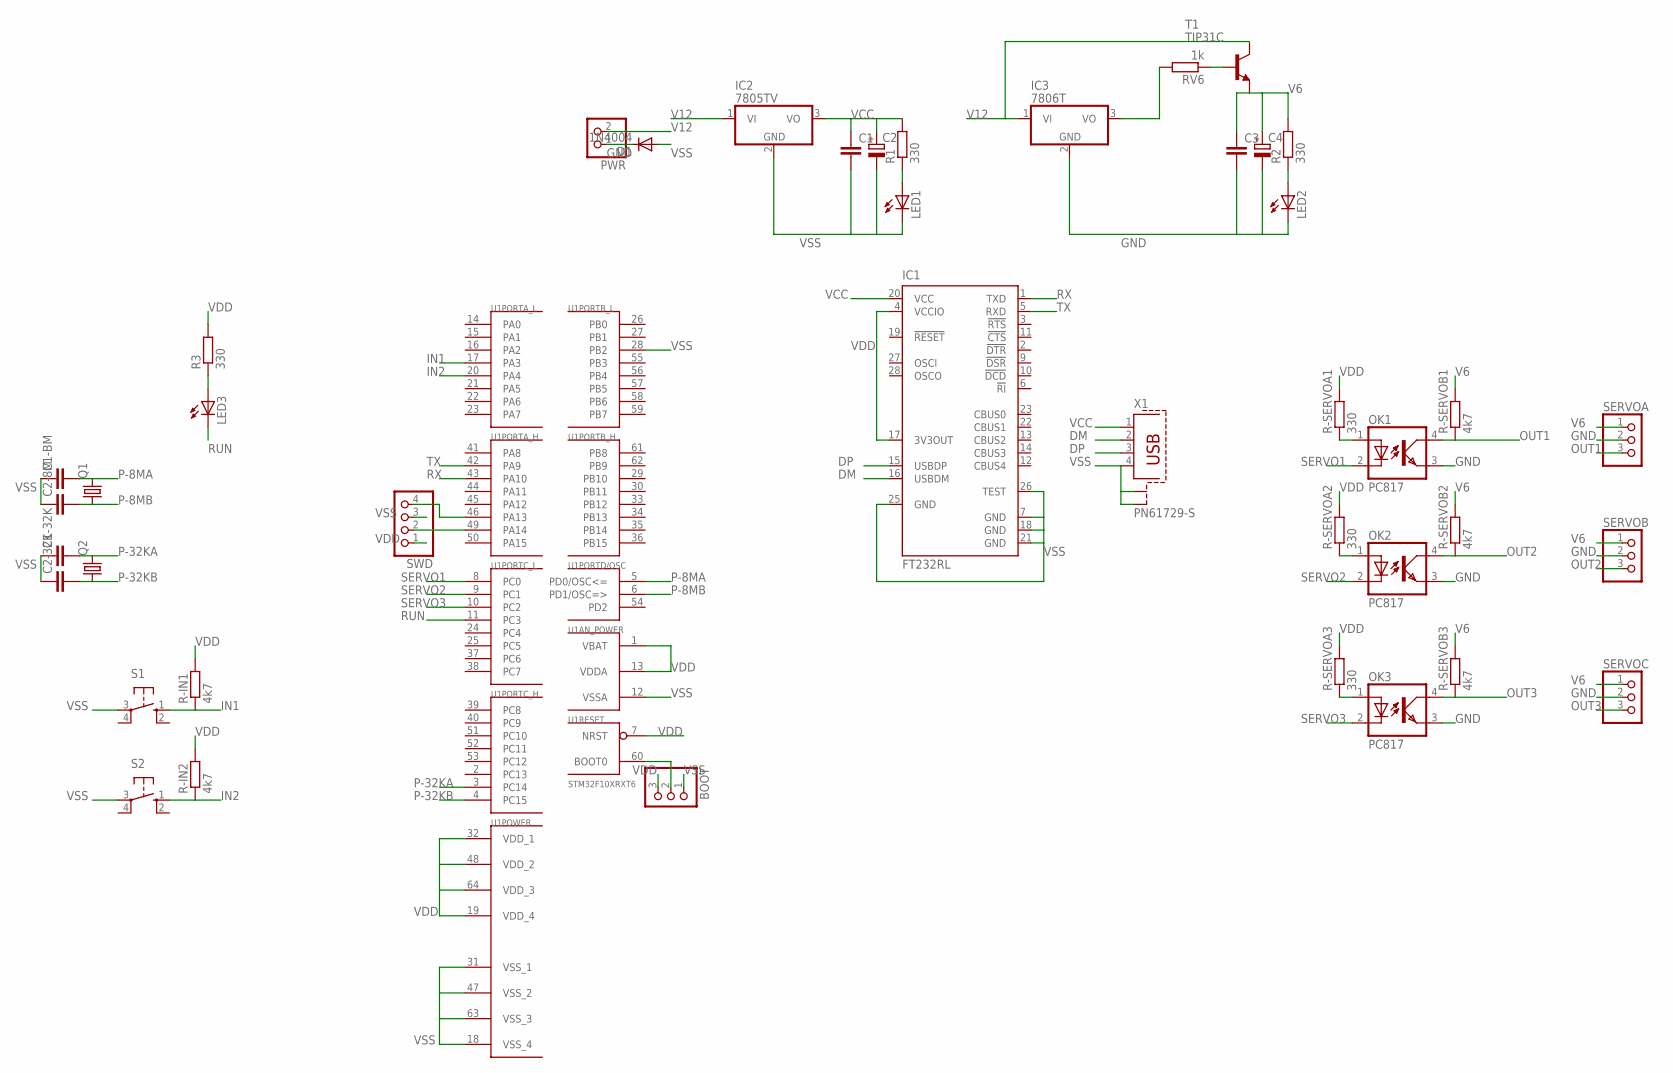
[picture p106: schematic spion.sch]

Parts:
BOOT: PINHD-1X3; 1X03
C1, C1-32K, C1-BM, C2-8M, C2-32K, C3: C-EU025-024X044; C025-024X044
C2, C4: CPOL-EUE2-5; E2-5
D1: 1N4004; DO41-10
IC1: FT232RL; SSOP28
IC2: 7805TV; TO220V
IC3: 7806T; TO220H
LED1, LED2, LED3: LED3MM
OK1, OK2, OK3: PC817; DIL04
PWR: PINHD-1X2; 1X02
Q1: CRYSTALHC49S; HC49/S
Q2: CRYSTALTC26V; TC26V
R1, R2, R3: 330; 0204/7
R-IN1, R-IN2: 4k7; 0204/7
R-SERVOA1, R-SERVOA2, R-SERVOA3: 330; 0204/7
R-SERVOB1, R-SERVOB2, R-SERVOB3: 4k7; 0204/7
RV6: 1k; 0204/7
S1, S2: 10-XX; B3F-10XX
SERVOA: PINHD-1X3; 1X03
SERVOB: PINHD-1X3; 1X03
SERVOC: PINHD-1X3; 1X03
SWD: PINHD-1X4; 1X04
T1: TIP31C; TO220
U1: STM32F10XRXT6; TQFP64
X1: PN61729-S

Connections:
DM: IC1.16 (USBDM), X1.2
DP: IC1.15 (USBDP), X1.3
GND: C3.2, C4.-, D1.C, IC3.2 (GND), LED2.K (C), OK1.3 (EMIT), OK2.3 (EMIT), OK3.3 (EMIT), PWR.1, SERVOA.2, SERVOB.2, SERVOC.2
IN1: R-IN1.1, S1.1 (S), U1.17 (PA3)
IN2: R-IN2.1, S2.1 (S), U1.20 (PA4)
unnamed: SWD.2, U1.49 (PA14)
unnamed: SWD.4, U1.46 (PA13)
unnamed: BOOT.2, U1.60 (BOOT0)
unnamed: OK1.1 (A), R-SERVOA1.1
unnamed: LED3.A, R3.1
unnamed: IC3.3 (VO), RV6.2
unnamed: OK2.1 (A), R-SERVOA2.1
unnamed: RV6.1, T1.1 (B)
unnamed: OK3.1 (A), R-SERVOA3.1
unnamed: LED1.A, R1.1
unnamed: LED2.A, R2.1
OUT1: OK1.4 (COL), R-SERVOB1.1, SERVOA.3
OUT2: OK2.4 (COL), R-SERVOB2.1, SERVOB.3
OUT3: OK3.4 (COL), R-SERVOB3.1, SERVOC.3
P-8MA: C1-BM.2, Q1.2, U1.5 (PD0/OSC<=)
P-8MB: C2-8M.2, Q1.1, U1.6 (PD1/OSC=>)
P-32KA: C1-32K.2, Q2.2, U1.3 (PC14)
P-32KB: C2-32K.2, Q2.1, U1.4 (PC15)
RUN: LED3.K (C), U1.11 (PC3)
RX: IC1.1 (TXD), U1.43 (PA10)
SERVO1: OK1.2 (C), U1.8 (PC0)
SERVO2: OK2.2 (C), U1.9 (PC1)
SERVO3: OK3.2 (C), U1.10 (PC2)
TX: IC1.5 (RXD), U1.42 (PA9)
V6: C3.1, C4.+, R2.2, R-SERVOB1.2, R-SERVOB2.2, R-SERVOB3.2, SERVOA.1, SERVOB.1, SERVOC.1, T1.3 (E)
V12: IC2.1 (VI), IC3.1 (VI), PWR.2, T1.2 (C)
VCC: C1.1, C2.+, IC1.20 (VCC), IC2.3 (VO), R1.2, X1.1
VDD: BOOT.3, IC1.4 (VCCIO), IC1.17 (3V3OUT), R3.2, R-IN1.2, R-IN2.2, R-SERVOA1.2, R-SERVOA2.2, R-SERVOA3.2, SWD.1, U1.1 (VBAT), U1.7 (NRST), U1.13 (VDDA), U1.19 (VDD_4), U1.32 (VDD_1), U1.48 (VDD_2), U1.64 (VDD_3)
VSS: BOOT.1, C1.2, C1-32K.1, C1-BM.1, C2.-, C2-8M.1, C2-32K.1, D1.A, IC1.7 (GND), IC1.18 (GND), IC1.21 (GND), IC1.25 (GND), IC1.26 (TEST), IC2.2 (GND), LED1.K (C), S1.3, S2.3, SWD.3, U1.12 (VSSA), U1.18 (VSS_4), U1.28 (PB2), U1.31 (VSS_1), U1.47 (VSS_2), U1.63 (VSS_3), X1.4, X1.S1, X1.S2

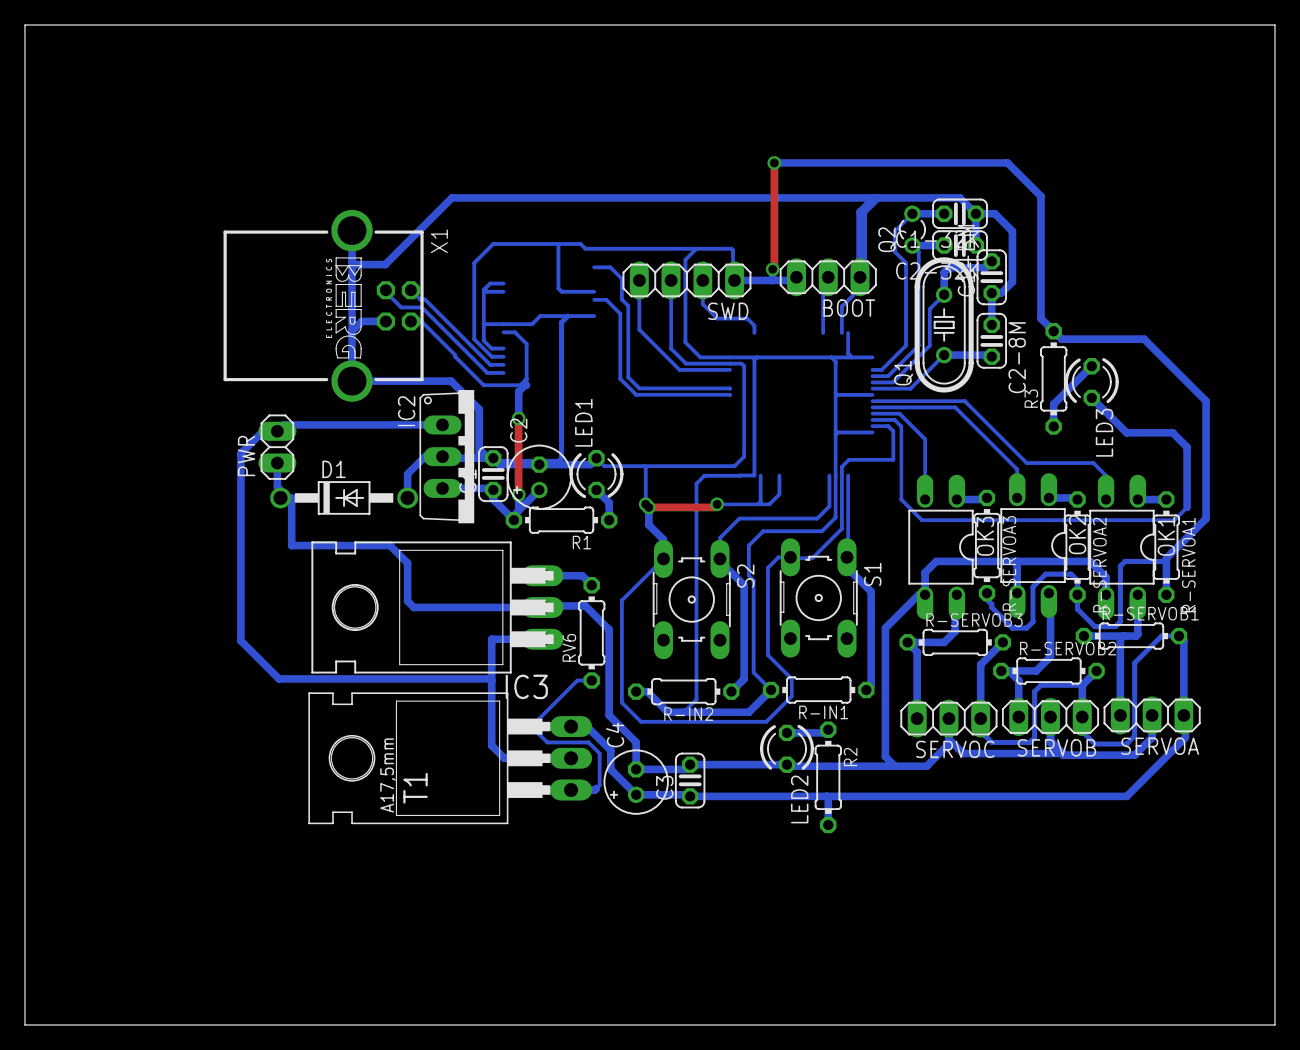
[picture p107: board spion.brd from above]

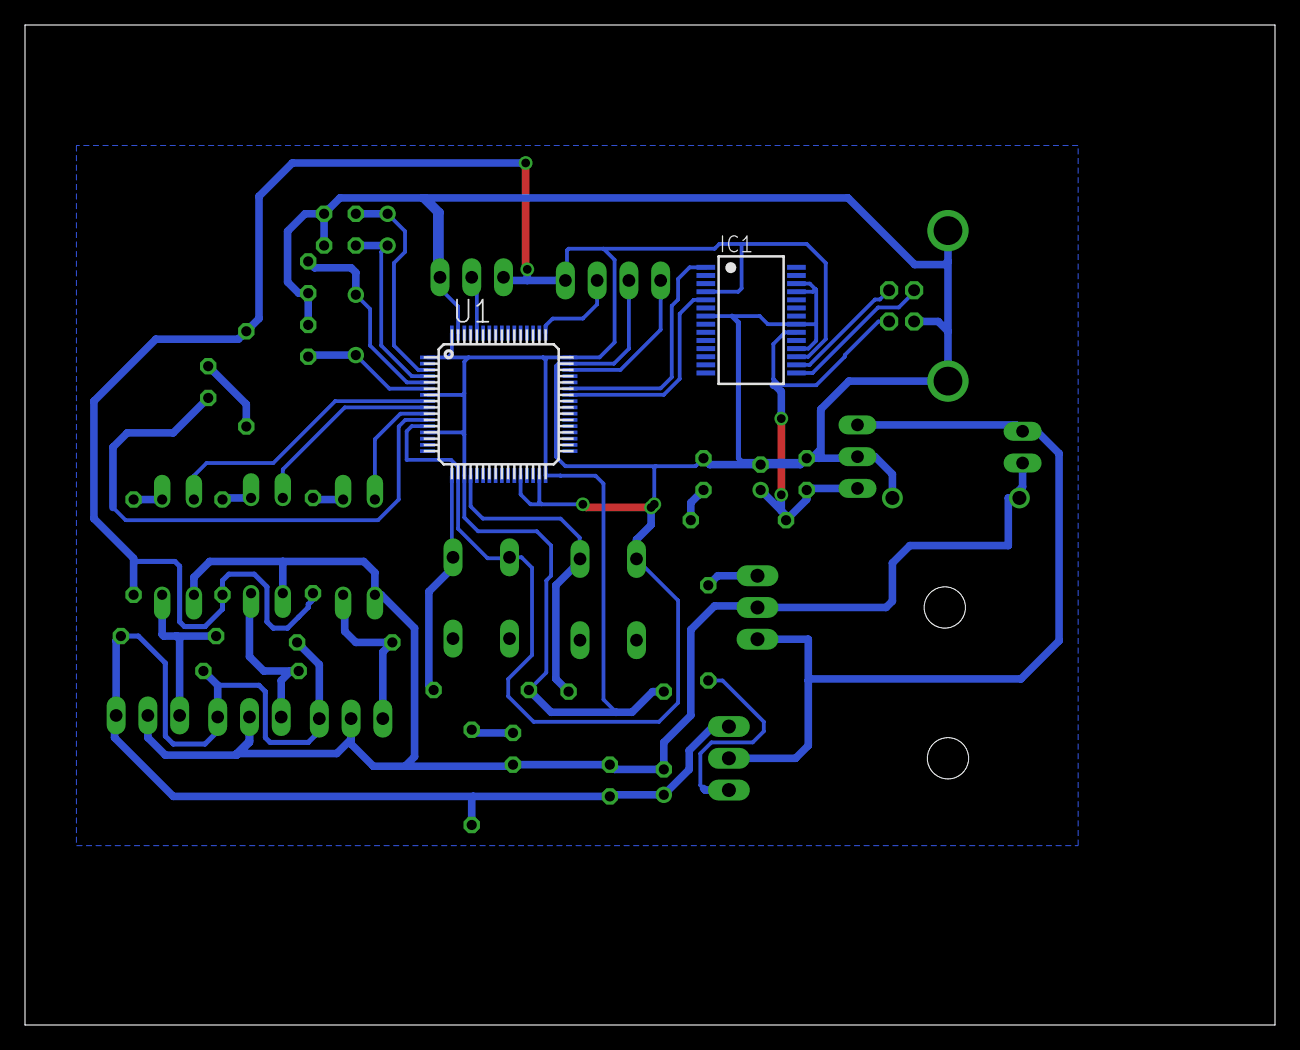
[picture p108: board spion.brd from below]

Board: 2 copper layers, 100.0 x 80.0 mm, 43 parts (2 on the bottom side), 34 nets.
