mekatronik-achmadi/spion_selector/(commit log)

2014-06-24 robot arm design on DXF
    [Gripper Arm 1 - X2.DXF, Gripper Arm 2 - X2.DXF, Gripper Arm 3 - X1.DXF, Gripper Arm Linkage - X3.DXF, Gripper Arm Linkage 2 - X1.DXF, Gripper Base - X1.DXF, Gripper Base 2 - X2.DXF, Gripper Gear A - X1.DXF]
2014-07-09 test run 1 success
    [spion_arm.skp]
2014-09-18 Data and Last Works
    [data-distorsi-xl.xls]
2014-10-09 poster ready to print
